Koede/robot-arm/renders_j1r2/mj11_leads/A_assembled_rear.png

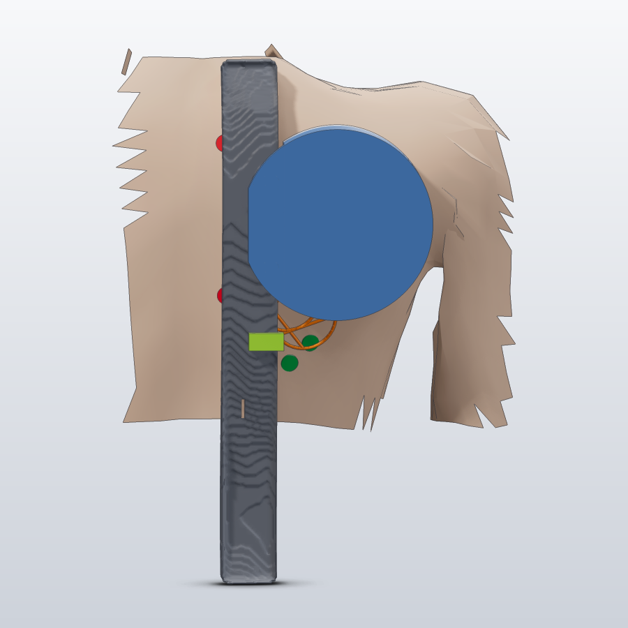
renders_j1r2/mj11_leads/A_assembled_rear.png
