Koede/robot-arm/DESIGN_STATE.md

# Third Shoulder — DESIGN_STATE (reconstructed)

> **Reconstructed 2026-10-25** from the repository: script docstrings in `cad/`, result JSON in `stl/`, logs, `specs/SPEC_collision_method.md` and `docs/DESIGN_STATE_ADDENDUM_2026-10-22.md`. The original DESIGN_STATE.md (about 40 KB, kept in the claude.ai project) was not available. Section numbers follow the references in the addendum (section 2 = joints, section 4 = harness/sensing, section 11 = integration); other numbering is new. Decisions, rationale and history that only lived in the original are missing; anything not traceable to a file here is left out rather than guessed. If the original turns up, it wins: merge this file's section 11 and changelog into it and delete this one.

Wearable supernumerary robot arm ("third shoulder"), one per shoulder, described as CAD-as-code. Right arm is generated; left = mirror in y (`*_L.stl`). Units mm, deg, N, N m, g.

## 1. Architecture

7 DOF + gripper per arm: S1, S2, S3 (concurrent shoulder axes through P), E (elbow), W1 (forearm roll), W2, W3 (2-DOF wrist), G (claw).

| Joint | Actuator | Source |
|---|---|---|
| S1, S2 | CubeMars AK70-10 (dia 89 x 50.25, 621 g, 8.3 N m rated / 24.8 peak, 24/48 V) | `shoulder_stage.py`, vendor-verified |
| S3, E | Dynamixel XM540-W270 (33.5 x 58.5 x 44, 165 g, 10.6 N m stall @ 12 V) | `shoulder_stage.py`, `upper_arm_elbow.py` |
| W1, W2, W3, G | Feetech STS3215 (55 g) | `distal_arm.py`, `claw_hand.py`, `verify_distal.py` |

Standing design language: ball-and-socket styling at every joint, passive hard stops with TPU capsule facings, DOF and actuator count unchanged by restyling.

Load path: stage -> pauldron -> 8 mm 6061-T6 chassis plate -> scapular frame / spine bridge -> hip belt. The faceted clasp locates sEMG pads and does not carry the arm.

## 2. Frames, kinematics, joint limits

Robot frame (right arm): origin P = shoulder centre where S1/S2/S3 meet; +x rearward, +y lateral (wearer's right), +z up. Arm rests pointing up (+z) at q = 0. Positive S2 swings the arm forward (-x). Human elevation = 180 - S2.

Chain (`arm_kin.py`): R1 = Rz(-S1); R2 = R1 Ry(-S2); R3 = R2 Rz(S3); RE = R3 T(0,0,230) Ry(-E) T(0,0,-230); RW1 = RE T(0,D,0) Rz(W1) T(0,-D,0); RW2 = RW1 T(0,D,Zw) Ry(-W2) T(0,-D,-Zw); RW3 = RW2 T(0,D,Zw3) Rx(W3) T(0,-D,-Zw3).

Layout (`stl/distal/distal.json`): elbow axis at z 230; D = 57; Zw = 410; Zw3 = 455; claw tip Z_TIP = 575. Kinematic groups: F (fixed stage + harness), M1, M2, M3, ME, MW1, MW2, MW3 (hand = W3 frame). The product-of-exponentials form in `collision_screw.py` matches `arm_kin.frames` to 1.7e-13.

Joint limits (`rom_limits.py`, single source; hard = soft +- 5, except S1 max):

| Joint | Soft | Hard | Park | Meaning |
|---|---|---|---|---|
| S1 | 10..140 | 5..150 | 45 | arm-plane swing; medial limit from head keep-out |
| S2 | -30..88 | -35..93 | 25 | elevation from up-rest; back lean capped by head keep-out |
| S3 | -70..90 | -75..95 | 0 | humeral rotation |
| E | 0..145 | -5..150 | 45 | elbow flexion |
| W1 | -80..80 | -85..85 | 0 | pronation / supination |
| W2 | -70..80 | -75..85 | 0 | wrist ext / flex |
| W3 | -20..30 | -25..35 | 0 | radial / ulnar |
| G | 0..100 | -5..105 | 50 | gripper % |

Rev 2026-10-12c (I1): S1 soft min -15 -> +10, S2 soft min -55 -> -30 because the straight arm came within -10 mm of the MakeHuman head/neck. Inside the new box the straight-arm capsule (P -> 590 mm, r 32) clears the head by >= 64.9 mm, so the passive stops alone keep a stretched arm out of the 60 mm head keep-out.

Software elbow tiers (`stl/elbow_limits_15mm_restricted.json`, from `sweep_full.py --restricted`): largest E with >= 15 mm to body/harness and >= 60 mm to head, per (S1, S2); -1 = no safe E. Examples: S1 10 / S2 >= 71 -> -1; S1 140 / S2 -30 -> -1; most of S1 62..140 allows 120-145. Not yet regenerated after the cowl / pauldron rebuild (section 11).

## 3. Shoulder stage and housings

- Stage parts (`shoulder_stage.py`, `stl/shoulder/meta.json`): s1_base 204.8 cm3, s1_clamp 33.6, s1s2_yoke 121.5, s2_clamp 36.9, s2_adapter 79.7, s3_bracket 103.4, s3_lid 12.7.
- Shoulder stops (`ball_stops.py`, `stops/stops.json`): S1 lug under the yoke disc striking two posts at r 54.75 (contact 5 / 150); S2 pads at -35 / 92. TPU 95A capsule pads, ~35 % strain at AK70 peak (459 N at r 54). TPU thickness S1 11, S2+ 7.5, S2- 11 mm.
- Socket cowl + humeral-head dome (`shoulder_cowl.py`, rev 2026-10-13, Forest: "make the shoulders not giant spheres"): replaces the 188 mm / 146 g ball (`ball_shell.py`, retired). Cowl 149.7 x 65 x 110 mm, 91.9 cm3, 117 g PETG, wall p5 3.2 mm, slot gap 3.2 mm (< 4 mm, no fingertip entry, ISO 13857), split at x = 0. Dome R 43.8..46.4, 17.4 cm3, 22 g.
- Pauldron (`pauldron.py`, group F, rev 2026-10-13 faceted socket + strut web; rev 2026-10-23 curved deltoid shell): socket housing round S1, 3 struts to the plate rear face (2 x M4 each), wrap-arms to clasp nodes F4 (acromion) and F1 (upper trapezius). The lateral side is a swept arc, crown 12 mm off the deltoid, rim curled inboard, outer edge near y 85 instead of 98. Split for 256 mm build volume: core 99 g, arm_lat 4 g, arm_med 36 g (PA-CF), half-lap splices 2 x M4 x 16.

## 4. Harness and sensing

- Wearer: MakeHuman CC0 base mesh re-posed and placed in the robot frame (`wearer_makehuman.py --back_to_p 108`).
- Clasp (`clasp_shoulder.py` + `organic_connector.py`): faceted, flat pads tangent to the body carrying inward sEMG electrodes; single smooth-blended SDF frame, 144.5 cm3, watertight. Bridge feet F5 mid-trap, F1 upper-trap, F4 acromion, R1 scapula, seated at x -88. Pulled on by a 32 mm webbing strap.
- Chassis plate (`chassis_axilla.py`): 6061-T6, 154 x 114 x 8 mm, x -88..-80, 18 holes, min web 10.7 mm, 338 g. Pocketing study `plate_pocket.py` (-80 g target, Morley/P2 FE, limit loads 24.8 N m about each axis + 75 N).
- Axilla cradle + front strap: cradle at (-183, 7, -262); strap 32 mm, 10 N spec, path 169 mm; edge to axilla apex 27.1, plexus proxy 64.2, AC joint 100.4 mm; max width-averaged line pressure 6.8 kPa at spec tension.
- Scapular frame (`scapular_frame.py`): the wing contacts only the paraspinal strip and bridges over the blade, which slides 5-10 cm under the skin at full elevation. Wing 108.6 cm3 / 125 g CF-PA; spine bridge 24.8 cm3 / 28 g; rail gap 7.5-15.8 mm, bridge gap 14-27 mm.
- sEMG atlas (`muscle_atlas.py`, rev 2026-10-14): bipolar pairs, 12 mm discs, IED 20 mm, sites from tape-measure landmark rules ray-cast to the mesh (`emg_rules.json`, `emg_atlas.json`). Rigid clasp pads on stable zones (delt_ant F2, pec_clav F3, ...); others on a compression base layer. Scapular bone landmarks are estimated and flagged. SENIAM pages were unreachable; rules come from secondary sources (B18, B20, Cram, IZ literature) and four textbook-only rules are flagged.

## 5. Upper arm and elbow

`upper_arm_elbow.py` (rev 2026-10-13b elbow ball): XM540 at the elbow axis (0, 0, 230), shell halves ua_lat 81.8 g / ua_med 84.6 g PETG, fork_drive 29.0, fork_idler 30.9, fork_bridge 18.1 g. Elbow is a ball-styled hinge: sphere R_E 44 (inner 41.6), fixed belt |y| <= 24.7 on the upper arm, moving polar caps on the forks with a 1.0 mm running gap. Hand calcs in `calc_elbow.py`.

## 6. Distal arm and claw

- `distal_arm.py` (I6): forearm root, W1 roll (pinion + internal ring gear, 6808-2RS bearing), distal forearm, W2 yoke. `distal_stops.py`: rigid sector posts with TPU 95A facings placed so first contact is at the hard stop (`stops_distal.json`).
- Claw C3 (`claw_hand.py`, `claw_synth.py`, `claw_asm.py`, session 2026-10-13g): three identical double-jointed curl fingers 120 deg apart, one STS3215 on the hand axis turning a 3-start helical rotor, punch ring on three steel pins drives all fingers. Hand tray 64.4 cm3. Envelope nearly G-independent (z max 562.1 / 563.5 / 562.5 at G 0 / 50 / 100). Pin retention (rev 2026-10-15, Forest-approved): each dowel pressed in one member, running in the other.

## 7. S2 gravity balancer (I1b)

`balancer_calc.py` (single source) / `balancer.py`, rev e 2026-10-15 (parts rev f): zero-length compression spring + Dyneema cord over a swivelling sheave, tau_b = K sin(S2), K = 3.78 N m. A = (0, 50, 22) on M1, B = (0, 50, 47) on M2.
- Spring: music wire d 3.2, OD 36.9, 7.5 active coils, k 3.65 N/mm, free 87.7, solid 30.4.
- Over 53,460 poses: no-balancer max 6.55 N m; minimax residual with balancer 2.89 N m. Peak cancellation 57.6 % at E 0 / 0.5 kg, 40.6 % at E 90, -15.9 % at E 145.
- Free-fall energy to the + stop: 4.69 J loaded (8.1 J without the balancer).
- AK70 S2 bearing: max radial 194.5 N, tilting moment 11.67 N m.
- Parts (PA12-CF unless noted): anchor 100.2 g, tubecap 20.8, piston 9.4, collar 42.0, collar cap 10.5, TPU buffer 7.8, swivel 11.7 (7075), sheave 2.3 (6061).
- Restricted sweep: balancer min clearance 20.0 mm, 0 poses below 3 mm.

## 8. In-arm wiring and electronics

- Method (`arm_wiring_lib.py`, `arm_wire_search.py`, `arm_chain.py`, `arm_wiring_verify.py`, `wire_audit.py`): per-group SDFs (`stl/electronics/_sdf/`), elastic-rod cable loops between printed clamps. Pass: clearance >= 2.0 mm robust, 0.8-2.0 marginal (sleeve), < 0.8 fail; bend radius >= k x OD; stretch < 3 %. Kinematic envelope, not mechanics; bench test T-W1 to confirm.
- Arm hub H1 (`arm_hub.py`): 12 V servo-bus distribution in the upper-arm tube (TVS, 2 x 470 uF, two resettable fuses), no MCU; buses driven by a Teensy in the main box. CAN termination plug at S2.
- Current loop audit (`stl/electronics/wire_audit_v2.json`, 16 combined poses each):

| Joint | L mm | min clr mm | min bend / need mm | fails |
|---|---|---|---|---|
| S1 | 250.6 | 5.06 | 33.2 / 34.7 | 0 |
| S2 | 298.8 | 9.63 | 40.6 / 28.4 | 0 |
| S3 | 176.4 | 0.80 | 21.8 / 28.4 | 2 clr, 7 bend (marginal) |
| E | 191.6 | 10.0 | 28.5 / 23.9 | 0 (new loop, 2026-10-22) |
| W1 | 203.1 | 0.80 | 13.3 / 13.2 | 3 clr |
| W2 | 97.5 | -2.18 | 2.8 / 13.2 | 6 clr, 6 bend (FAIL) |
| W3 | 111.3 | 0.09 | 5.9 / 12.0 | 4 clr, 2 bend (FAIL) |

- In-link runs vs anchor chord: E -> W1 (ME) run 22.3 mm for a 118.9 mm chord (ratio 0.19) and W1 -> W2 0.41 are invalid after the new elbow anchors.
- Through-axis routing is blocked on most axes (`axis_corridor.py`, `axis_offset.py`, `w1_axis.json`), hence external loops + soft boots (`render_boots.py`).
- Segmented fairing study (`fairing.py`, T 9): failed to build (meshes not volumes); no result.

## 9. Placeholders / unverified (do not print or order until replaced)

AK70-10 output-flange bolt pattern; XM540 horn protrusion, horn PCD / screw count, rear idler boss; S3 horn plane height; claw SHAFT_OFF, horn disc, servo ear pattern, rotor-to-horn fixing, TPU pad mu, CLAW_ZERO / CLAW_SIGN; balancer sheave shop part, cord MBL / splice / bend efficiencies, AK70 S2 bearing centre; hub component sizes marked T in `arm_hub.py` / `arm_wire_spec.py`.

## 10. Verification gates

- `gates.py` records every verify/sweep result in `stl/gates.json` (not in the repo yet; `gen_state_table.py` builds a table from it, also not present).
- Gate targets: part-part >= 3 mm, skin >= 2 mm, head >= 60 mm (software), elbow tiers 15 mm, torque SF = rated / required >= 2, stops first-contact at the hard angle.
- Check scripts: `verify_stops.py`, `verify_distal.py`, `verify_balancer.py`, `sweep_shoulder.py`, `sweep_full.py`, `arm_wiring_verify.py`, `wire_audit.py`.

## 11. Cross-subsystem integration (2026-10-22)

From `docs/DESIGN_STATE_ADDENDUM_2026-10-22.md` and `specs/SPEC_collision_method.md`:

- Wearer, atlas, clasp, connector, chassis, scapular frame, cowl and pauldron regenerated, all watertight.
- **Collision method (decision, Forest request 2026-10-22):** report and keep out only the first-contact frontier; deep contact poses are dropped. Default: separable pair tables (`collision_separable.py`, 4.5x fewer queries, exact). Certified Lipschitz refinement (`collision_screw.py`) only for fine or 7-D grids. Reference: `collision_frontier.py`.
  - Arm groups with cowl: 178 contact, 164 frontier, 14 deep.
  - The repo's `stl/electronics/collision_frontier.json` / `collision_separable.json` are the earlier no-cowl run (77 contact, all frontier).
- Arm vs wearer / harness (`collision_body.py`, not in the repo): 10,368 poses, 1099 contact, 802 frontier, 297 deep. By body: head 526, harness 221, skin 55. Nearest at park M1 -> harness 5.4 mm. Worst frontier: S1 10 / S2 30-45 / S3 50 / E 100-120, claw 29-30 mm from the head.
- Restricted full sweep (`stl/sweep_full_restricted.json`, 2592 poses, 1601 s; predates the curved pauldron meshes): min body -13.0, harness -8.4, head -4.3 mm; 181 contact poses, 179 inside the 60 mm head zone. The unrestricted `sweep_full.py` has not completed (`logs/sweep_full.log` empty).

## 13. Interface contracts (cad/interfaces.py, started 2026-11-03)

- **WING rail <-> J1 pad (MJ11), CHANGED:** bridge, tongue, 8 mm chassis plate and the J1 rev 2 riser are retired. Four new M4 heat-set (5.6 OD x 4) bosses on the rail rear face at z -160 / -220, y -113 / -105 (PLACEHOLDER positions); D10 PETG-CF spacers 4.8 mm (z -160) / 8.3 mm (z -220) to the pad plane x -97.5; 4 x M4 x 20 SHCS. Bolt load 231 N park / 312 N reach, insert pull-out 1 kN UNVERIFIED (bench T-W-INS). Open: trap_low electrode is 1.9 mm from the z -220 spacer and three pairs lie under the rail (`specs/SPEC_j1r2_mj11_leads_shear.md` s1).
- **S1' AK70 <-> pad:** flange pattern PLACEHOLDER (6 x M4 on 60 PCD position-only, other candidates listed in `cad/interfaces.py`); never print.
- **Electrode leads <-> jack:** PROPOSED, not built: ASSUMED 16-way keyed header on the rail rear face at (y -108, z -272), lead OD 2.2 mm, R_min 22 mm.
- Left-over: `stl/j1r2/interfaces_j1r2.json` still describes J1 rev 2 (riser) and is superseded for the WING boundary.

## 12a. HAND rev B: the project hand (adopted by Forest 2026-10-30; IN DESIGN, not locked)
See `specs/SPEC_hand.md`. **Forest (2026-10-30): "Merge this as the new project hand".** The hand replaces the C3 claw as the arm's end effector. The claw scripts and STLs stay in the repo as the superseded alternate.
- **Wrist integration open:** branch `claude/hand-coupling-2026-10-30` holds Forest's plane-to-plane wrist (wrist v3: compliant W3, powered R roll, `specs/SPEC_wrist_rotary.md`). It is built on the rev-A hand and not merged. Rev B still mounts on the old W3-ear contract, so porting rev B onto plane B is the next integration step.
- 8 micro servos, organic ball-jointed fingers with hidden four-bars.
- Chuck modes: 4-jaw on Ø13 and 3-jaw on Ø6, bit along the palm normal.
- Poses: open / point / thumbs-up / victory. No real-mesh interference in any pose.
- Hand 223.9 g (+45.0 g). Wrist-to-tip 214 mm.
- Holding torque 0.012-0.024 N.m.
- **Not locked:** the contract change, unrun sweeps and harness confirmation.

## 12-pre. MJ11 subsystem registry (2026-11-03)
| subsystem | status | note |
|---|---|---|
| SHOULDER (J1 = MJ11 pad, fairing, S1'/S2/S3) | IN DESIGN | bracket + fairing re-fit merged; torque gate open (Forest) |
| WING (rail + 4 M4 bosses) | IN DESIGN | bosses PLACEHOLDER; L3 layout proposed |
| CLASP (bracket psi 119, r 66) | IN DESIGN | all gates met; lap fastening PLACEHOLDER |
| SENSING (leads / liner shear) | IN DESIGN | rail-over-electrodes conflict and lead architecture: Forest |
| CONTROL (tier tables, keep-outs) | candidate only | not adopted; headers not drop-in |
See `specs/SPEC_j1r2_mj11_overnight_summary.md`.

## 12. Open items

1. **W2 / W3 loops.** The 30-base re-search (`run_local.sh`) did not finish: W2 stopped at 75/400 candidates with 1 marginal hit (clr 0.80, bend 13.2), W3 at 8/400 with 1 marginal hit (clr 0.80, bend 12.1). The `wire_search_W2_CB.json` / `W3_CB.json` in the repo are from a 12-base run. If it still fails: firmware limit W1 >= -30 deg when E < 60, or a rubbing sleeve. **Forest to decide.**
2. In-link runs, arm_chain DP, hub link, clips and boot sizes for the new elbow anchors.
3. `sweep_full.py` (both modes) on the current cowl / curved pauldron, then the firmware keep-out tables (`gen_tables.py`). **MJ11 update 2026-11-03:** whole-arm sweep done on MJ11 and candidate tier / keep-out tables written (`specs/SPEC_j1r2_mj11_whole_arm.md`); still open: Forest's decision on the keep-outs, hand-envelope refinement, and porting control.h / protocols.h to S1' before any header is adopted.
4. Harness top-pad margin (2.0 %) vs boot mass (~99 g per arm at 0.7x TPU wall): `harness_loads.py` needs `sensor_pods.py` + `electronics_fit.py`.
0. **(2026-11-03) Forest decisions from MJ11 leads study:** (a) rail over trap_mid / rhomboid / trap_low vs flex-lead decision (A windowed rail / B move pairs / C keep stack); (b) lead architecture under the liner (L1 flat trace / L2 aligned channels / L3 coiled); (c) accept lift-off at reach given the 0.11 kPa preload window.
5. Pad stall cap: AK70 S1/S2 cap 8.3 -> 8.0 N m (pad stall limit 16.6 N m: 2.00x at 8.3, 2.075x at 8.0); S2 torque SF with the balancer stays 2.77. **Forest to decide.**
5. MJ11 torque gate / balancer (2026-11-03 options in specs/SPEC_j1r2_mj11_loads_balancer.md) and pad stall cap: AK70 S1/S2 cap 8.3 -> 8.0 N m (pad stall limit 16.6 N m: 2.00x at 8.3, 2.075x at 8.0); S2 torque SF with the balancer stays 2.77. **Forest to decide.**
6. Bench / parts items: S2 free fall T12 (phase-short braking f >= 0.80), relays, 1.10 s off-delay stage, main-box heat, bench test T-W1.
7. Missing from the repo: `collision_body.py`, `gen_tables.py`, `gen_state_table.py`, `harness_loads.py`, `sensor_pods.py`, `electronics_fit.py`, `balancer_freefall.py`, `balancer_struct.py`, `arm_clips.py`, `control_map.py`; specs `SPEC_third_shoulder.md`, `SPEC_balancer.md`, `SPEC_ball_stops.md`; `stl/gates.json`; `stl/electronics/arm_vendor_data.json` and `arm_electrical.json`.

## Changelog (dated entries recoverable from the repo)

- **2026-11-03 (MJ11 leads, shear, interfaces; unattended, branch claude/mj11-leads-interfaces-2026-11-03):** nothing adopted, no geometry changed by default.
  - Leads: only infraspinatus and teres major lie under the liner; trap_mid, rhomboid, trap_low (6 discs) lie under the rail that MJ11 now bolts to (conflicts with the 2026-10-23 flex-lead decision); trap_low is 1.9 mm from a spacer. The 8 mm radial channels cannot carry a lead that rides on the base layer (across-axis follow 22..55 mm vs 2.9 mm allowed); the spec's R18 serpentine violates the 22 mm bend rule; one R22 loop per lead is needed. Options L1/L2/L3 and A/B/C for Forest.
  - Shear: preload window to avoid lift-off and stay under 4.3 kPa is only 1.98..2.09 kPa; skin shear 0.4..1.7 kPa with a working slip face (mu 0.1..0.4 ASSUMED), 2.5..4.2 kPa without; flash heat +0.04..0.16 K/stroke.
  - New cad/interfaces.py, section 13 here, bench list T-W-INS / T-L-SHEAR / T-L-RIDGE. See specs/SPEC_j1r2_mj11_leads_shear.md.
- **2026-11-03 (MJ11 loads + balancer options, analysis):** harness_loads/body_loads not in repo, cases ported to the MJ11 frame (`cad/j1r2/mj11_loads.py`). Bolt worst 228/310 N park/reach (327 scan, 707 stall, x2 SF 1.4-1.6 vs 1 kN UNVERIFIED); 3rd bolt pair z -150/-190/-230 gives 184 / 413 N (SF 2.7 / 2.4). Strap cannot preload rail/liner (needs ~110 N vs ~15 N allowed): unload 0.2-0.3 mm accepted unless donning squeeze. Top pad: 14.4 kPa (2.0 %) unchanged without balancer, balancer (a) fails (-3.4 %, needs +3.8 % area). Gravity torque over the REAL MJ11 workspace: S1' 7.24 (SF 1.15), S2 4.61 (SF 1.80, 3.60 in the passive box). Options (a) refit spring psi 100-130 SF 2.5-3.0 with a lower-back tube home, (b) cap 4.15 keeps 49 % of poses at 0.5 kg, (c) no payload reaches SF 2, (d) ideal cams 2.8 / 2.2. **Forest to decide.** `specs/SPEC_j1r2_mj11_loads_balancer.md`.

- **2026-11-02 (J1 mount alternatives, concept):** Forest: "Explore alternative designs for the shoulder mount" (J1 pancake mount).
  - Seven mounts (REF + MJ1..MJ6), all on one harness frame model and checked against the J1 stage, your range of motion and the skin rules.
  - REF findings:
    - 18 mm hand-tip sag at reach;
    - neck extension contact at 27.5 deg;
    - clasp feet orphaned;
    - the verified wing tongue clashes with the riser;
    - the balancer still has no home.
  - Recommended: MJ4 carbon K-truss with MJ1's in-tube balancer.
  - See specs/SPEC_j1r2_mount_alternatives.md and specs/DESIGN_STATE_ADDENDUM_2026-11-02.md.

- **2026-10-30c (decision):** Forest adopted HAND rev B as the project hand ("Merge this as the new project hand"). Squash-merged `claude/hand-chuck-2026-10-30` into `main`. The C3 claw is now the superseded alternate. The wrist-v3 branch (`claude/hand-coupling-2026-10-30`, rev-A based) still has to be re-integrated with rev B. The open gates from SPEC_hand section 6 carry over.

- **2026-10-30b (HAND rev B):** rev A rejected by Forest ("this looks terrible"). Rebuilt with the human layout first: human knuckle arch, palm centred on the wrist, SDF organic phalanges with ball knuckles (restoring the standing ball-joint rule), hidden four-bars, TPU caps, sculpted palm. Chuck re-solved as a bunched-fingertip pinch: 4-jaw Ø13 (94/83/93/90 deg) and 3-jaw Ø6. New three.js renderer `cad/render_three.py`. Mass 328 -> 224 g; harness estimate now passes (0.6 % margin). Removed rev-A study scripts and outputs.

- **2026-10-30 (WRIST + GRIPPER, HAND):** new human-layout 5-digit micro-servo hand with a drill-chuck mode and 👉 👍 ✌️ poses. Added `cad/hand_kin.py`, `hand.py`, `hand_pose.py`, `verify_hand.py`, `thumb_solve.py`, `render_hand.py` (+ scan studies), `specs/SPEC_hand.md`, `stl/hand/` (34 parts, 5 posed STLs), renders `hand_*.png`. Findings: yaw hinge tilted 45 deg serves both chuck and V-sign; stair-stepped knuckle row (index 498 / ring 535 / middle 558) and a deeper middle finger plane were required for a chuck pose without finger interpenetration; thumb needs 2 CMC axes + built-in 190 deg roll; thumb force (3.4 N) limits chuck grip to 0.018 N.m. Open: harness top-pad FAIL est. 14.87 kPa, wrist-to-tip contract 165 -> 219 mm, pinky crank, full sweeps/keep-out tables not re-run, vendor servo geometry PLACEHOLDER. Decisions needed from Forest: SPEC_hand section 5.

- 2026-10-12c (I1): head keep-out limits (S1 soft min +10, S2 soft min -30); TPU capsule stop pads; ball slot follows S2 hard range.
- 2026-10-13: shoulder cowl + dome replace the 190 mm ball; faceted clasp and pauldron (Forest: "facet it to my shoulder"); ball shell split in halves.
- 2026-10-13b: ball-styled elbow.
- 2026-10-13d/f/g: parallel gripper replaced by the claw; C3 punch-ring claw; sweeps unified on the claw at G 0.
- 2026-10-14: sEMG muscle atlas rev; distal masses from meshes (verify_distal 14h).
- 2026-10-15: S2 balancer rev e (zero-length spring); claw pin retention and servo ear pattern.
- 2026-10-17: wire / connector vendor data retrieved (`arm_vendor_data.json`).
- 2026-10-22: harness rebuild, collision method, collision_body, new elbow loop (see section 11).
- 2026-10-23: pauldron lateral shelf replaced by the curved deltoid shell; meshes regenerated.
- 2026-10-25: this file reconstructed from the repo.
- 2026-11-02b: J1 mount round 2 (spine-led, no balancer): MJ7/MJ8/MJ10 evaluated, see specs/SPEC_j1r2_spine_mounts.md and specs/DESIGN_STATE_ADDENDUM_2026-11-02b.md. Open: mount choice and the no-balancer torque-gate decision (Forest).
- 2026-11-02c: MJ11 blade-seated pancake (Forest: pancake holder flat against the shoulder blade; chose "rides on the blade" = override of the no-rigid-on-moving-skin rule for this concept only). Pad moved to (y -60, z -190, standoff 12): flat pad on a conformal PA-CF dish + 8 mm foam/slip liner, 4 x M4 straight into the rail; 187 g, tip sag 0.85 / 1.81 mm, no ROM contact. Cost: passive-box coverage 0.776 -> 0.466, reach-free 0.898 -> 0.786. Merged to main by Forest's request; J1 rev 2 (pad +10, -30) remains the default in code (J1_PAD env selects the pad). See specs/SPEC_j1r2_blade_seat.md. Open: no-balancer torque gate (SF 1.14), clasp bracket vs arm 2.0 mm, skin shear + lead routing, fairing re-fit, WING contract (rail bosses), pad position choice.
- 2026-11-02d: **DECISION (Forest): MJ11 blade-seated pancake adopted as the new J1 shoulder joint** ("I like this as the new shoulder joint"). Pad (y -60, z -190, standoff 12) is now the default in cad/j1r2/mj_frame.py (J1_PAD env still selects J1 rev 2 = 10,-30,22). SHOULDER + WING status: IN DESIGN (was concept). Standing-rule exceptions he accepted: (a) the dish liner rides on skin over the moving blade (slip-faced 8 mm foam; rigid parts keep >= 5 mm); (b) the pad overlaps the paraspinal rail (WING contract: new M4 bosses on the rail rear face, bridge + tongue + chassis plate retired). Accepted cost: passive-box coverage 0.466, S2 limited to park (17.4). Superseded for J1: riser/standoffs/fairing_lap, MJ1..MJ10 mounts. Downstream re-runs still TO DO: fairing re-fit to the new pad; clasp bracket (2.0 mm to arm sweep); full-arm sweep + tier tables + firmware keep-out tables; harness_loads / body_loads; balancer decision (no balancer: S1'/S2 SF 1.14 / 1.26, gate fails: Forest's call); cable run; lead routing + skin shear check of the liner; rail boss + AK70 flange details (PLACEHOLDER).
- 2026-11-03: MJ11 clasp bracket re-fit (SHOULDER/CLASP, branch claude/mj11-clasp-bracket-2026-11-03): anchor psi 120 -> 119, anchor radius 58 -> 66 (pad rim), bar 24 x 6 unchanged. Bracket vs S1' group 2.03 -> 4.82 mm inside the passive box +-5 deg (arm 17.0, hand 18.8), rail 5.1 mm, spine bridge 20.1, skin blade 5.4 / rail 21.8 (all gates met). Passive box unchanged (S1' -95..5, S2 -15..17.4, cov 0.466). Finding: M1 | bracket was masked as designed contact; S1' now reaches the 3 mm gate at +13.4 deg (reach-free 0.706 vs 0.786), so the firmware S1' keep-out follows +13 deg. Bar-to-pad lap fastening PLACEHOLDER. See specs/SPEC_j1r2_blade_seat.md.
- 2026-11-03: MJ11 fixed fairing re-fit (SHOULDER). New part `fairing` in cad/j1r2/mj_concepts3.py: 1.8 mm PA-CF C-shell on the pad rear face over the S1' AK70, outline = pad R66 trimmed y -121 (flush with pad and dish edge), swept slot for the S1' bar / S2 clamp as in j1r2_geom (gap 3.2), liner lead channels psi 225/270/315 open, gland bore psi 190, 3 tabs M3 x 5 into short inserts in the pad (pad got 3 holes, PLACEHOLDER). 42.7 g (mount 229 g). Clearance over the hard ranges: moving stage >= 3.2 mm (S2 clamp 3.2, collar 4.2), skin 24.4, rail 9.7, spine bridge 5.8, clasp bracket 3.0. Sweep: passive box unchanged (S1' -95..5, S2 -15..17.4, cov 0.466); free reach beyond stops 0.786 -> 0.706. Prints end plate down, 81 x 94 x 112 mm, no split. New check script mj11_fairing_check.py (called from mj_eval). Old J1 rev 2 fairing_fixed stays excluded. Open item 3 of the MJ11 to-do (fairing re-fit) closed; gland position and cable run remain. See specs/SPEC_j1r2_blade_seat.md.
- 2026-11-03: MJ11 loads + torque gate options (`specs/SPEC_j1r2_mj11_loads_balancer.md`). Port of harness/body loads onto MJ11 frame; bolt tension (V0 620 N x2) governs, V4 3-pair layout recommended (SF 3.3); strap cannot supply lift-off preload (56-112 N/side). S1' fails SF gate (7.24 N.m, SF 1.15; empty 1.91), S2 passes in the MJ11 box (SF 2.30). Options a-d tabulated; balancer packaging scan incomplete (cord vs M1 0.3 mm). No geometry/firmware change; decisions pending Forest.
- 2026-11-03: MJ11 whole-arm first-contact sweep (S1' x S2 10 deg, S3 {-70,0,90}, E 20, W1/W2/W3 3 values, 170,100 poses, 534 s): 32.5 % reach-free, 20.6 % frontier, 46.8 % deep dropped; passive box S1' -95..5 / S2 -15..17.4 (cov 0.466) unchanged. Shoulder keep-outs (M1-M3 S2 -21.9; M3 vs clasp bracket S2 28..40 at S1' 5..-7; M3 vs head 60 mm S1' 9.5..35; M3 vs skin S2 33..44) and candidate FULL / RESTRICT / NEUTRAL elbow tables + keep-out map in `stl/j1r2_sweep/` (park cell FULL 0 / RESTRICT 120 / NEUTRAL 0). Firmware headers NOT adopted: gen_tables.py inputs are legacy-geometry, balancer / grav tables not regenerable without a balancer, control.h axes still legacy S1. See `specs/SPEC_j1r2_mj11_whole_arm.md`. Branch claude/mj11-whole-arm-sweep-2026-11-03 (Forest to review).
- 2026-11-03 (integration): merged clasp, fairing, leads/interfaces, loads/balancer and whole-arm branches into main (variant branches not merged); re-ran mj_eval MJ11, mj11_sweep and the whole-arm chain on the merged parts: passive box unchanged (S1' -95..5, S2 -15..17.4, cov 0.466), reach-free 0.706, whole-arm reach-free 30.1 %, new keep-outs M1|fairing +11.9 / M1|bracket +13.5 deg (beyond the hard stop). Torque gate (S1' SF 1.15) still fails without a balancer: Forest's decision. See `specs/SPEC_j1r2_mj11_overnight_summary.md`.
