Koede/robot-arm/specs/SPEC_j1r2_balancer.md

# SPEC: J1 rev 2 gravity balancer, stops and free fall (S1' + S2), 2026-11-01. Script cad/j1r2_balancer.py, data stl/j1r2_bal/j1r2_balancer.json. CONCEPT (not locked).
Frame/axes: j1r2_params.py (S1' about +x through (y1,z1) = (-70,-35); S2 axis s = (0, cos th1, sin th1); arm dir d = a cos phi - xhat sin phi). Mass model: arm beyond S2 1489 g (CG ~250 mm), payload 0/0.5 kg at the 575 mm tip, forearm offset 57, AK70 0.621 kg + yoke 0.15 kg on S1', balancer arm side 52 g.
## 1. Result
Unbalanced worst case (12960 poses, th1 -95..35, phi -30..88, E 0/45/90/145, S3 -70/0/90, payload 0/0.5): **S1' 7.31 N.m (SF 1.14), S2 6.59 N.m (SF 1.26)**. 
**One** world-anchored spring balances **both**: residual **S1' 2.95 / S2 2.94 N.m -> SF 2.81 / 2.82 vs 8.3 rated** (cap 8.3; S3 cap 4.8 unchanged). k +-5 %: SF >= 2.68; cord length +-2 mm: SF >= 2.73; with 5 % friction hysteresis SF 2.64. Empty arm residual S1' -1.47..2.40, S2 -1.60..2.22; loaded S1' -2.95..2.88, S2 -2.94..2.46.
## 2. Mechanism and why S2 must NOT be yoke-anchored
Zero-length-type spring (F = k (|AB| - L0), cord over a swivel sheave, 2:1 tackle, compression spring in a guide tube) between **A fixed on the pad** and **B on the upper arm**. Moment on the arm = (B - P1) x F, F = k (A - B). With A above P1 this equals the gravity moment of the arm about the S1' axis (y-lever) AND about the S2 axis (proportional to sin phi cos th1), so the cos th1 coupling is automatic. A baseline-style yoke-anchored S2 spring gives only K sin phi, independent of th1: with a separate phase-shifted S1' spring (K 3.9 N.m, phase -55 deg) the best decoupled pair leaves **S1' 4.34 N.m (SF 1.91, FAILS 2.0)**, S2 3.55 (SF 2.34). The real mechanism for the yoke case would be a gimbal that counter-rotates the anchor by -th1 (extra parts); the pad anchor avoids it.
Parameters: A = P1 + (-10.0, -19.7, +73.4) mm (world (-55.0, -89.7, +38.4); r 76 mm from the S1' axis, 105 deg in the yz plane, beside the S1' motor R44.5 so the cap (R28) clears it by 3.5+ mm); B = arm local (-15.6, -42.3, 118.4) (lug 13 mm off the R32 tube); k_cord 0.752 N/mm; L0 54.6 mm; cord length 60..200 mm; **F_cord max 109 N (SF 10.6 vs 1156 N usable Dyneema 1.5 mm), spring force max 218 N at 2:1**. Search: DE over A, B, k, L0 on the full grid with penalties (anchor on the pad rim 70..110 mm, cord <= 200 mm, force <= 260 N, anchor sector 105..230 deg so it is outside the S2 motor's swept sector); the unconstrained optimum (A 112 mm above, 2.59 N.m) was rejected: it needs a 112 mm pylon.
## 3. Packaging (UNRESOLVED, flagged)
Spring (A228, wire 3.5, D 36, 10.7 active coils, k 3.01 N/mm, stroke 2.9..72.6 mm, tau 528 MPa = 0.29 Sut, mass 108 g) needs a **230 mm tube at 2:1** (175 mm at 3:1, 328 N; 151 mm at 4:1, 437 N: `spring_options_by_tackle`). Tube directions tried (`balancer_parts(D, th1, phi, tube_dir)`): lateral (collides with the arm and S2 motor: FAIL), medial (1.3 mm to the yoke group, crosses the spine), **radial (away from the axis): soft box census (378 poses, 3 mm gate): tube vs yoke group 0 hits (min 6.7 mm), vs arm 0 hits (58.7 mm); but the tube end rises to z +184..+260 beside the neck/head (head keep-out 60 mm: NOT MET)**. Cord vs yoke/S2 motor hits at th1 -95..-70 (20 / 378 poses); collar vs tube at th1 +35 (4 / 378). Fixes to try in the sweep/optimise pass: 4:1 tackle + folded tube, move A (cost: residual), reroute cord on a second sheave at the yoke, shave th1 soft range, or a different spring form (cam + torsion spring).
Masses (g): tube 96, cap 31, post 34, spring 108, piston 28, sheaves 9 (+ movable pulley), cord 1, bearings 24, hardware 23 -> fixed side ~355; arm side (collar 40 + pin 12) 52. **Total 406 g for both axes vs 658 g for two baseline-style balancers (-252 g)**; vs the single baseline S2 balancer (329 g) +77 g.
## 4. Stops and free fall (energy only; pad pressure NOT re-run: body_loads needs the project solver/mesh)
Released from rest at the worst start (other axes frozen), unbraked, energies into the HARD stops (S1' -100/+40, S2 -35/+91): **S1' +4.51 J, -5.61 J; S2 +1.92 J, -4.34 J** (balanced). Unbalanced values in the json. Baseline S2 was 4.69 J loaded (+) / 0.51 J (-), so the single spring shifts S2's worst case to the NEGATIVE stop (4.34 J), and S1' is a new 4.5-5.6 J case.
Bumpers: S2 unchanged (+22.1 N.m 1.00 J, -16.8 N.m 0.98 J). S1' (posts r 54, TPU 95A, 3 blades x 14 mm): plateau 20 N.m = 370 N, blade t 1.29 mm, 4 mm usable crush -> **1.33 J** each side (t ~ F^(1/3) scaling of the baseline blade; coupons needed).
Braking needed to meet the baseline pass boundary (residual energy Er = W(1-f) - E_b <= 0.07 J): **S1' + f 0.69, S1' - f 0.75, S2 + f 0.44, S2 - f 0.76**; i.e. the T12 target f >= 0.80 still covers every case, but **T12 must now measure S1' too**. Without braking every stop fails. Plan unchanged: NC phase-short relay on BOTH AK70s (hardware, MCU independent).
## 5. Spring failure
A snapped spring drops up to **5.1 N.m on S1' and 4.4 N.m on S2** simultaneously (< 8.3 caps; the arm sags under gravity, both axes see the step). spring_check (band + 0.6 N.m + 10 %): detection coverage **93.6 % with the learned payload, 33.8 % with the full 0..0.5 kg band** (lower than the baseline's 82.7 %/95.3 % full/learned because the payload band is wider relative to the spring term in the new geometry; needs the payload_learn grasp). Firmware: grav_model.h gets s1p_grav_eval and the pad-spring term (cord length |AB|(th1, phi), F = 0.752 (|AB| - 54.6)); the S2 model changes from K sin S2 to the th1-coupled r x F; spring_check runs on both axes; constants A, B, k, L0 in protocols.h; keep-out tables regenerate.
## 6. Loads / BOM / placeholders
The cord pulls the arm toward A with up to 109 N (spring side 218 N): radial load on the AK70 S2 output bearing ~110 N at the cord, tilting moment about the bearing centre ~ 9 N.m (lever ~ 85 mm): **CubeMars bearing rating not retrieved: PLACEHOLDER**. Vendor PLACEHOLDERS: spring, Dyneema MBL/creep, sheave DU bush, 6800ZZ, AK70 bearing. T20 acceptance test applies to the new spring. Re-run: sweep (cord/tube), harness_loads (+77 g fixed side vs one baseline balancer, -252 g vs two), body_loads for the S1' stop and S2 stop moment arms, verify_assembly.
