Koede/robot-arm/specs/SPEC_j1r2_integration.md

# SPEC: J1 rev 2 integration + full collision sweep (SHOULDER / WING / CONTROL), 2026-11-01
Forest: "Pancake side hung maybe" -> "Assure the connections happen properly and integrate this into our full design" -> "Then do a full collision sweep to optimize local geometry". Overrides the standing ball-styled / concurrent-at-P shoulder decision (Forest's request); DOF, AK70-10 x2 + XM540 S3, passive stops, 5 deg rule, no backplate / hip belt kept. STATUS: IN DESIGN, not locked; the adopted baseline (rev b ball + plate) stays until Forest accepts the workspace result below.
Frame: S1' AK70 flat on a back-plane pad, axis +x through (y1, z1) = (+10, -30); S2 axis s(th1) = (0, cos th1, sin th1) in the back plane; d = a cos(phi) - xhat sin(phi); S3 XM540 on the arm axis (arm base 105.75 mm off the S1' axis); E, W1-W3 as baseline. Park = baseline S1 45 / S2 25 = th1 -18.2 / phi 17.4. Code: cad/j1r2_params.py, j1r2_geom.py, j1r2_kin.py, j1r2_balancer.py, j1r2_sweep.py, j1r2_integrate.py, j1r2_opt.py.
## 1. What changed in the connections
- **Mount: rail top end, not the wing tongue.** The swinging S2 motor sweeps over the lower back, so the tongue either collides or breaks the 20 mm blade rule. The pad's medial extension bolts through 4 standoffs (D10, 9-21 mm) to 4 new M4-insert bosses on the paraspinal rail. The 6061 chassis plate and tongue seat are retired. ALL arm loads now enter the rail top end: harness_loads, body_loads and verify_harness MUST be re-run (not done; top-pad margin was 2 %).
- Fixed fairing: one PA-CF shell (1.8 mm) around pad + S1' motor + riser; moving S2 sleeve. Crown / keel / spaulder shelf retired. Fairing does not yet wrap the rail lap.
- All 8 fastener shanks pass a clean-hole check; 0 mm3 interference between 24 checked pairs at park. Interface table: stl/j1r2/interfaces_j1r2.json; assembly: stl/j1r2/ASSEMBLY_j1r2.md.
- S1' stop posts are 4.3 mm tall (below the S2 motor swing), lug on a thin collar over the S1 motor; TPU bumpers at the HARD limits (5 deg beyond soft).
## 2. Balancer (cad/j1r2_balancer.py, SPEC_j1r2_balancer.md)
One world-anchored zero-length-type spring (pad point 76 mm off the S1' axis at 105 deg to a lug on the upper arm, 2:1 tackle, k 0.752 N/mm) balances BOTH axes: residual S1' 2.95 / S2 2.94 N.m, SF 2.81 / 2.82 (unbalanced 7.31 / 6.59, SF 1.14 / 1.26). 406 g vs 658 g for two baseline-style balancers. Free-fall energy S1' 4.51 / 5.61 J, S2 1.92 / 4.34 J: T12 must now measure S1' too (f >= 0.80 still covers every case). **UNRESOLVED: packaging.** The spring needs a 230 mm tube at 2:1 (151 mm at 4:1); a lateral tube hits the arm; a radial tube rises beside the neck and head (z +184..+260); the cord hits the yoke group in 20 of 378 poses. The obsolete yoke 'column anchor' was dropped from the sweep (it blocked 15 points of workspace coverage).
## 3. Kinematics / control (SPEC_j1r2_kinematics.md)
FK matches the nested chain to 1.7e-13. Tilting the S1' axis was rejected (3.5 pt coverage, +7.7 mm depth). Pole (arm along +-x) is 10.2 deg outside the baseline direction set: singularity guard + S2 soft max 75 recommended. Speed caps S1' 44.3, S2 45.7, S3 71.2, E 72.7 deg/s. Firmware tables NOT regenerated (control.h, protocols.h, gen_tables inputs, elbow/keep-out tables, balancer_keepout.h, grav_model.h all change: S1' now carries gravity).
## 4. Local-geometry optimisation (pad y1, z1, anchor)
Score = share of the baseline arm-direction set that is (a) reachable contact-free from park (software keep-out allowed) and (b) inside the largest passive-stop box whose +-5 deg hard-stop expansion is free. Scan 24 pad positions + anchor angle:
| pad (y1, z1) | reach-free | passive box |
|---|---|---|
| (-70, -35) baseline J1 | 0.00 (park inside the 60 mm head/neck gate, 52 mm) | - |
| (-10, -30) | 0.891 | 0.724 |
| **(+10, -30) chosen** | **0.898** | **0.776** (S1' -75..25, S2 -15..50) |
| (+30, -30) | 0.904 | 0.831 (riser 20 mm longer, skin 15 mm) |
Removing the column anchor lifted reach-free coverage from 0.74 to 0.90 at the chosen pad. Depth behind the back 112.4 mm (baseline 181), printed fixed mass about 149 g.
## 5. Full sweep (cad/j1r2_sweep.py; 170,100 poses: S1' x S2 10 deg, S3 {-70,0,90}, E 20 deg, W1 {-80,0,80}, W2 {-70,0,80}, W3 {-20,0,30}; soft range; 530 s)
42.6 % of poses touch something, 57.4 % are reachable contact-free from park, 25.5 % of the grid lies beyond the frontier and is dropped per the first-contact method. Frontier cells by moving group: M1 605 (hand-vs-yoke 442), M2 20, M3 21, ME 124, MW1 2010, MW2 11232, MW3 43071; the hand/wrist groups dominate because the hand envelope is a conservative +-60 mm box. Shoulder-level first contacts to keep out (limits / tables, not geometry):
- upper arm (M3) vs head 47.1 mm (< 60 gate) at S1' 35 / S2 40 / S3 90 -> S1' soft max 30 or keep-out;
- M2 / M3 vs wearer skin at S1' -95 / S2 50 -> S1' soft min -90 or S2 cap 45 for S1' <= -85;
- M1 vs M3 (yoke group vs upper arm) at S2 -30 / S3 -70 -> S2 soft min -25 at S3 -70;
- hand and wrist groups vs fairing, riser, head, skin: need elbow/wrist tier tables (FULL / RESTRICT / NEUTRAL) regenerated from the tables in stl/j1r2_sweep/tables_j1r2_full_final.npz (not generated).
## 6. Open items
1. Harness / body loads re-run (loads enter the rail top end). 2. Balancer packaging. 3. Cable run: min bend 9.1 mm < 12.6 mm ribbon rule; tube proxies penetrate rail 2.3 mm and S2 motor 2.1 mm; the 8.2 mm bundle cannot turn 90 deg into the gland in the 16 mm gap (ribbon or a 45 deg gland). 4. Riser skin gap 17 mm over the blade (< 20 mm rule): shave or raise. 5. Tier tables + firmware regeneration, homology map port. 6. AK70 / XM540 flange patterns, S2 clamp ears: PLACEHOLDER. 7. Wing and F1/F4 seat positions are proxies; hand envelope conservative. 8. Pad y +30 gives 0.83 passive coverage for 20 mm more riser: Forest's call. 9. GitHub push not done (repo access denied). 10. The balancer fit (A anchor, k, L0, residuals) and the kinematics head/neck study were computed at the old pad (y1 -70, z1 -35): re-run both at (+10, -30). The kinematics study's passive-box coverage at y1 +10 (0.940) counts only a straight arm against the head; the sweep's 0.776 includes skin, fairing and riser contacts, and is the number to use.
