Koede/robot-arm/hand_chuck3_d6_sheet.png

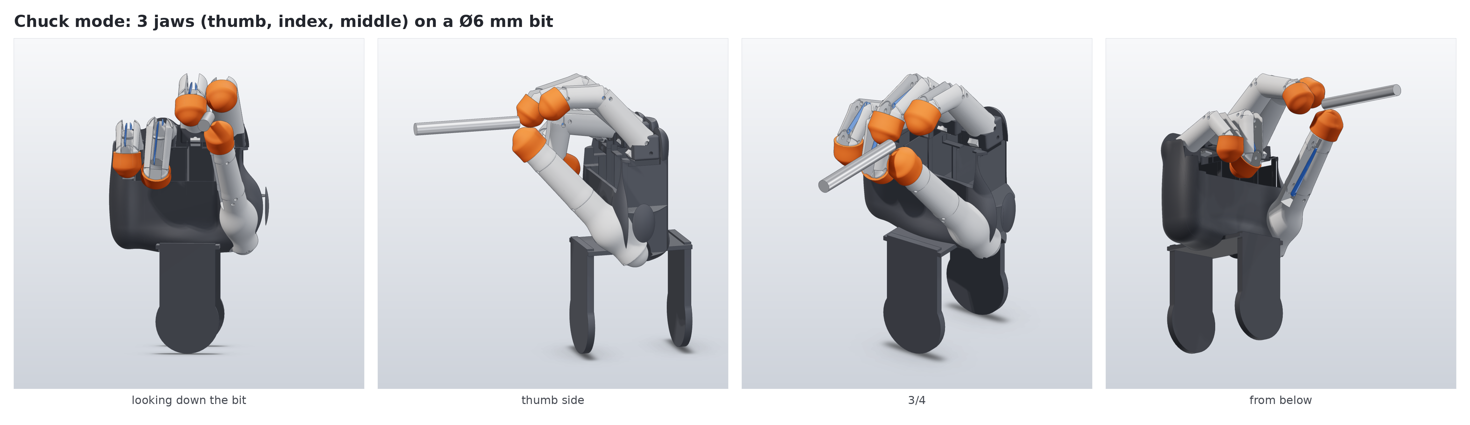
hand_chuck3_d6_sheet.png
