Koede/robot-arm/hand_open_sheet.png

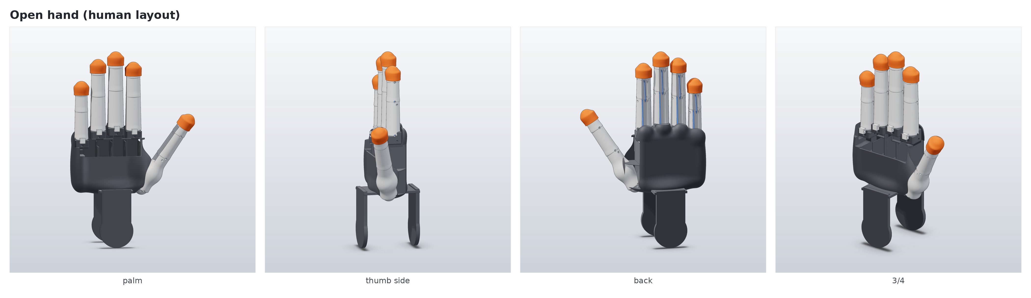
hand_open_sheet.png
