Koede/robot-arm/hand_point_sheet.png

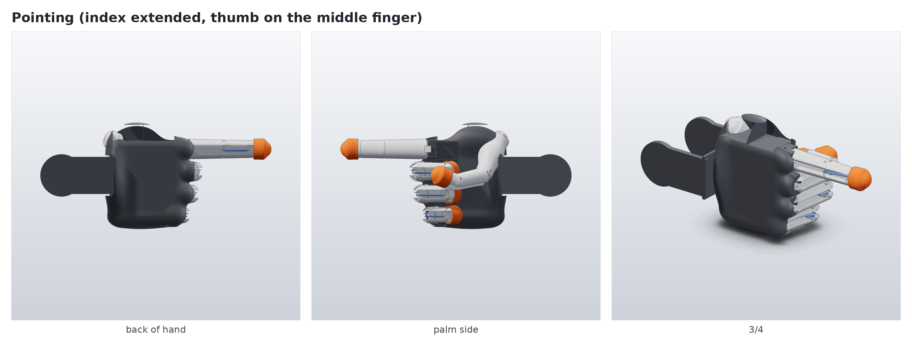
hand_point_sheet.png
