Koede/robot-arm/hand_thumbsup_sheet.png

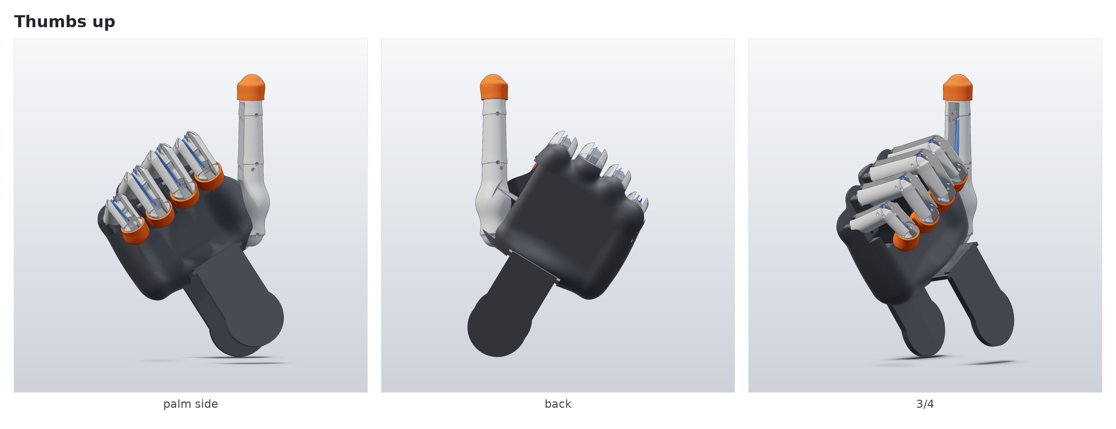
hand_thumbsup_sheet.png
