Koede/robot-arm/hand_victory_sheet.png

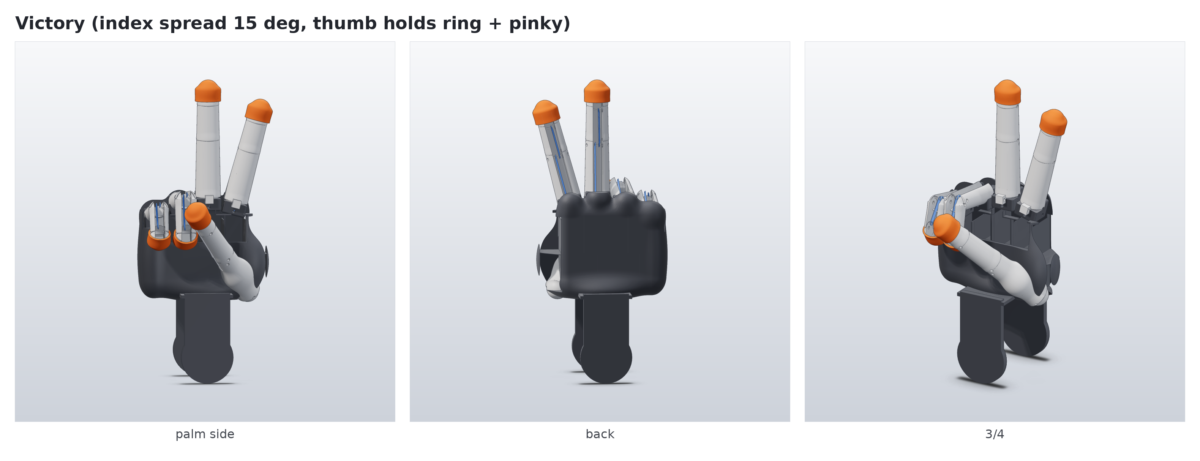
hand_victory_sheet.png
