Koede/robot-arm/renders_j1r2/j1r2_sweep_map.png

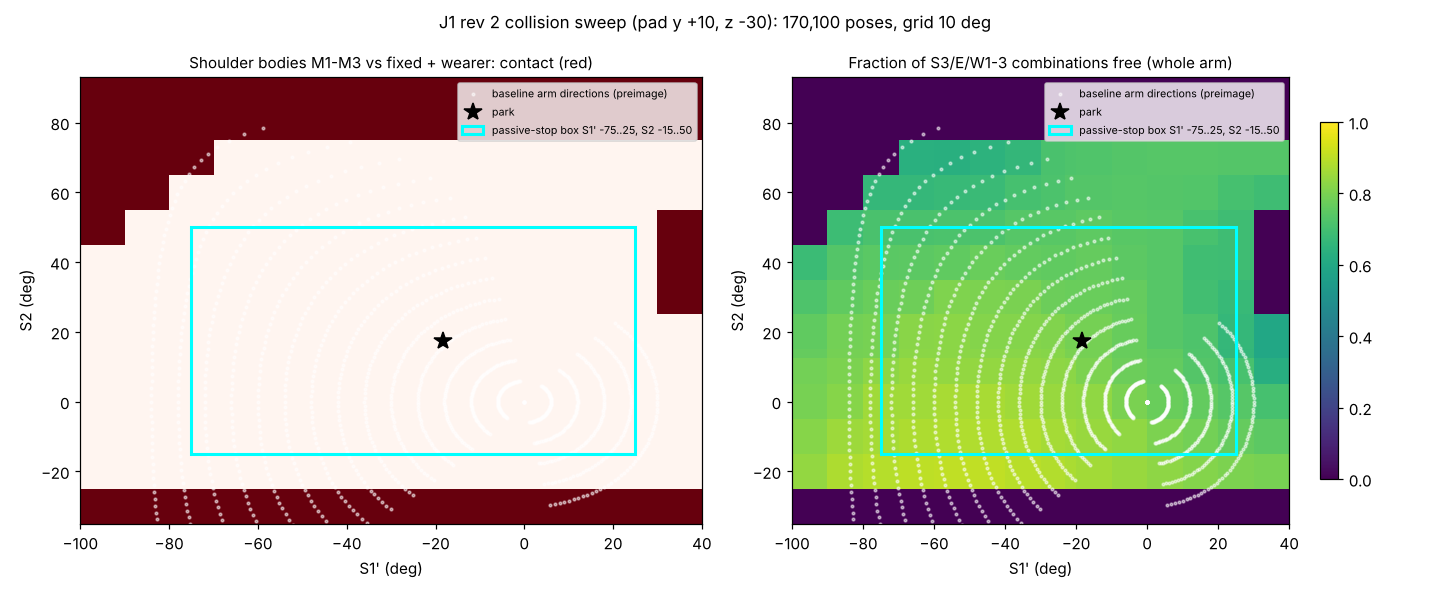
renders_j1r2/j1r2_sweep_map.png
