Koede/robot-arm/renders_j1r2/mj11_balancer_a_rear34.png

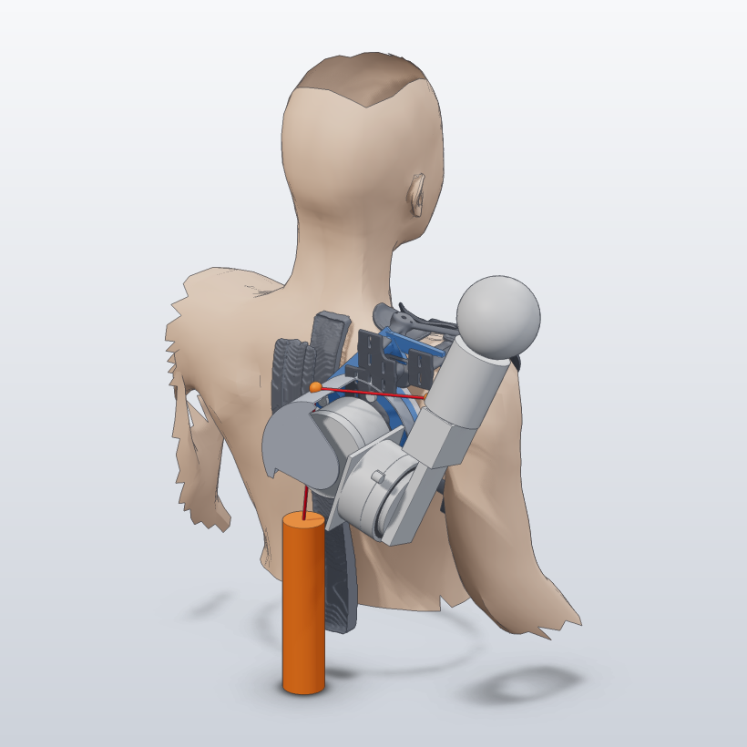
renders_j1r2/mj11_balancer_a_rear34.png
