Koede/robot-arm/renders_j1r2/mj11_balancer_a_rear.png

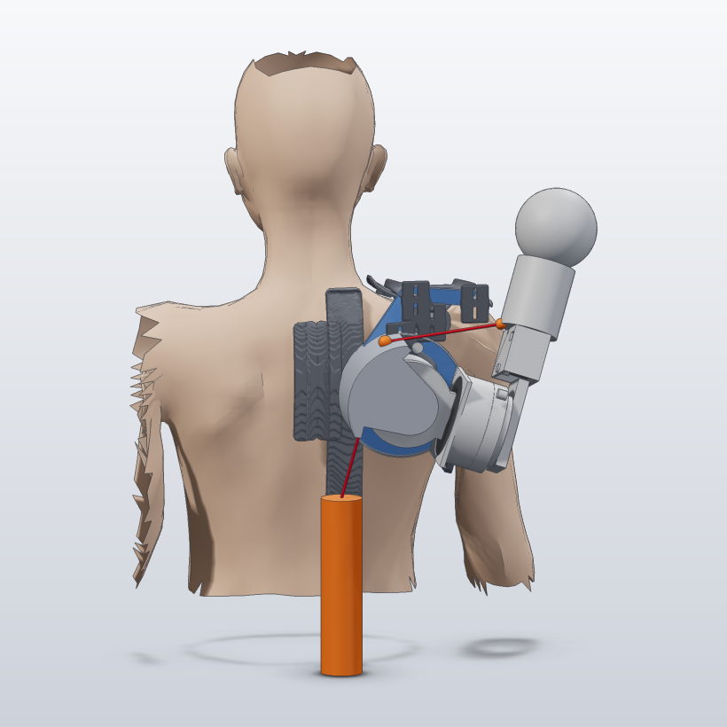
renders_j1r2/mj11_balancer_a_rear.png
