Koede/robot-arm/renders_j1r2/mj11_balancer_a_sheet.png

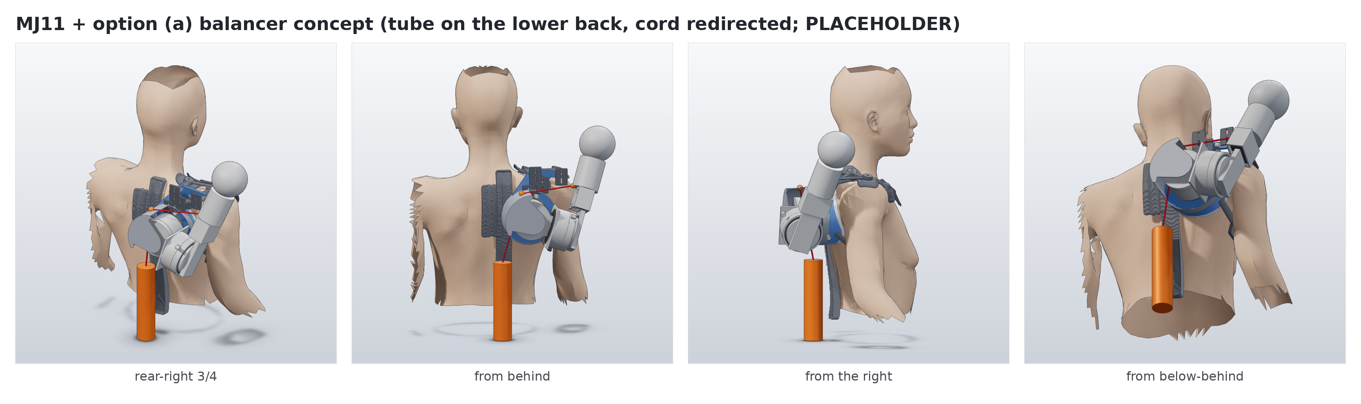
renders_j1r2/mj11_balancer_a_sheet.png
