Koede/robot-arm/renders_j1r2/mj11_leads/B_open_rear34.png

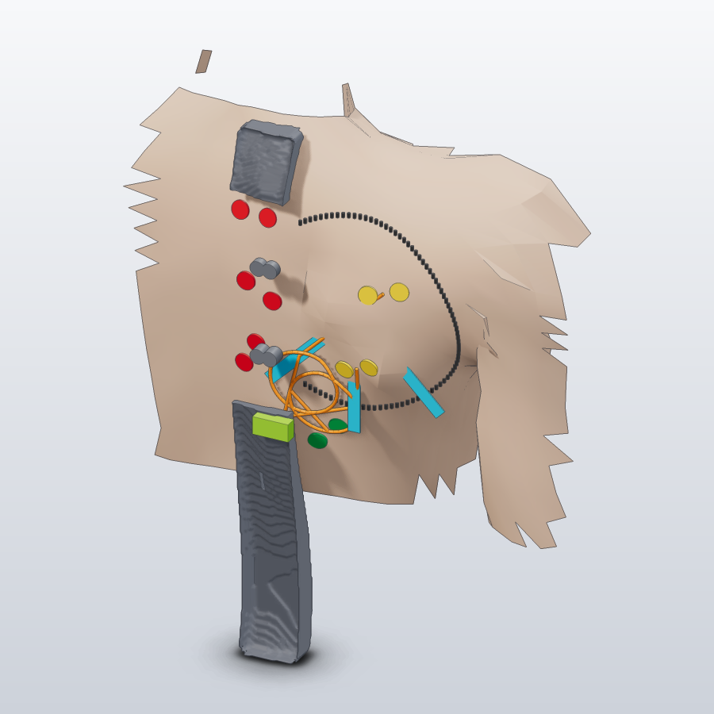
renders_j1r2/mj11_leads/B_open_rear34.png
