Koede/robot-arm/renders_j1r2/mj11_loads_balancer.png

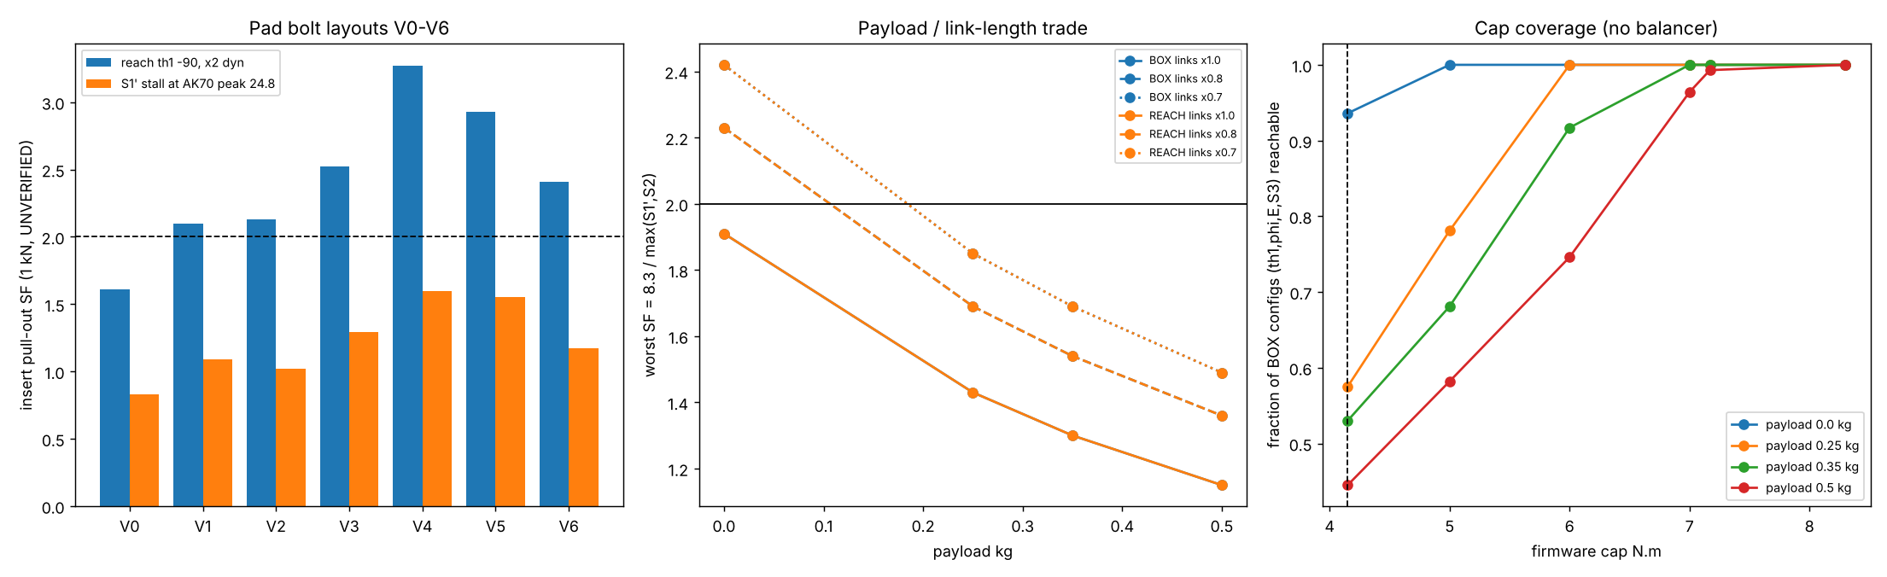
renders_j1r2/mj11_loads_balancer.png
