Koede/robot-arm/renders_j1r2/mounts/MJ1_rear34.png

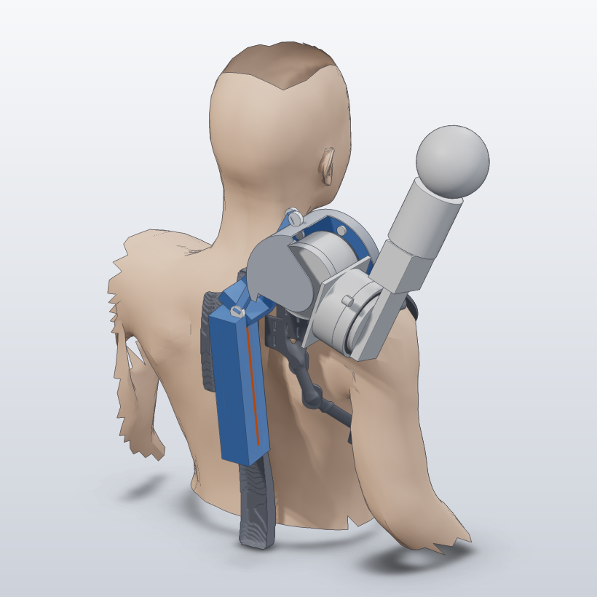
renders_j1r2/mounts/MJ1_rear34.png
