Koede/robot-arm/renders_j1r2/mounts/MJ1_side.png

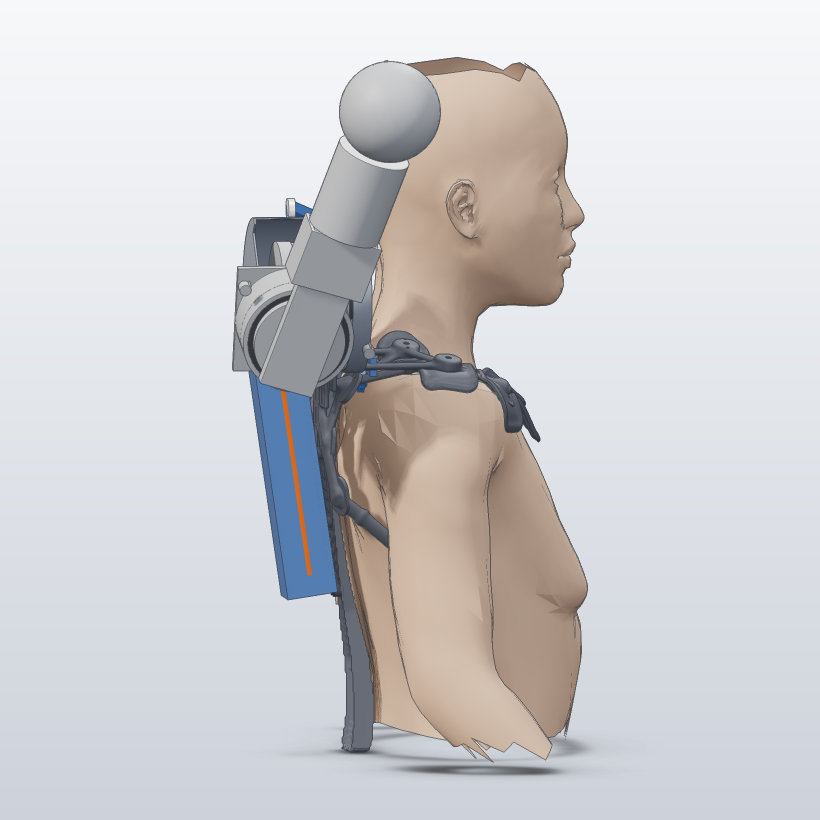
renders_j1r2/mounts/MJ1_side.png
