Koede/robot-arm/renders_j1r2/mounts/MJ1_top.png

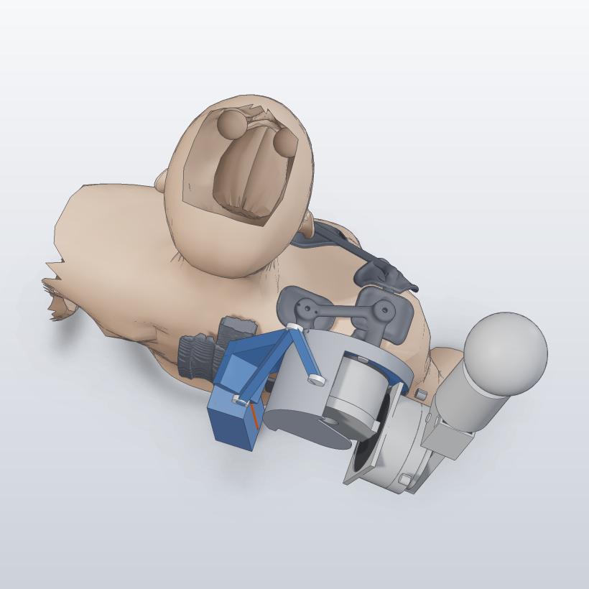
renders_j1r2/mounts/MJ1_top.png
