Koede/robot-arm/renders_j1r2/mounts/MJ2_rear.png

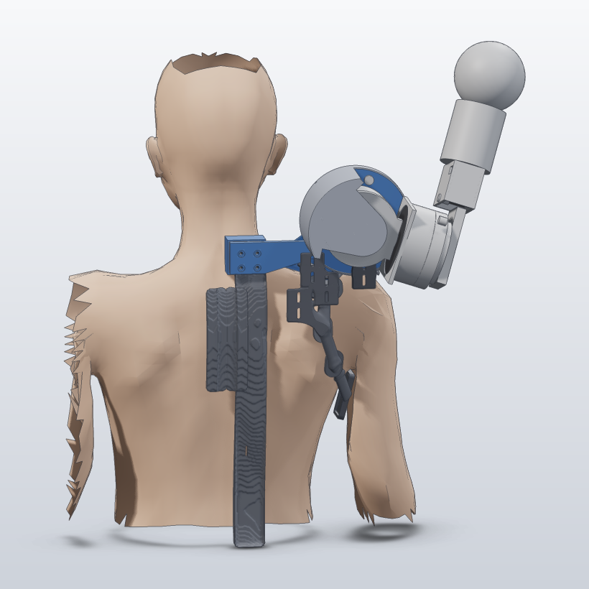
renders_j1r2/mounts/MJ2_rear.png
