Koede/robot-arm/renders_j1r2/mounts/MJ2_sheet.png

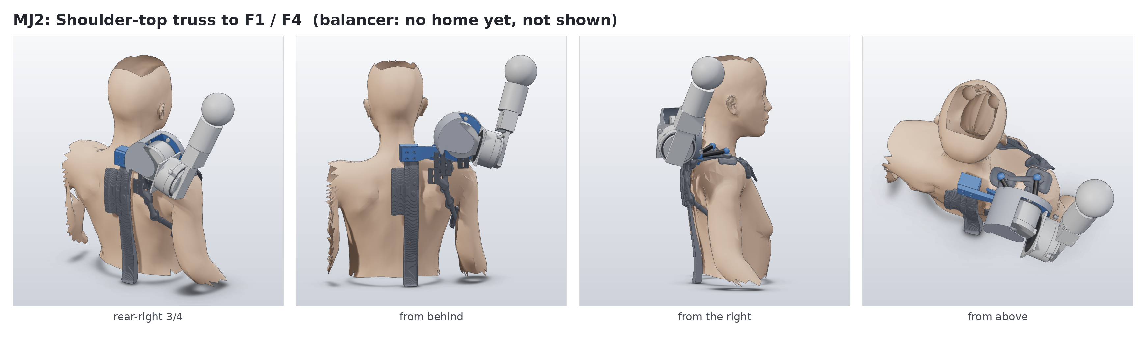
renders_j1r2/mounts/MJ2_sheet.png
