Koede/robot-arm/renders_j1r2/mounts/MJ6_side.png

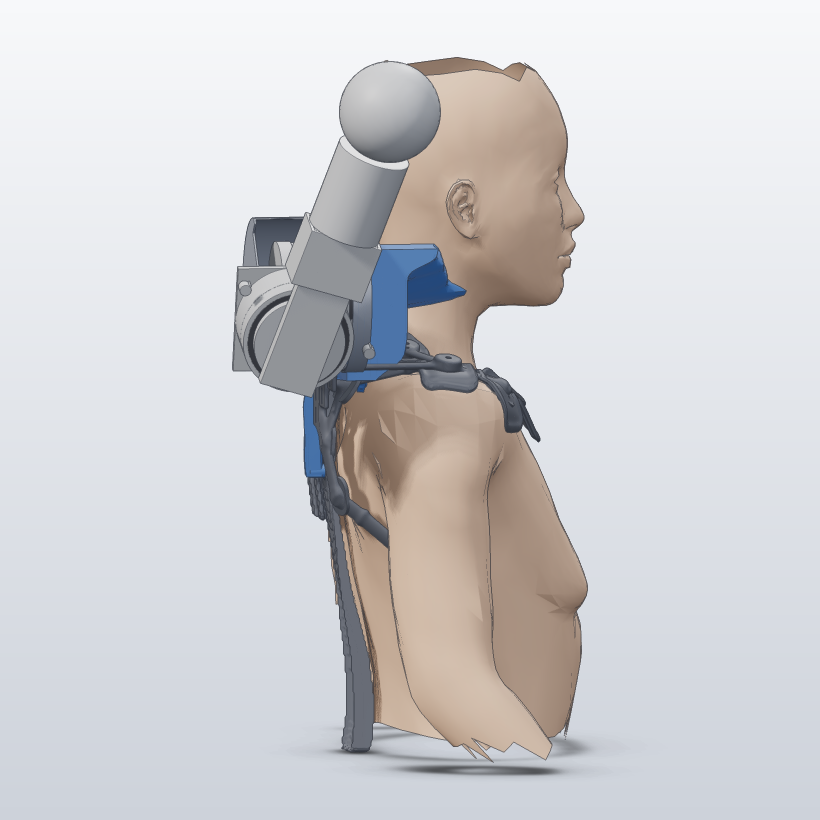
renders_j1r2/mounts/MJ6_side.png
