Koede/robot-arm/renders_j1r2/mounts/MJ11_rear.png

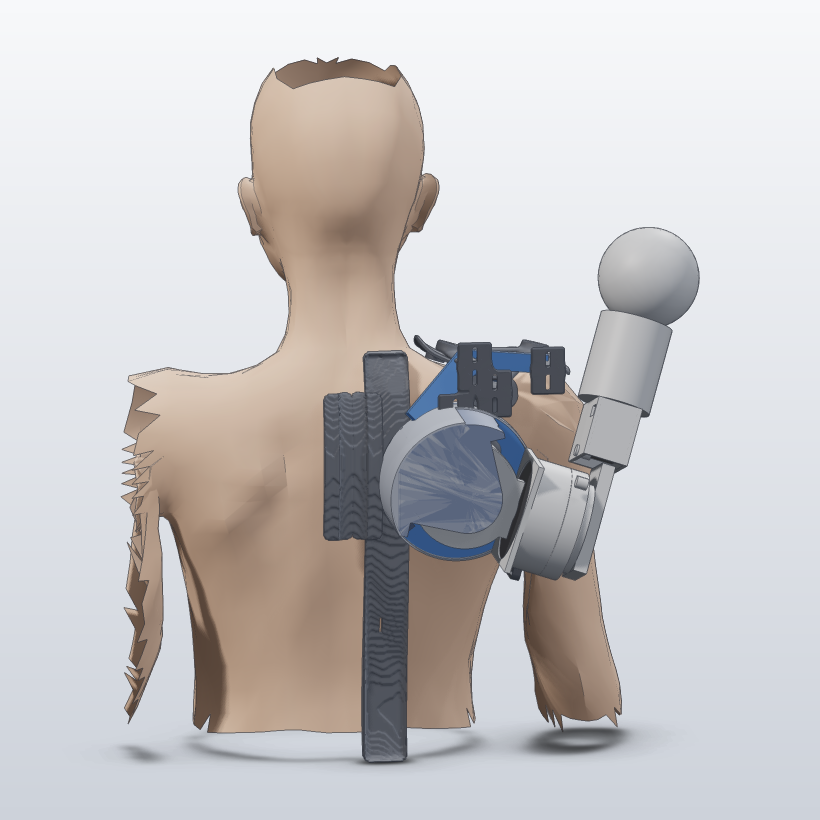
renders_j1r2/mounts/MJ11_rear.png
