Koede/robot-arm/renders_j1r2/mounts/MJ11_top.png

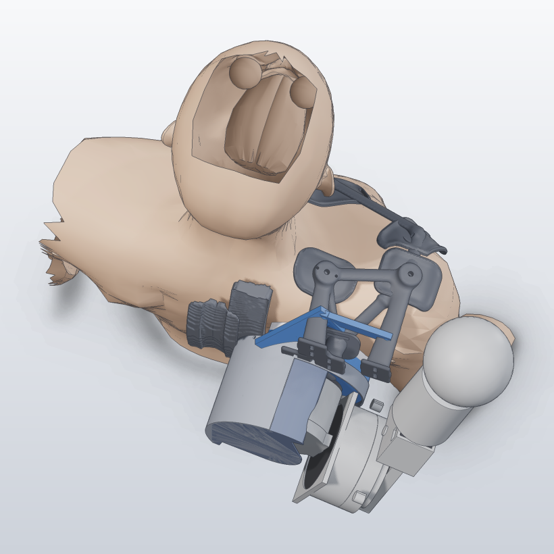
renders_j1r2/mounts/MJ11_top.png
