Koede/robot-arm/renders_j1r2/mounts/overview_mounts.png

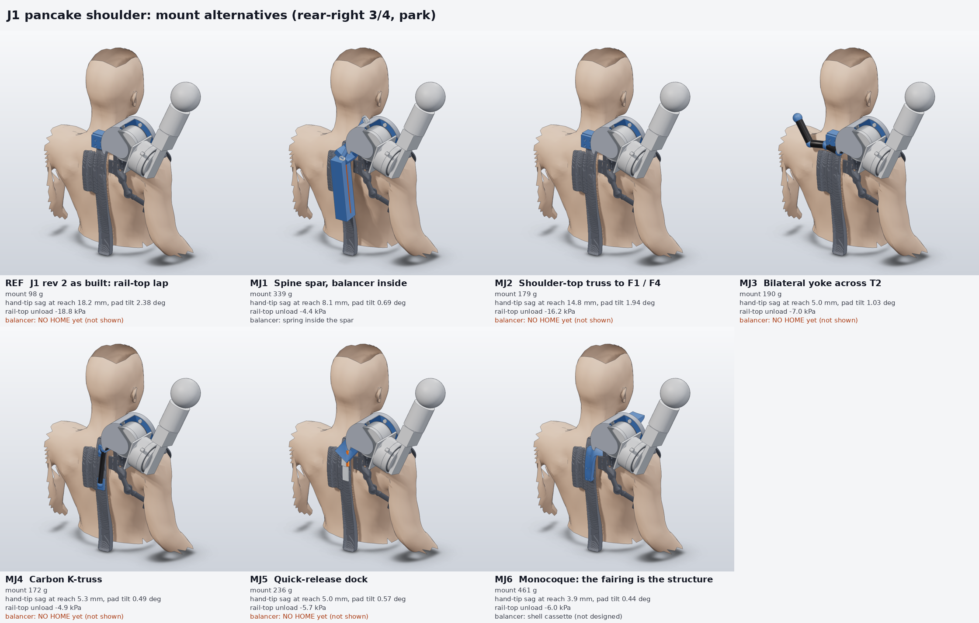
renders_j1r2/mounts/overview_mounts.png
