Koede/robot-arm/renders_j1r2/mounts/overview_spine_mounts.png

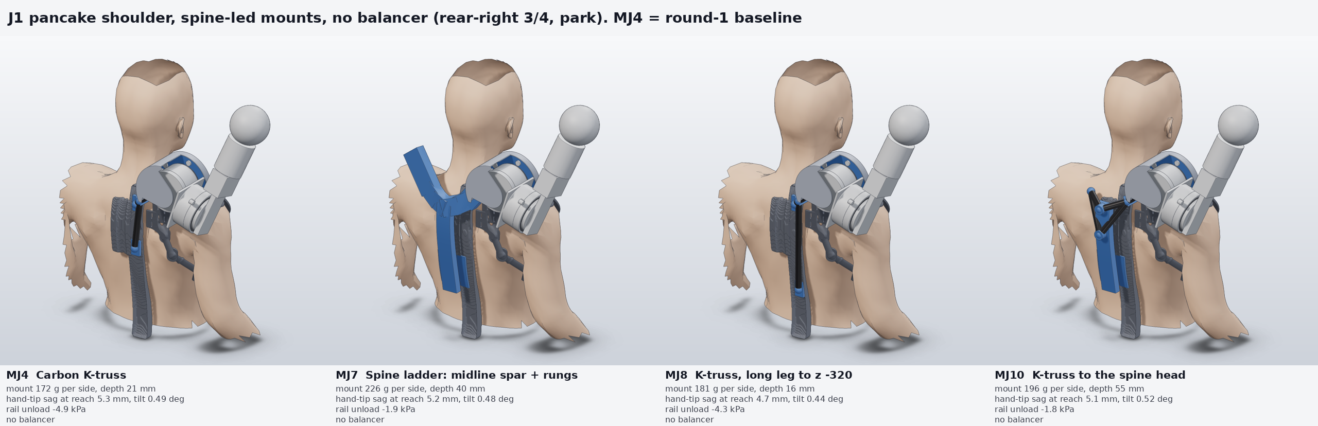
renders_j1r2/mounts/overview_spine_mounts.png
