Koede/robot-arm/renders_j1r2/overview_joints.png

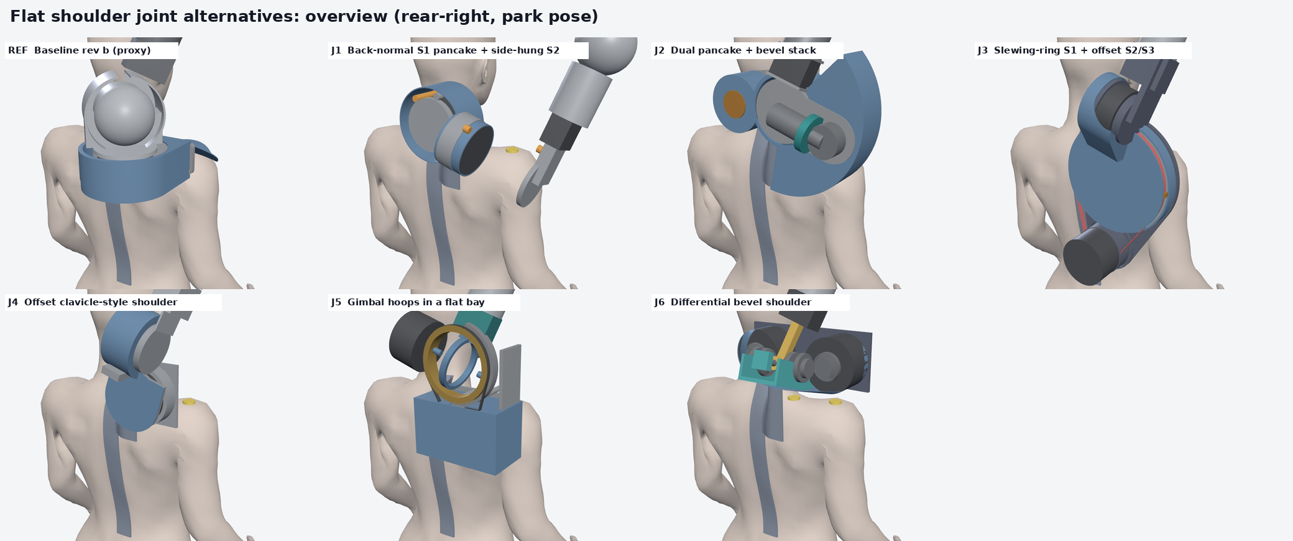
renders_j1r2/overview_joints.png
