Koede/robot-arm/renders_j1r2/overview_mount_study.png

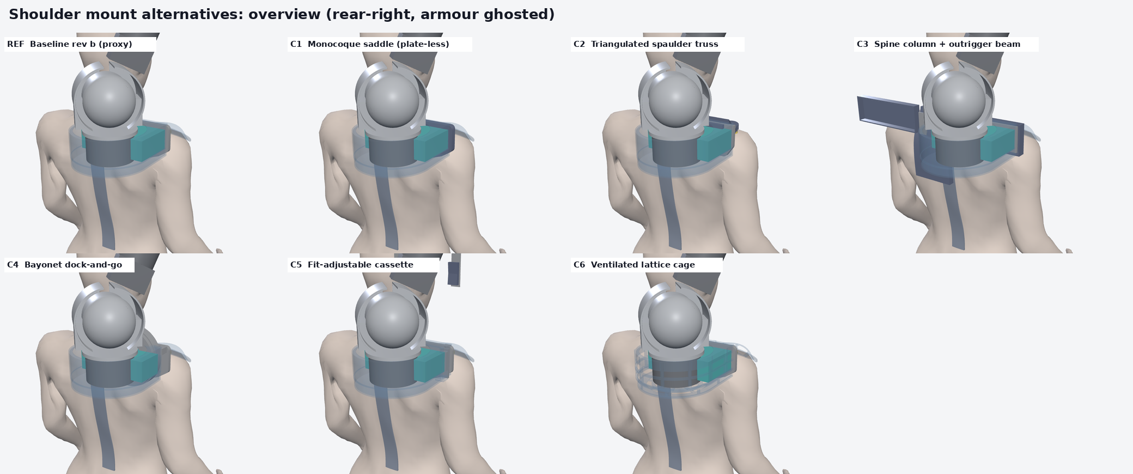
renders_j1r2/overview_mount_study.png
