Koede/robot-arm/renders_j1r2/sheet_C2.png

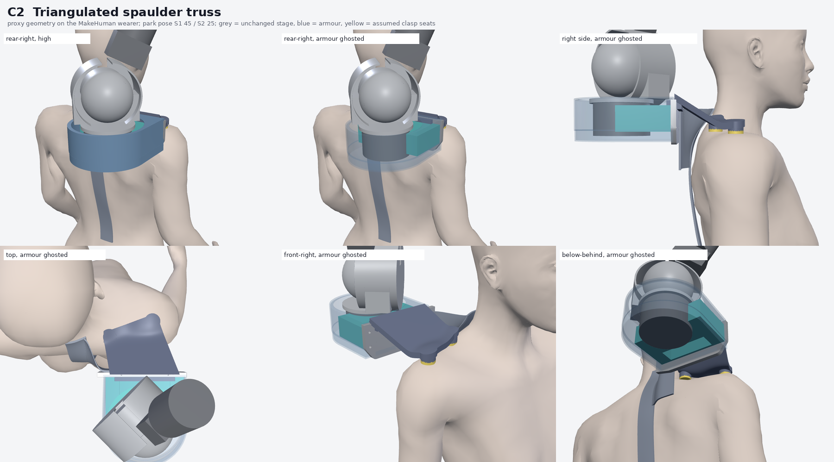
renders_j1r2/sheet_C2.png
