Koede/robot-arm/renders_j1r2/sheet_J1R2.png

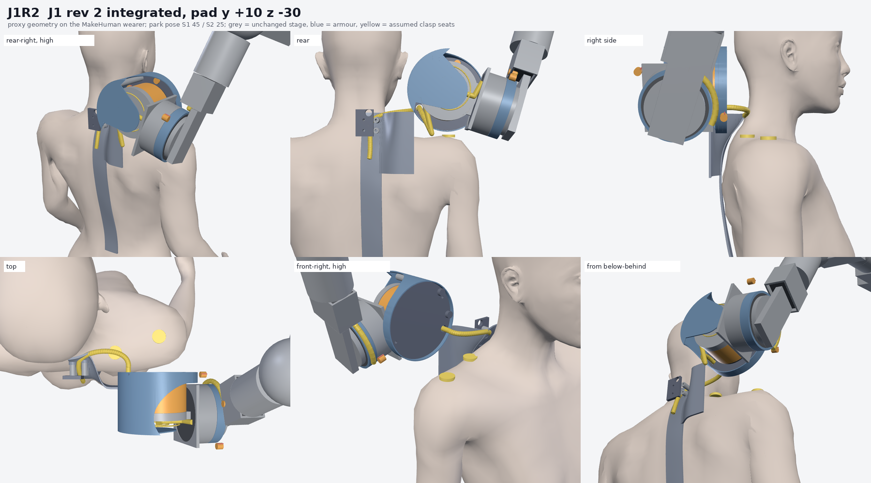
renders_j1r2/sheet_J1R2.png
