Koede/robot-arm/renders_j1r2/sheet_J4.png

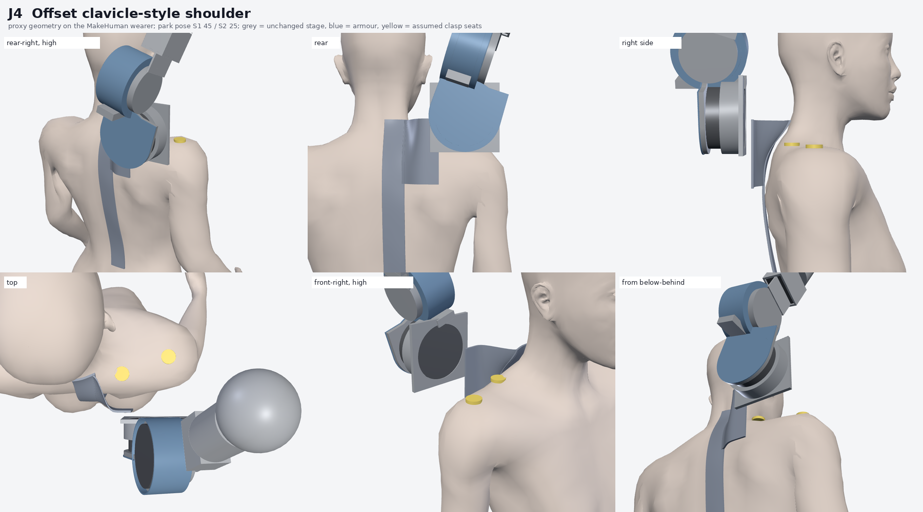
renders_j1r2/sheet_J4.png
