Koede/robot-arm/renders_j1r2/sheet_J5.png

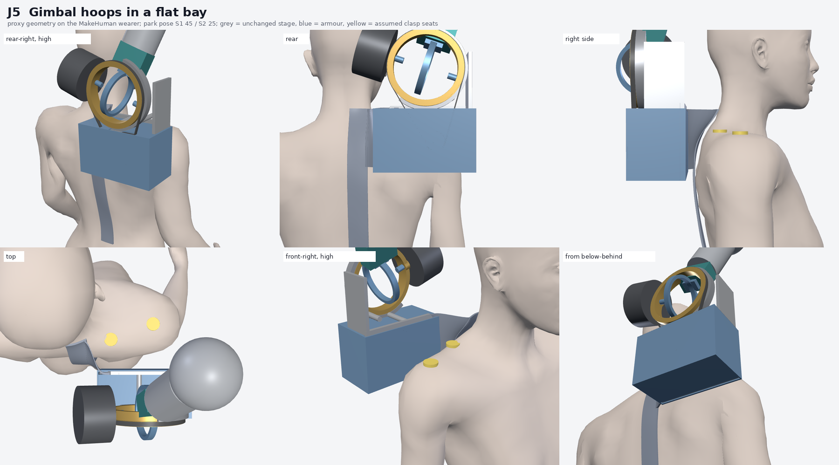
renders_j1r2/sheet_J5.png
