Koede/robot-arm/stl/j1r2_sweep/mj11_tiers.png

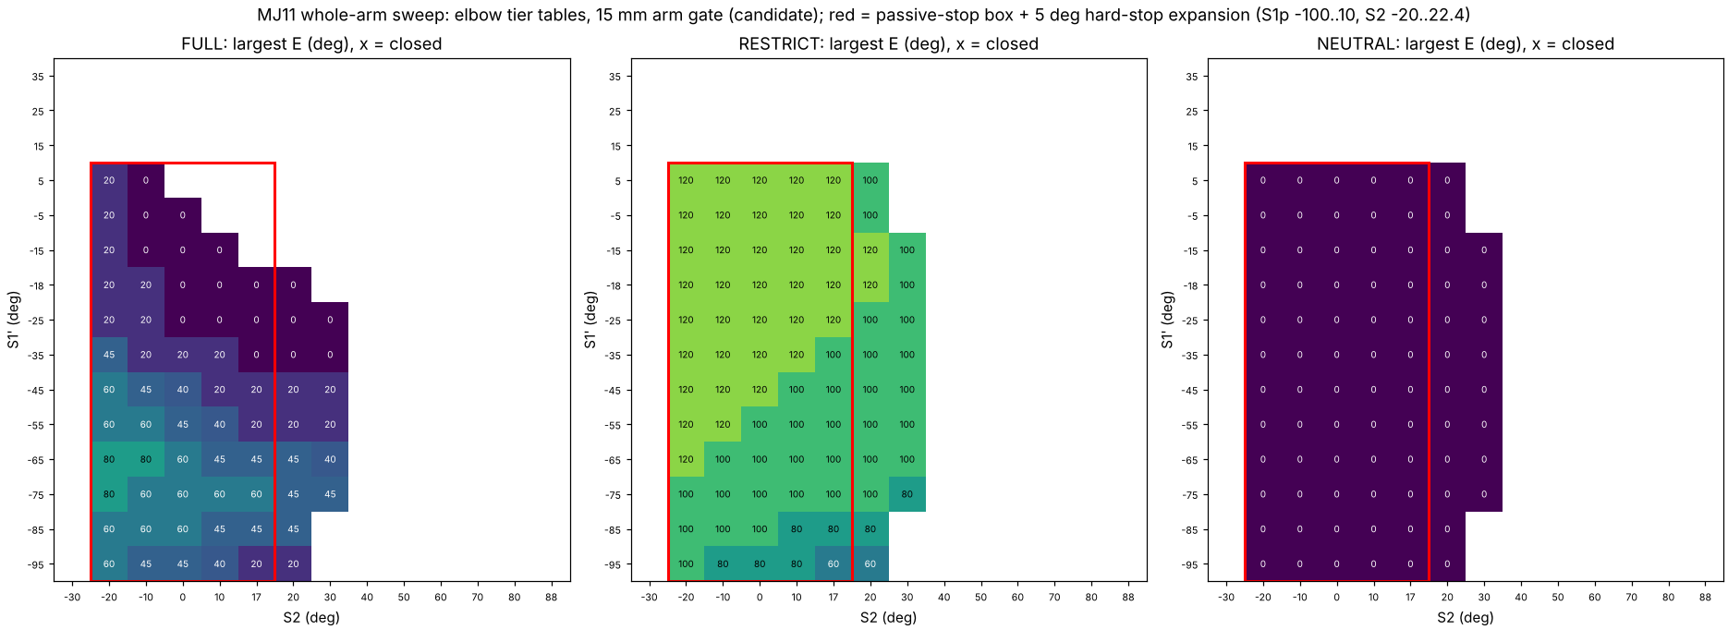
stl/j1r2_sweep/mj11_tiers.png
