Koede/robot-arm/stl/balancer/bal_tubecap_R.stl

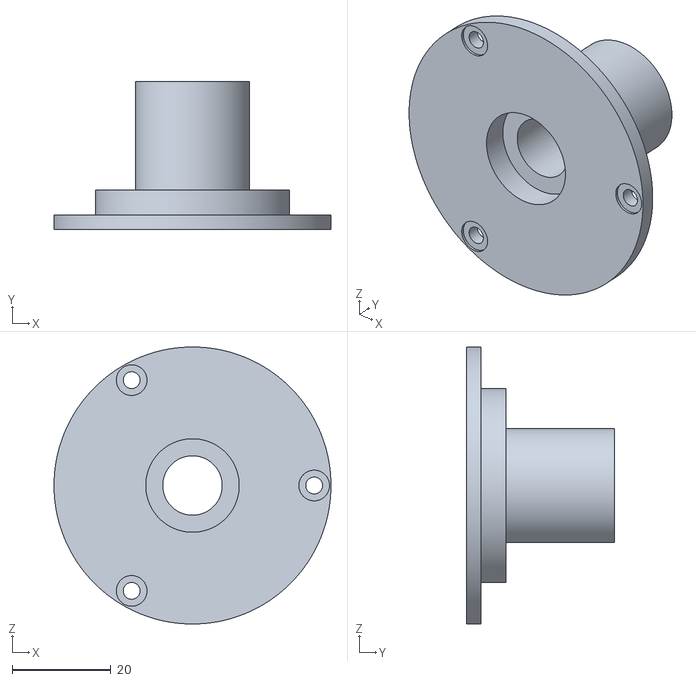
[picture p44: CAD file, 2026-10-23]
stl/balancer/bal_tubecap_R.stl
56.0 x 30.0 x 56.0
