Koede/robot-arm/stl/concepts_study/C1/C1_saddle_PACF_R.stl

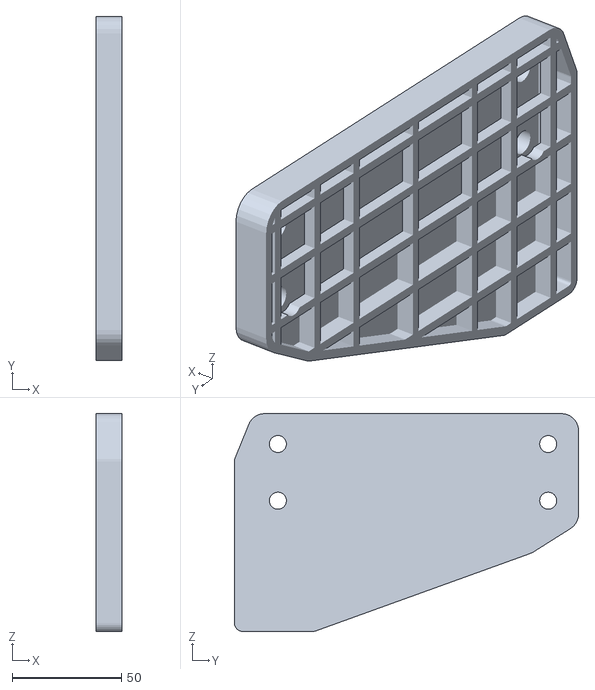
[picture p45: CAD file, 2026-11-02]
stl/concepts_study/C1/C1_saddle_PACF_R.stl
12.0 x 158.0 x 100.0
