Koede/robot-arm/stl/concepts_study/C2/C2_hoop_truss_R.stl

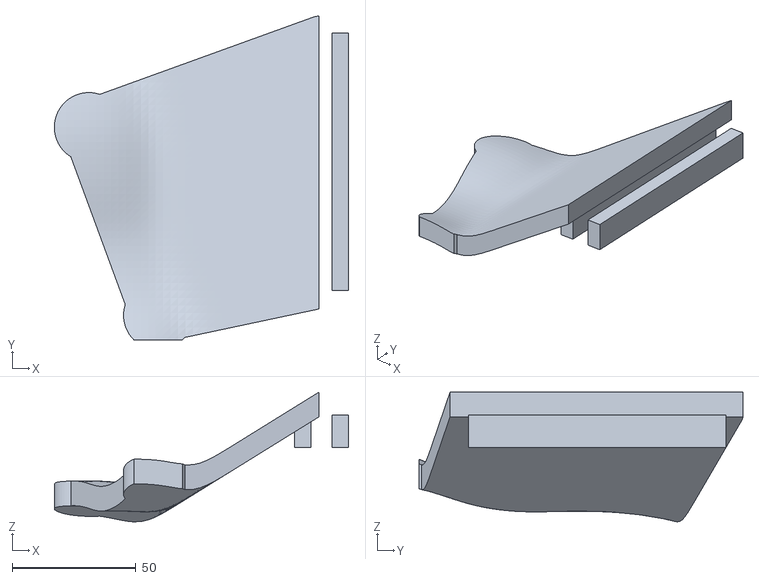
[picture p46: CAD file, 2026-11-02]
stl/concepts_study/C2/C2_hoop_truss_R.stl
119.0 x 131.0 x 52.5
