Koede/robot-arm/stl/concepts_study/C3/C3_ghost_left_beam_R.stl

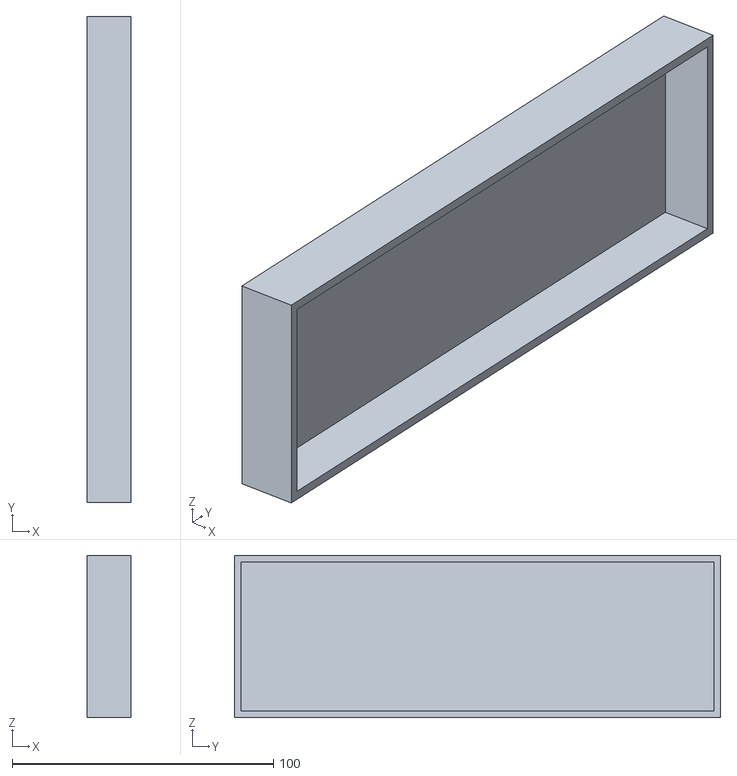
[picture p47: CAD file, 2026-11-02]
stl/concepts_study/C3/C3_ghost_left_beam_R.stl
17.0 x 186.0 x 62.0
