Koede/robot-arm/stl/concepts_study/C4/C4_armour_crown_module_R.stl

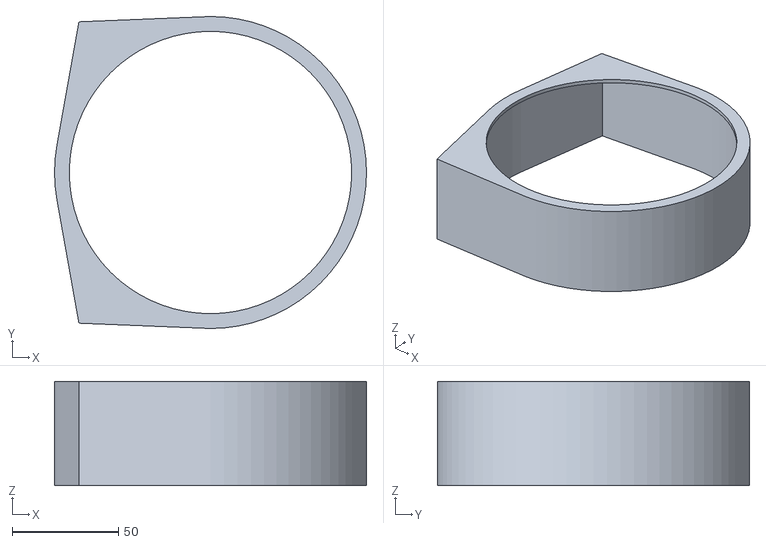
[picture p48: CAD file, 2026-11-02]
stl/concepts_study/C4/C4_armour_crown_module_R.stl
147.0 x 147.0 x 49.0
