Koede/robot-arm/stl/concepts_study/C5/C5_backing_bars_x2_R.stl

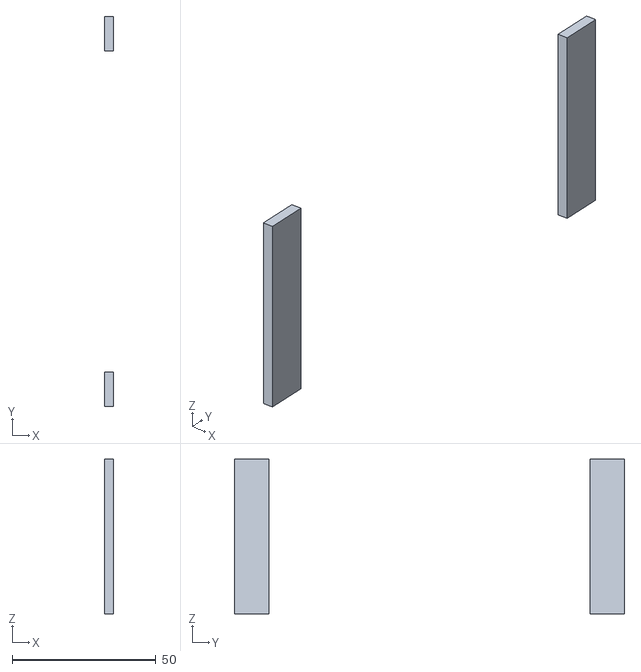
[picture p49: CAD file, 2026-11-02]
stl/concepts_study/C5/C5_backing_bars_x2_R.stl
3.00 x 136.0 x 54.0
