Koede/robot-arm/stl/concepts_study/C6/C6_cage_spaulder_R.stl

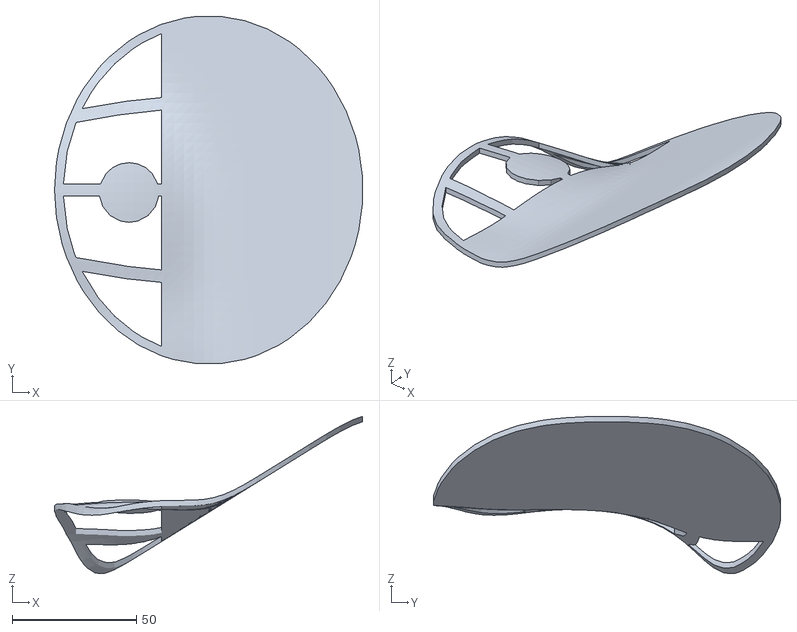
[picture p50: CAD file, 2026-11-02]
stl/concepts_study/C6/C6_cage_spaulder_R.stl
123.8 x 139.6 x 63.3
