Koede/robot-arm/stl/concepts_study/J1/J1_S3_bracket_R.stl

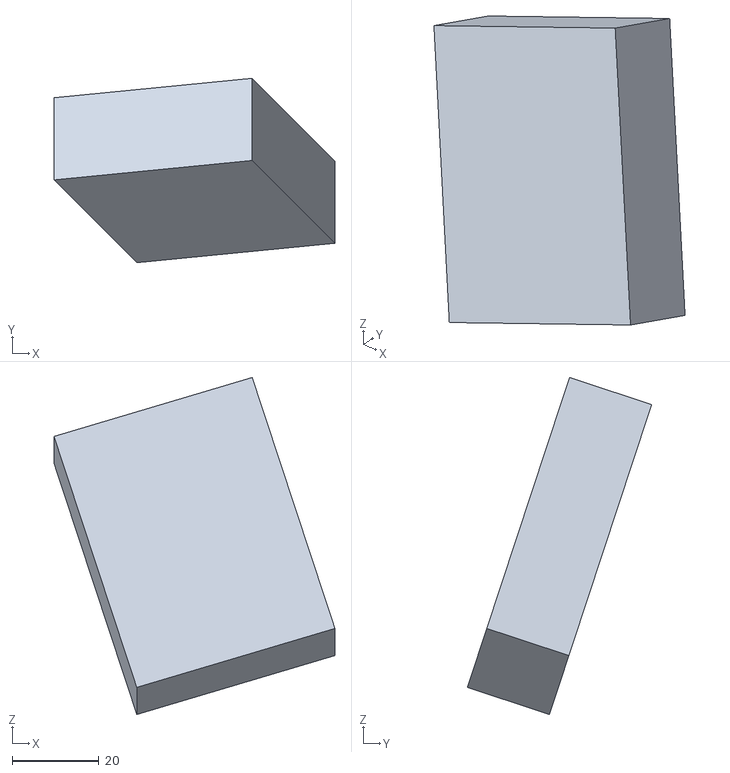
[picture p51: CAD file, 2026-11-02]
stl/concepts_study/J1/J1_S3_bracket_R.stl
64.9 x 42.6 x 77.9
