Koede/robot-arm/stl/concepts_study/J1R2/J1R2_dist_wrist_ball_R.stl

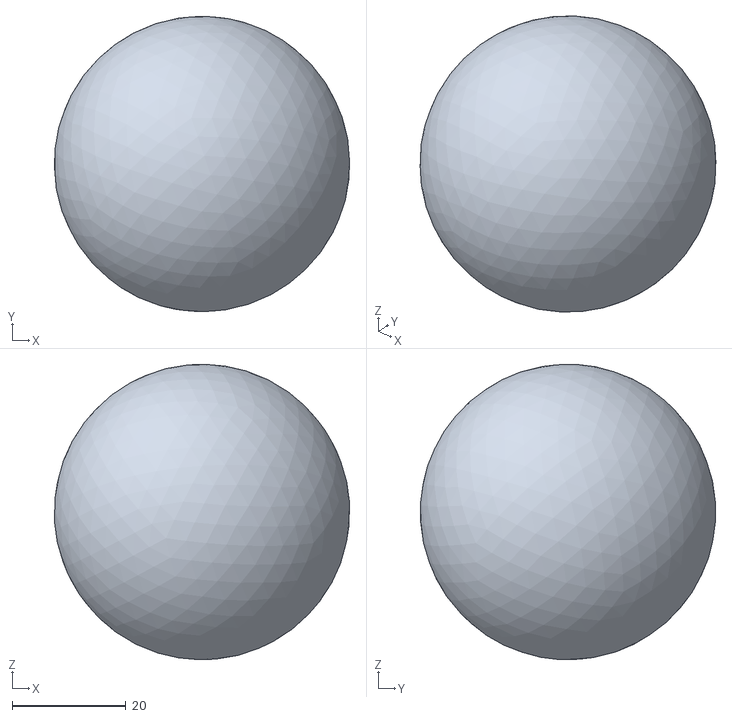
[picture p52: CAD file, 2026-11-02]
stl/concepts_study/J1R2/J1R2_dist_wrist_ball_R.stl
51.9 x 51.9 x 51.9
