Koede/robot-arm/stl/concepts_study/J2/J2_hub_fixed_R.stl

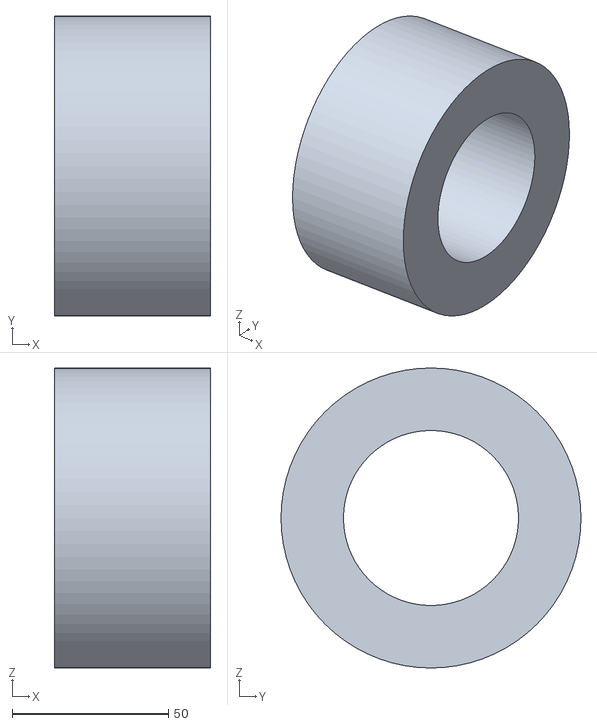
[picture p53: CAD file, 2026-11-02]
stl/concepts_study/J2/J2_hub_fixed_R.stl
50.0 x 96.0 x 96.0
