Koede/robot-arm/stl/concepts_study/J3/J3_xm540_S3_R.stl

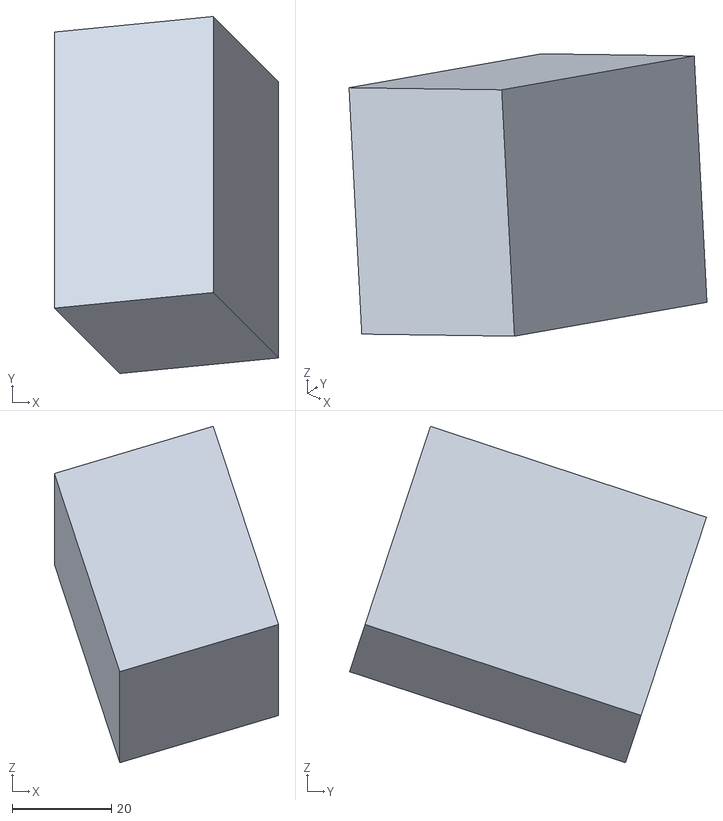
[picture p54: CAD file, 2026-11-02]
stl/concepts_study/J3/J3_xm540_S3_R.stl
45.1 x 71.8 x 67.7
