Koede/robot-arm/stl/concepts_study/J4/J4_s3_bracket_R.stl

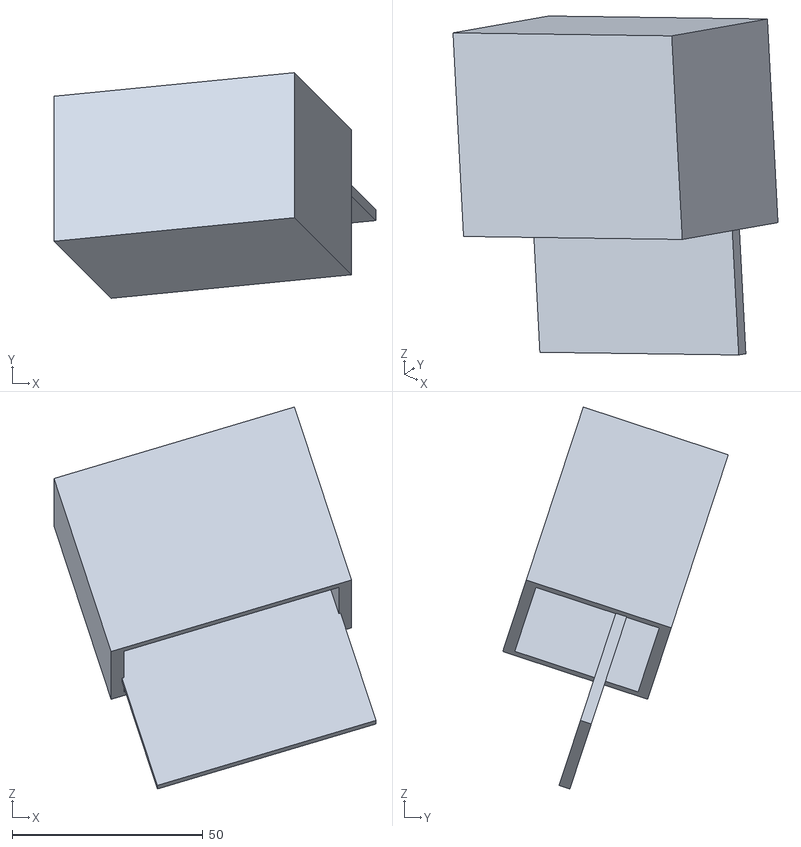
[picture p55: CAD file, 2026-11-02]
stl/concepts_study/J4/J4_s3_bracket_R.stl
84.3 x 59.1 x 100.1
