Koede/robot-arm/stl/concepts_study/J5/J5_standoff0_R.stl

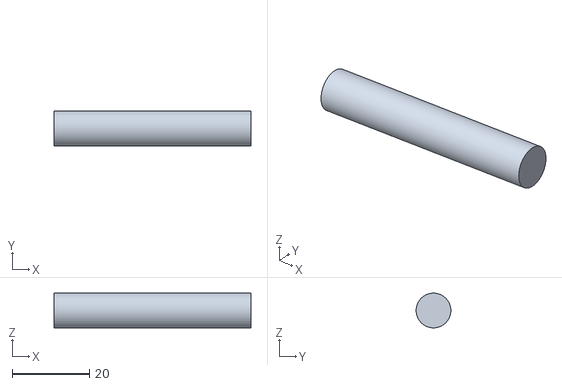
[picture p56: CAD file, 2026-11-02]
stl/concepts_study/J5/J5_standoff0_R.stl
51.0 x 9.00 x 9.00
