Koede/robot-arm/stl/concepts_study/J6/J6_cross_shaft_pinions_R.stl

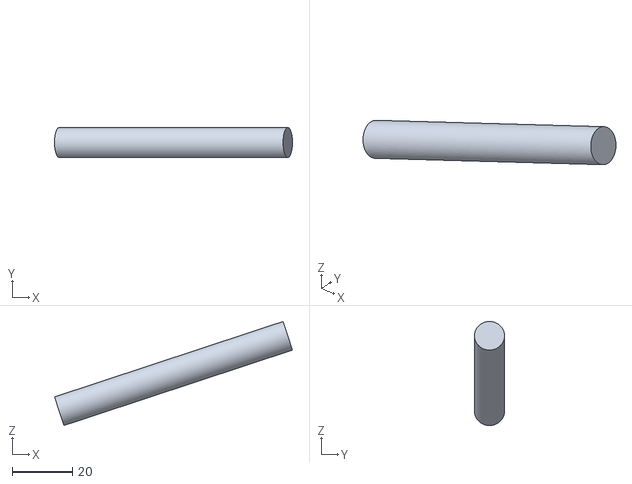
[picture p57: CAD file, 2026-11-02]
stl/concepts_study/J6/J6_cross_shaft_pinions_R.stl
79.1 x 10.0 x 34.6
