Koede/robot-arm/stl/concepts_study/REF/REF_armour_keel_R.stl

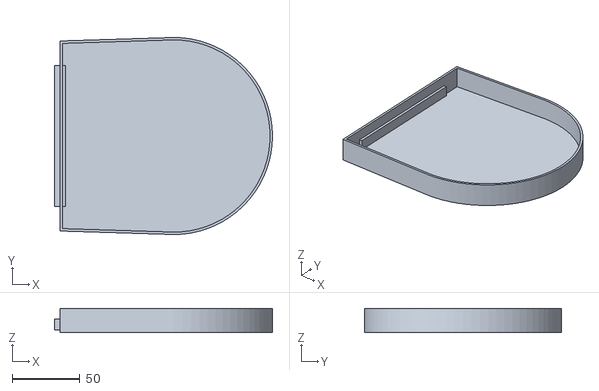
[picture p58: CAD file, 2026-11-02]
stl/concepts_study/REF/REF_armour_keel_R.stl
160.6 x 145.2 x 18.0
