Koede/robot-arm/stl/distal/claw/prox_F.stl

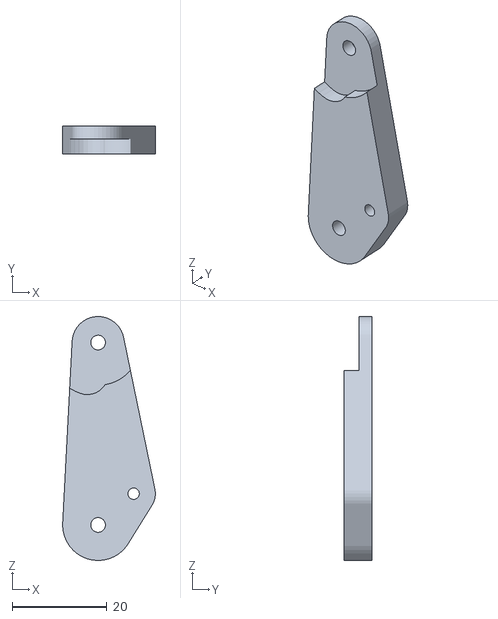
[picture p59: CAD file, 2026-10-23]
stl/distal/claw/prox_F.stl
19.6 x 6.00 x 51.5
