Koede/robot-arm/stl/distal/claw/proxies/pin_ring1.stl

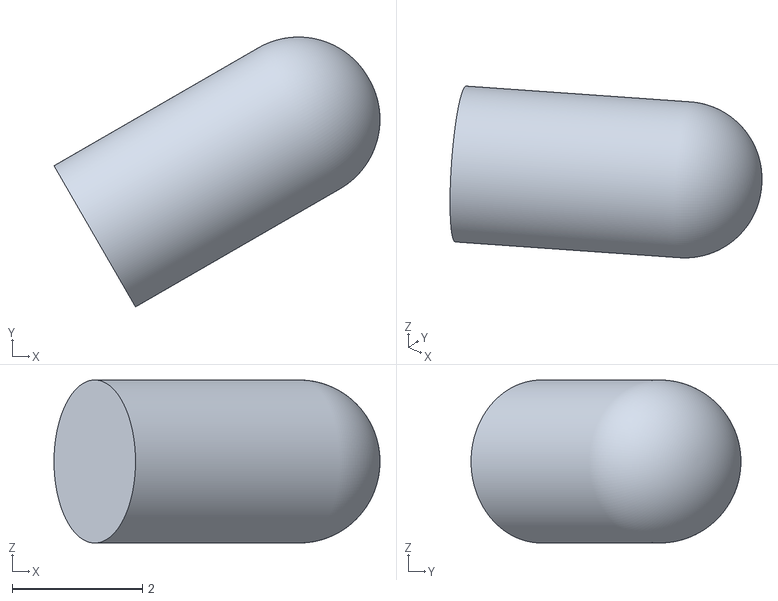
[picture p60: CAD file, 2026-10-23]
stl/distal/claw/proxies/pin_ring1.stl
5.00 x 4.14 x 2.50
