Koede/robot-arm/stl/distal/forearm_root_a_R.stl

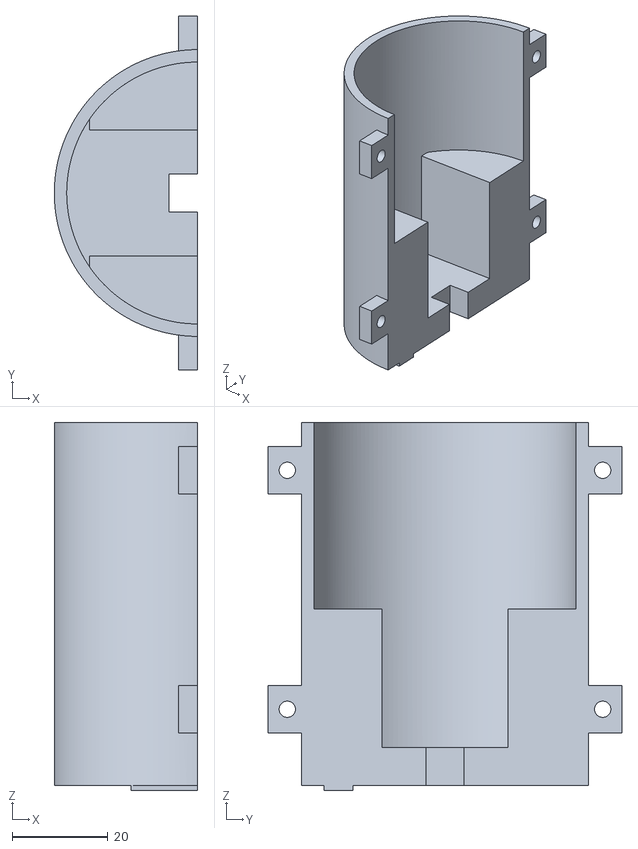
[picture p61: CAD file, 2026-10-23]
stl/distal/forearm_root_a_R.stl
30.0 x 74.0 x 77.0
