Koede/robot-arm/stl/distal/proxies/sts_w1_R.stl

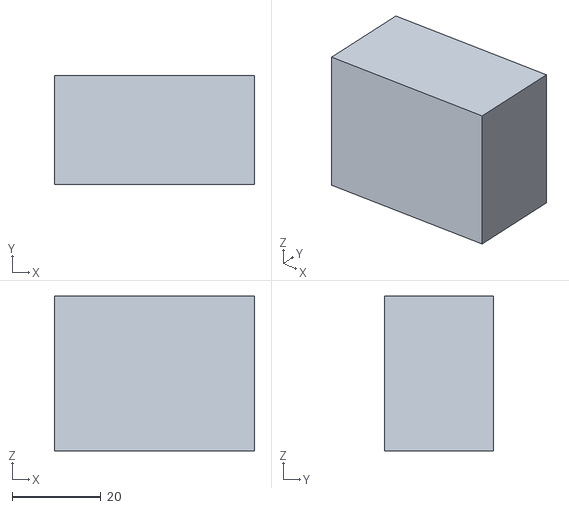
[picture p62: CAD file, 2026-10-23]
stl/distal/proxies/sts_w1_R.stl
45.2 x 24.7 x 35.0
