Koede/robot-arm/stl/distal/stops_M2/s3_post_pos.stl

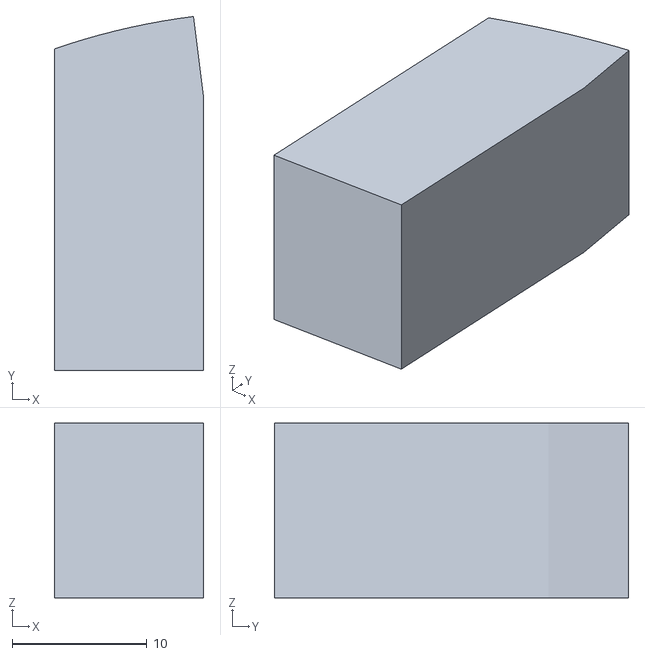
[picture p63: CAD file, 2026-10-23]
stl/distal/stops_M2/s3_post_pos.stl
11.1 x 26.3 x 13.0
