Koede/robot-arm/stl/distal/stops_M3/s3_lug.stl

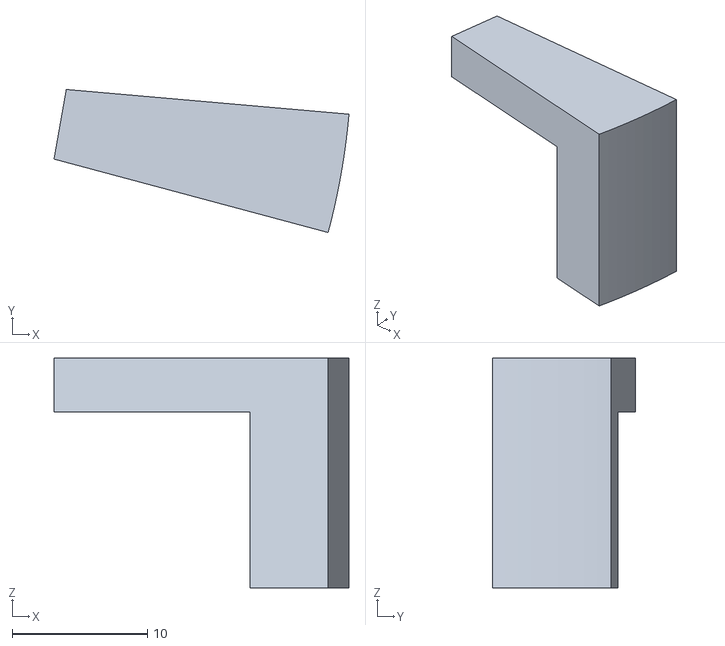
[picture p64: CAD file, 2026-10-23]
stl/distal/stops_M3/s3_lug.stl
21.8 x 10.6 x 17.0
