Koede/robot-arm/stl/distal/stops_ME/w1_post_neg.stl

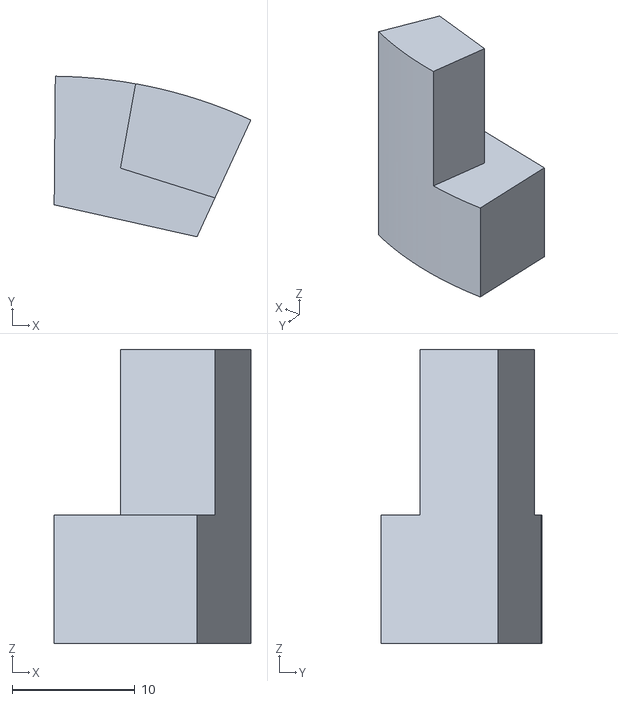
[picture p65: CAD file, 2026-10-23]
stl/distal/stops_ME/w1_post_neg.stl
16.1 x 13.1 x 24.0
