Koede/robot-arm/stl/distal/stops_MW1/tpu_w2_pos.stl

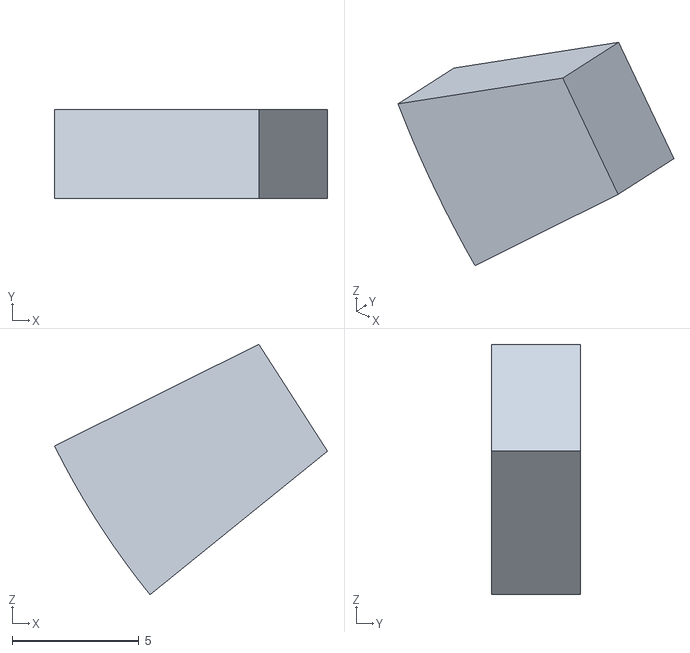
[picture p66: CAD file, 2026-10-23]
stl/distal/stops_MW1/tpu_w2_pos.stl
10.8 x 3.50 x 9.87
