Koede/robot-arm/stl/distal/stops_MW2/w3_post_pos.stl

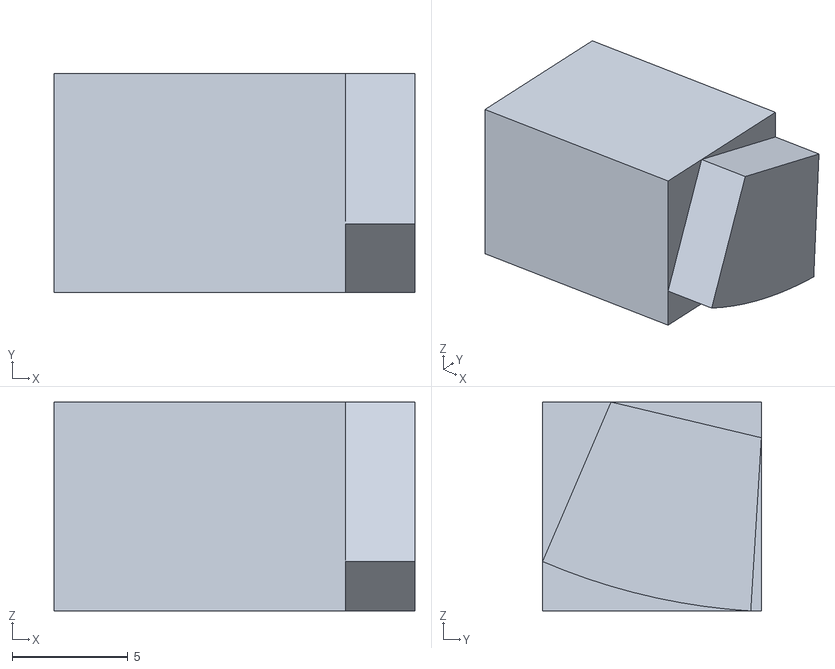
[picture p67: CAD file, 2026-10-23]
stl/distal/stops_MW2/w3_post_pos.stl
15.6 x 9.45 x 9.03
