Koede/robot-arm/stl/distal/stops_MW3/w3_lug_a.stl

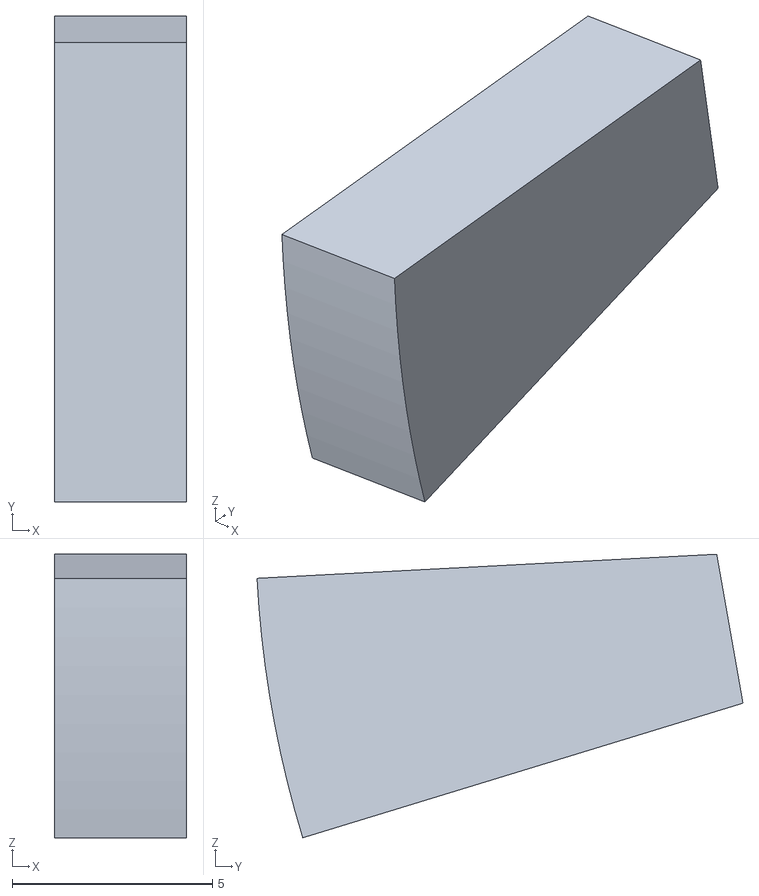
[picture p68: CAD file, 2026-10-23]
stl/distal/stops_MW3/w3_lug_a.stl
3.30 x 12.1 x 7.08
