Koede/robot-arm/stl/hand/index_dist.stl

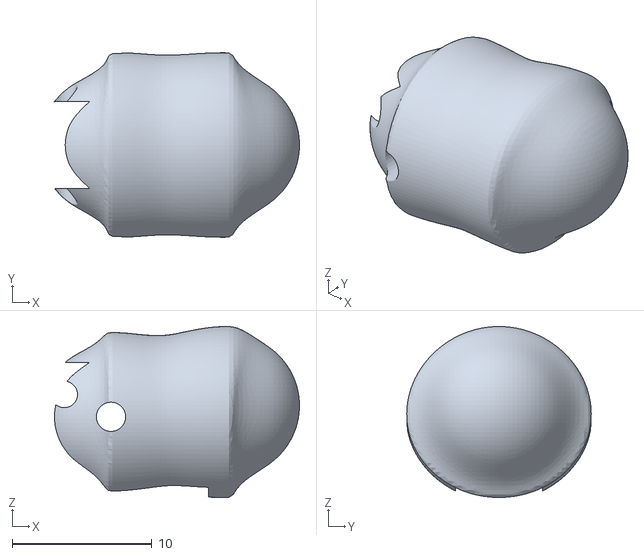
[picture p69: CAD file, 2026-10-31]
stl/hand/index_dist.stl
17.5 x 13.2 x 12.2
