Koede/robot-arm/stl/hand/poses/hand_chuck3_d6_posed.stl

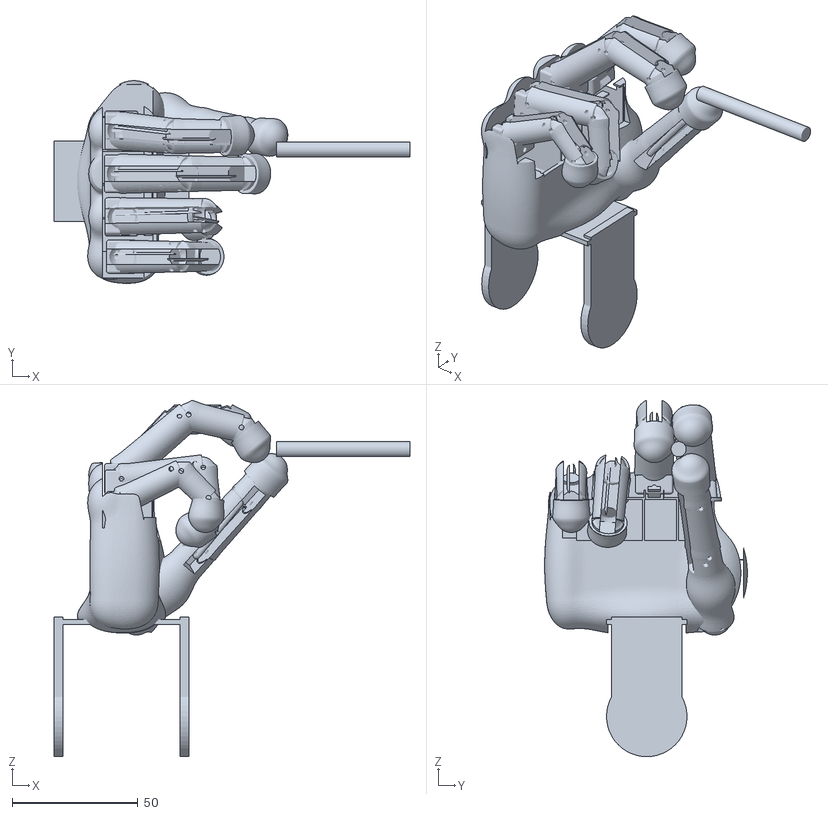
[picture p70: CAD file, 2026-10-31]
stl/hand/poses/hand_chuck3_d6_posed.stl
141.5 x 80.6 x 141.6
