Koede/robot-arm/stl/hand/proxies/servo_middle.stl

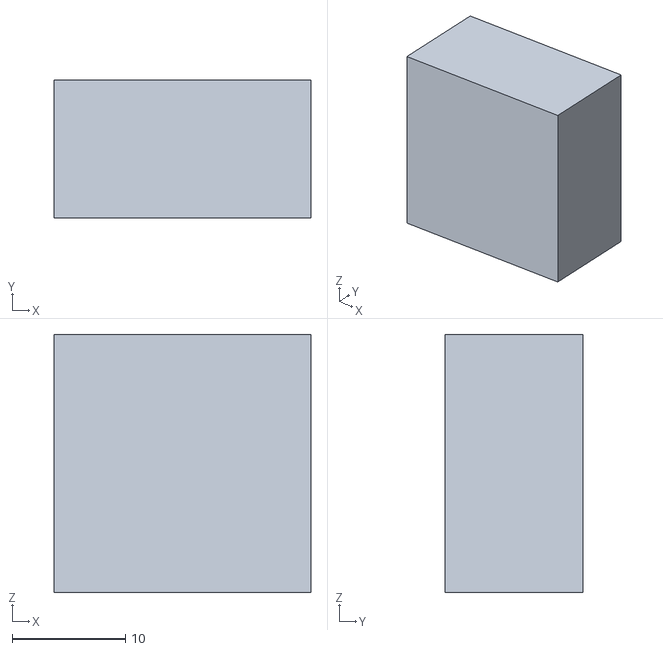
[picture p71: CAD file, 2026-10-31]
stl/hand/proxies/servo_middle.stl
22.7 x 12.2 x 22.8
