Koede/robot-arm/stl/j1r2/S2_clamp_L.stl

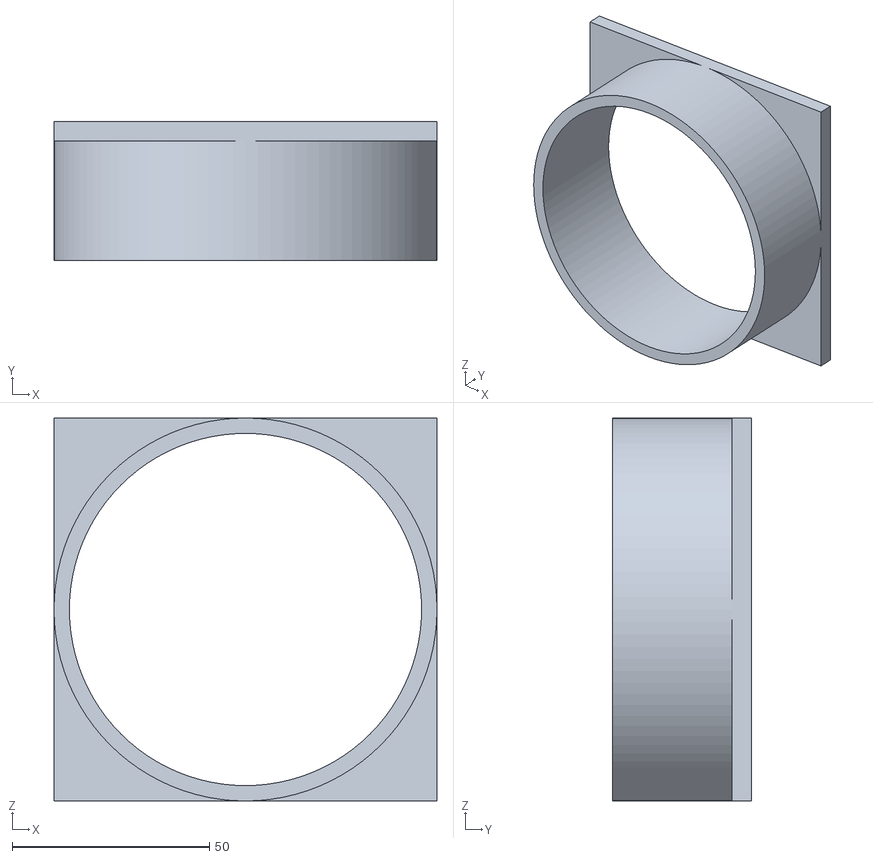
[picture p72: CAD file, 2026-11-02]
stl/j1r2/S2_clamp_L.stl
97.0 x 35.3 x 97.0
