Koede/robot-arm/stl/j1r2_bal/bal_post_R.stl

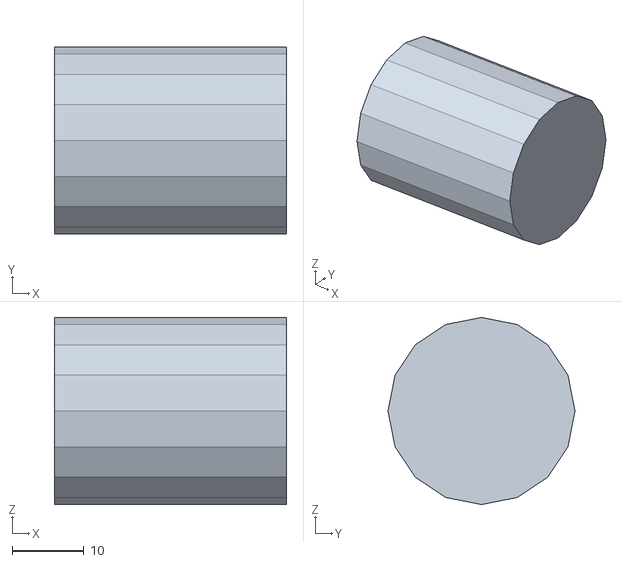
[picture p73: CAD file, 2026-11-02]
stl/j1r2_bal/bal_post_R.stl
32.2 x 26.0 x 26.0
