Koede/robot-arm/stl/j1r2_kin/proxies/M3_upper_arm.stl

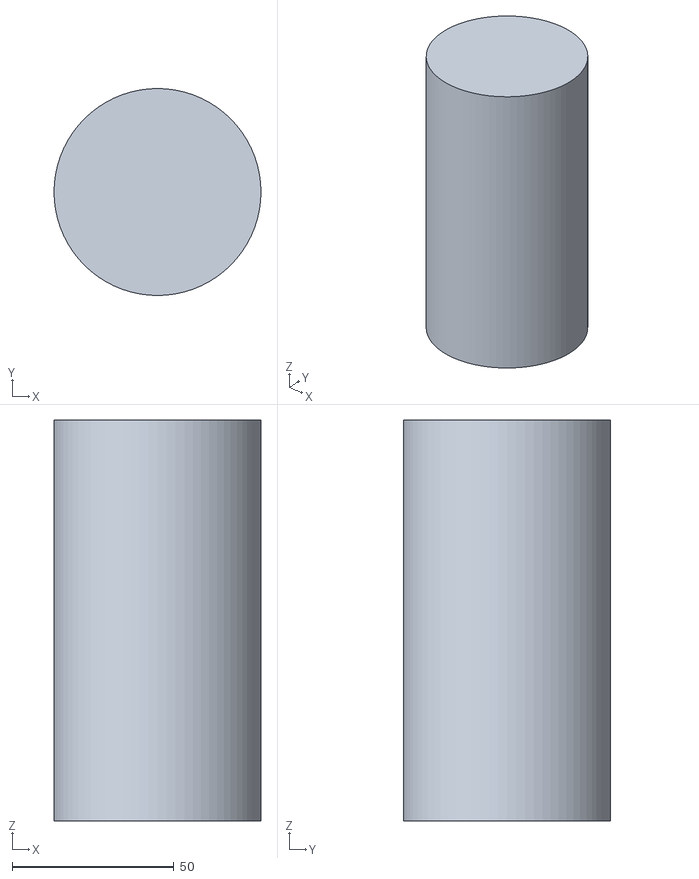
[picture p74: CAD file, 2026-11-02]
stl/j1r2_kin/proxies/M3_upper_arm.stl
64.0 x 64.0 x 124.0
