Koede/robot-arm/stl/j1r2_mounts/MJ1/MJ1_clasp_bracket_R.stl

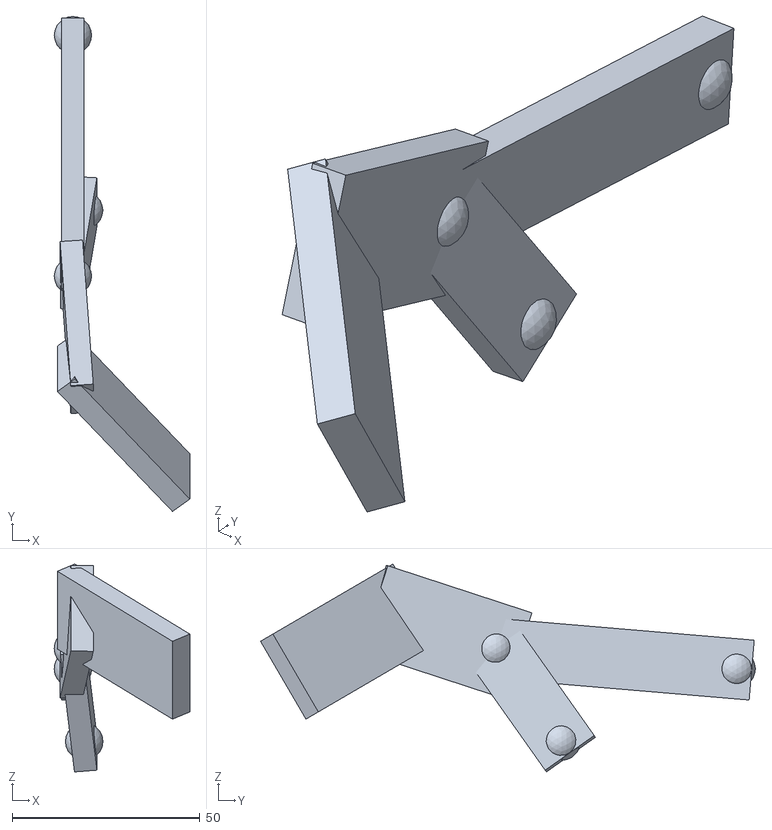
[picture p75: CAD file, 2026-11-02]
stl/j1r2_mounts/MJ1/MJ1_clasp_bracket_R.stl
36.1 x 131.9 x 55.4
