Koede/robot-arm/stl/j1r2_mounts/MJ10/MJ10_rungs_R.stl

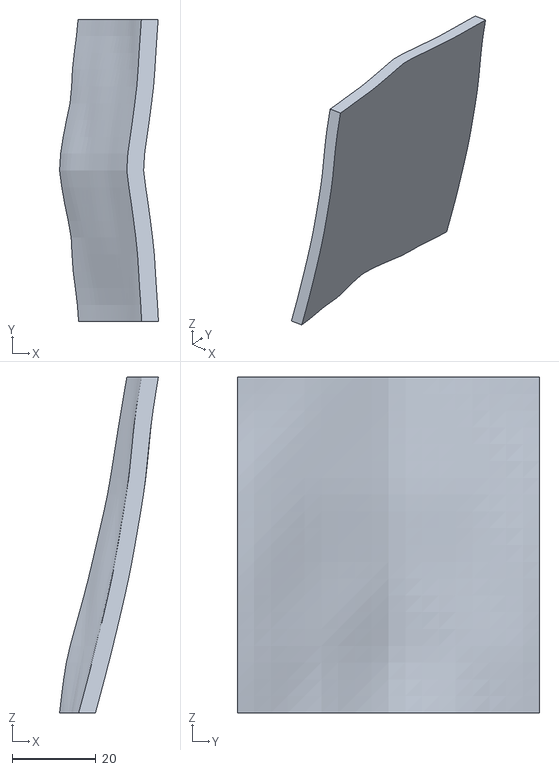
[picture p76: CAD file, 2026-11-02]
stl/j1r2_mounts/MJ10/MJ10_rungs_R.stl
23.5 x 72.0 x 80.0
