Koede/robot-arm/stl/j1r2_mounts/MJ11/MJ11_fairing_L.stl

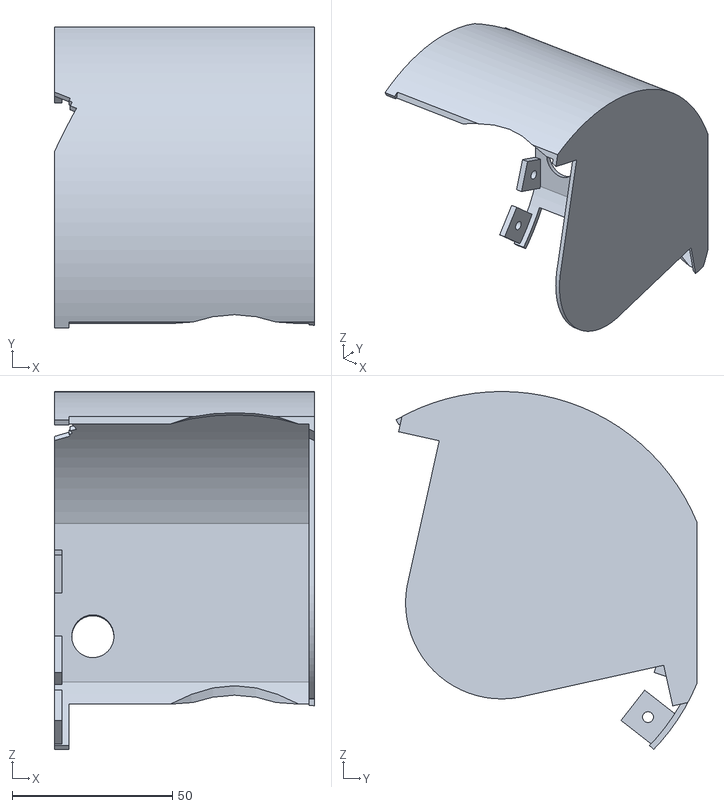
[picture p77: CAD file, 2026-11-03]
stl/j1r2_mounts/MJ11/MJ11_fairing_L.stl
81.2 x 94.0 x 111.8
