Koede/robot-arm/stl/j1r2_mounts/MJ2/MJ2_bal_tube_radial_R.stl

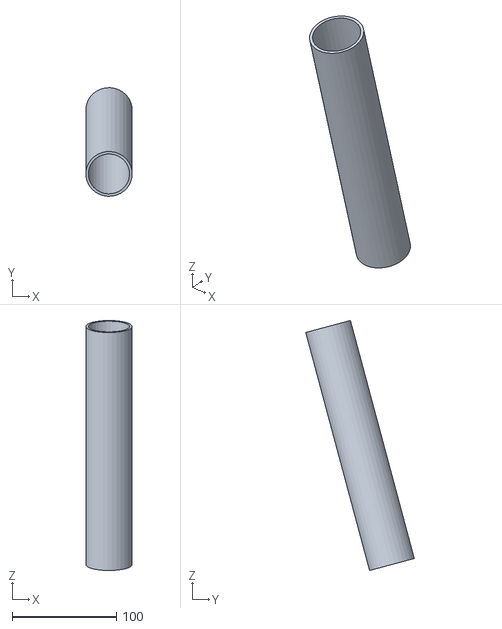
[picture p78: CAD file, 2026-11-02]
stl/j1r2_mounts/MJ2/MJ2_bal_tube_radial_R.stl
44.4 x 104.1 x 239.4
