Koede/robot-arm/stl/j1r2_mounts/MJ3/MJ3_yoke_clamps_L.stl

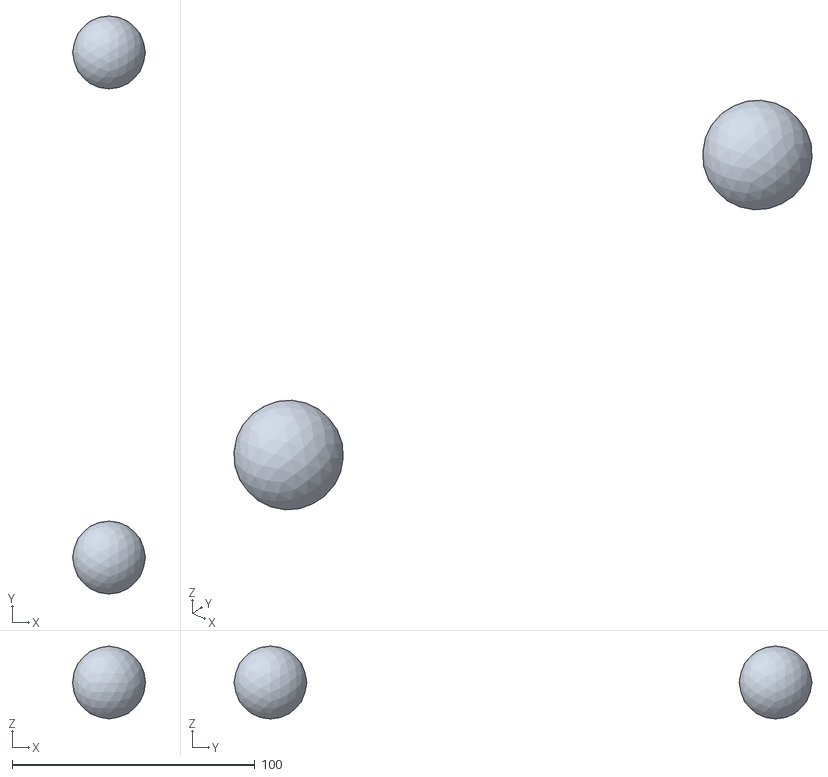
[picture p79: CAD file, 2026-11-02]
stl/j1r2_mounts/MJ3/MJ3_yoke_clamps_L.stl
30.0 x 238.0 x 30.0
