Koede/robot-arm/stl/j1r2_mounts/MJ5/MJ5_cam_lever_R.stl

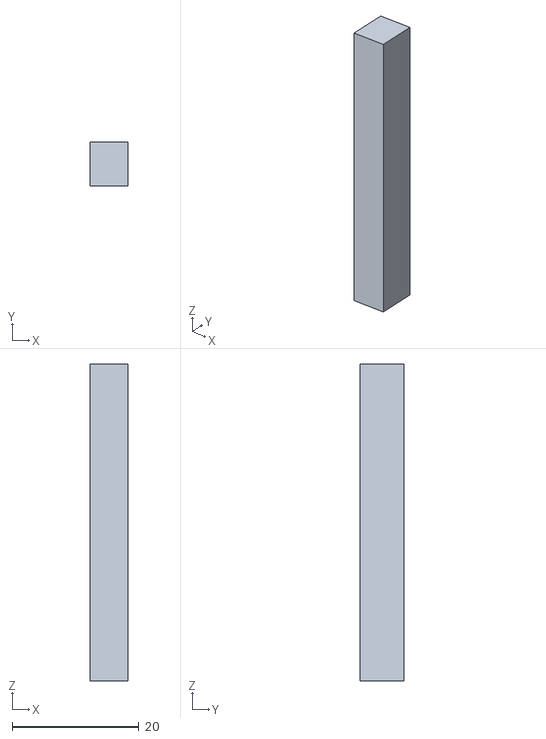
[picture p80: CAD file, 2026-11-02]
stl/j1r2_mounts/MJ5/MJ5_cam_lever_R.stl
6.00 x 7.00 x 50.0
