Koede/robot-arm/stl/j1r2_mounts/MJ6/MJ6_monocoque_R.stl

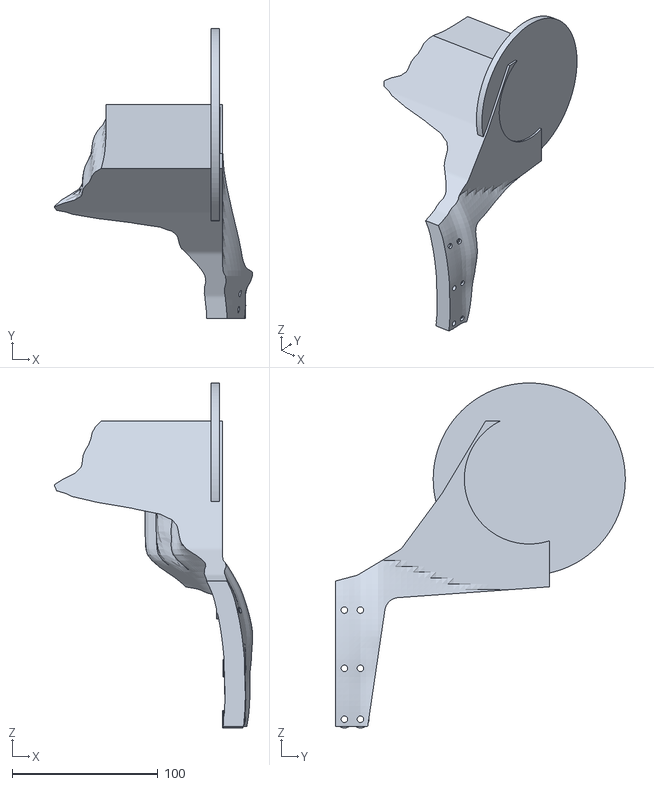
[picture p81: CAD file, 2026-11-02]
stl/j1r2_mounts/MJ6/MJ6_monocoque_R.stl
136.3 x 199.0 x 237.0
