Koede/robot-arm/stl/j1r2_mounts/MJ7/MJ7_spar_L.stl

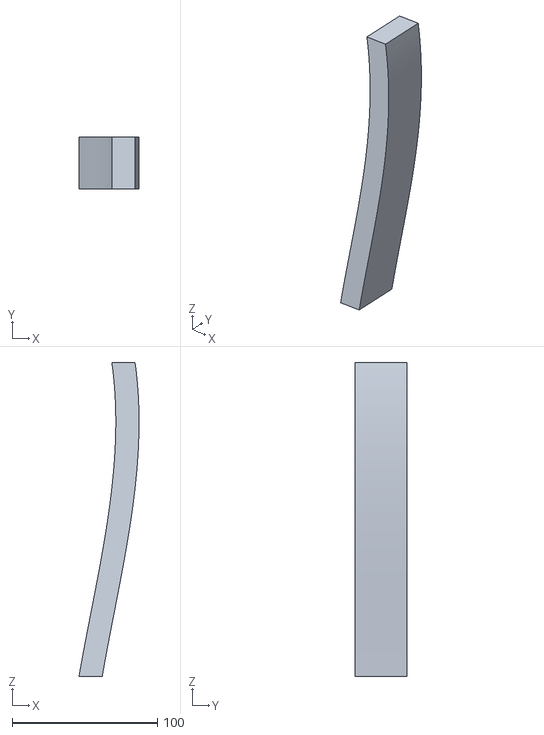
[picture p82: CAD file, 2026-11-02]
stl/j1r2_mounts/MJ7/MJ7_spar_L.stl
41.3 x 36.0 x 216.0
