Koede/robot-arm/stl/j1r2_mounts/MJ8/MJ8_tubes_L.stl

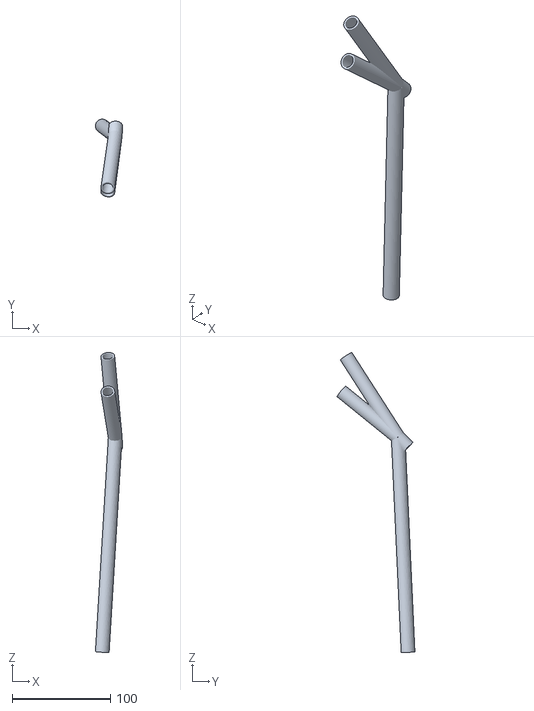
[picture p83: CAD file, 2026-11-02]
stl/j1r2_mounts/MJ8/MJ8_tubes_L.stl
27.6 x 79.0 x 304.7
