Koede/robot-arm/stl/shoulder/clasp_frame_L.stl

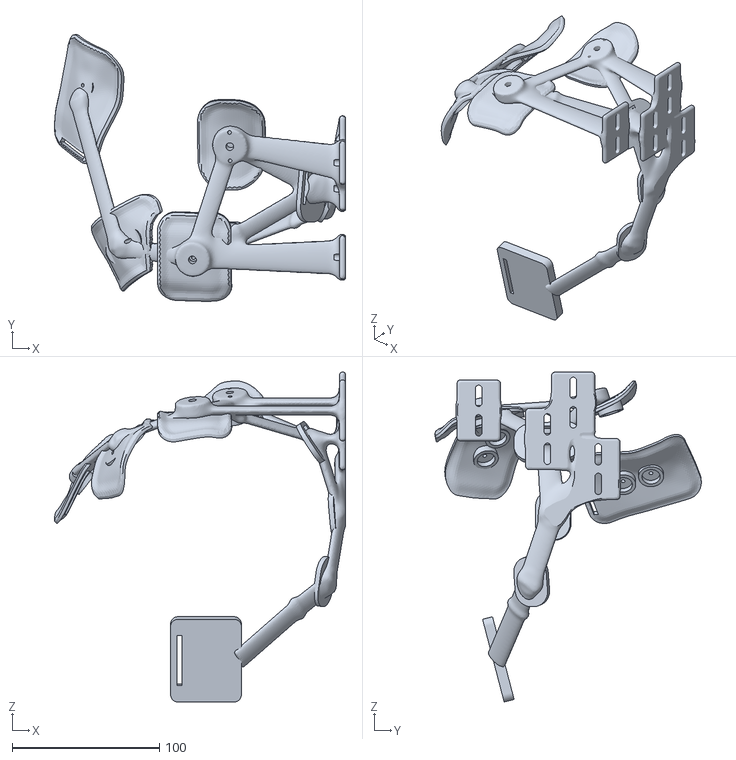
[picture p84: CAD file, 2026-10-23]
stl/shoulder/clasp_frame_L.stl
197.7 x 181.0 x 223.9
