Koede/robot-arm/stl/shoulder/cowl/cowl_R_b_negX.stl

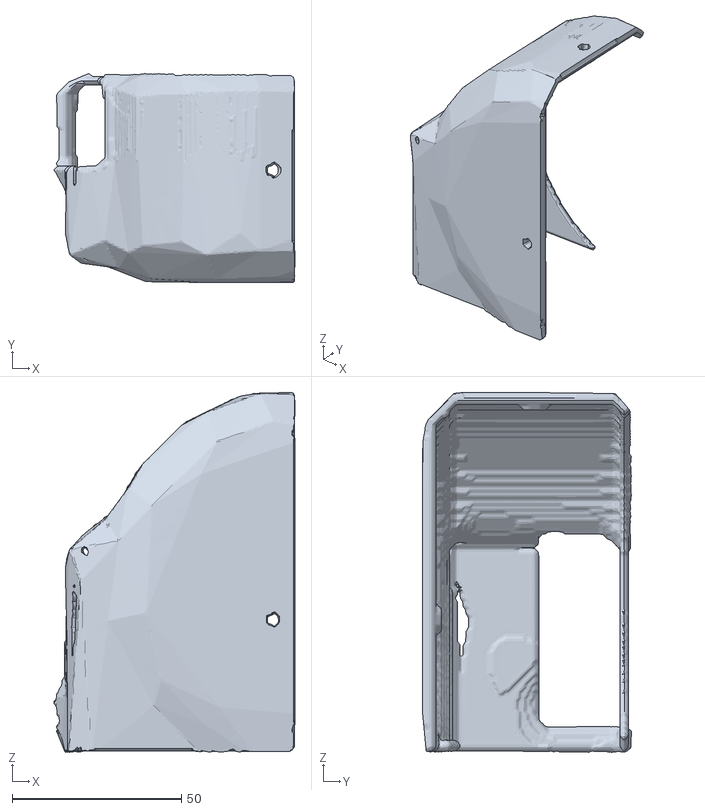
[picture p85: CAD file, 2026-10-23]
stl/shoulder/cowl/cowl_R_b_negX.stl
71.1 x 61.7 x 106.4
