Koede/robot-arm/stl/shoulder/pauldron/pauldron_arm_lat_R.stl

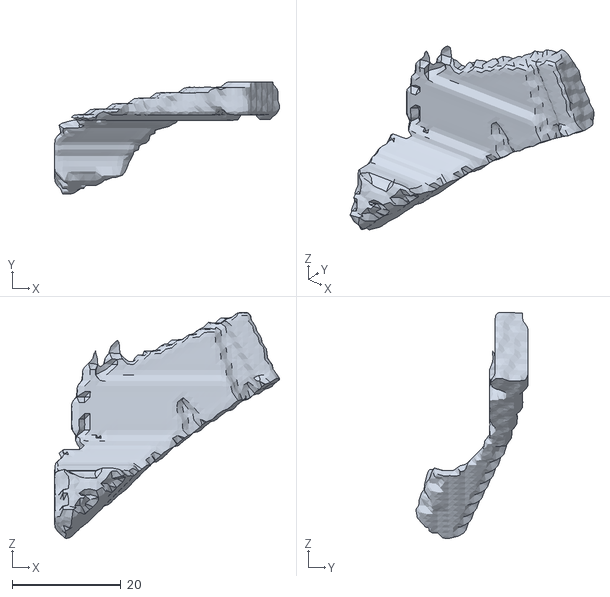
[picture p86: CAD file, 2026-10-23]
stl/shoulder/pauldron/pauldron_arm_lat_R.stl
41.3 x 20.7 x 41.6
