Koede/robot-arm/stl/shoulder/proxies/xm_s3_body.stl

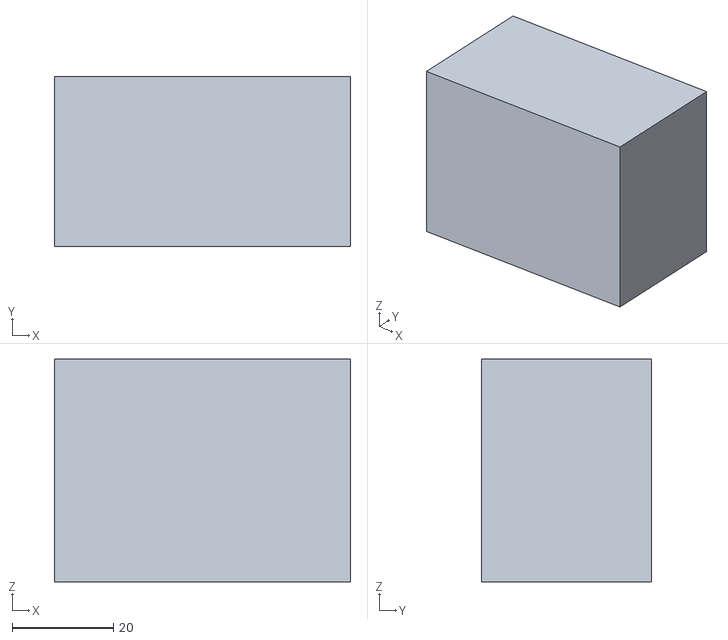
[picture p87: CAD file, 2026-10-23]
stl/shoulder/proxies/xm_s3_body.stl
58.5 x 33.5 x 44.0
