Koede/robot-arm/stl/shoulder/scapular/spine_bridge.stl

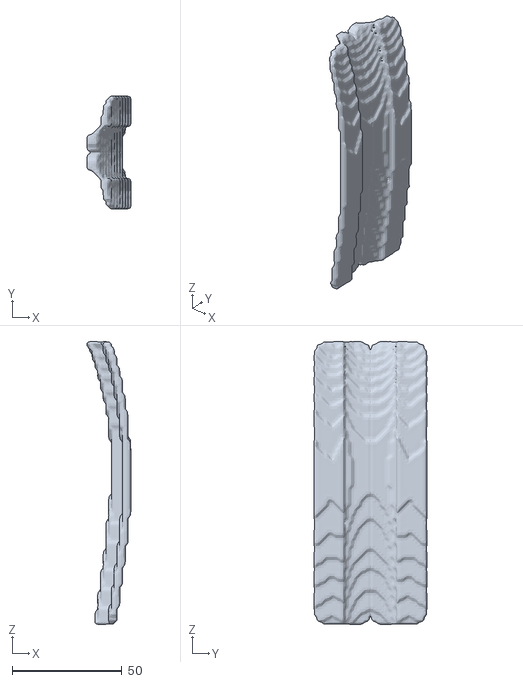
[picture p88: CAD file, 2026-10-23]
stl/shoulder/scapular/spine_bridge.stl
20.0 x 51.5 x 129.0
