Koede/robot-arm/stl/shoulder/skirts/tpu_skirt_F3_R.stl

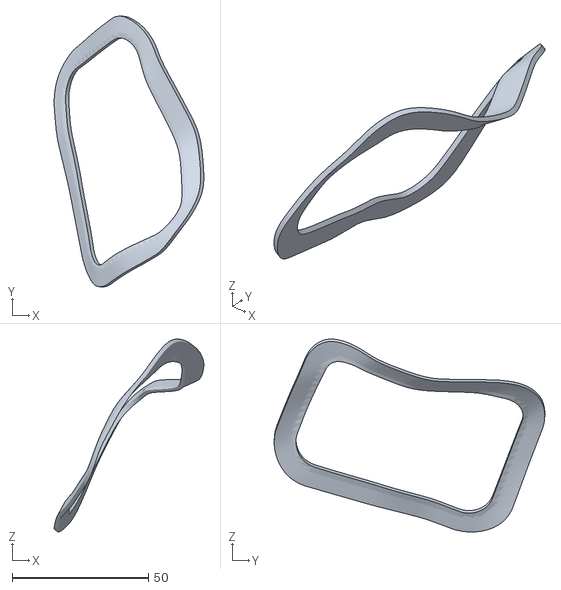
[picture p89: CAD file, 2026-10-23]
stl/shoulder/skirts/tpu_skirt_F3_R.stl
55.0 x 99.4 x 70.9
