Koede/robot-arm/stl/shoulder/stops/s1_post_b_R.stl

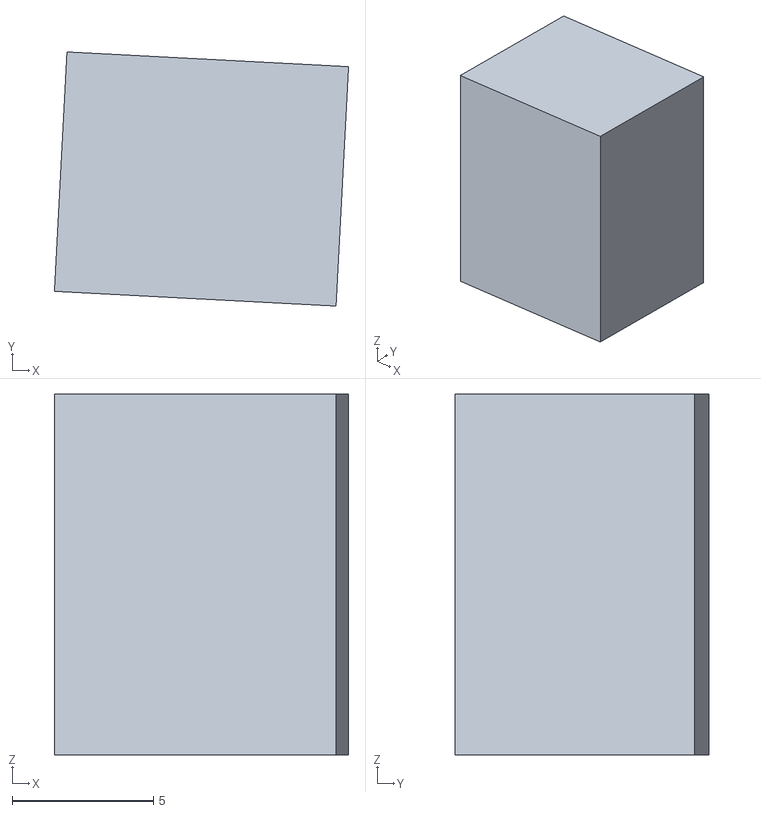
[picture p90: CAD file, 2026-10-23]
stl/shoulder/stops/s1_post_b_R.stl
10.4 x 9.01 x 12.8
