Koede/robot-arm/stl/upperarm/fork_idler_R.stl

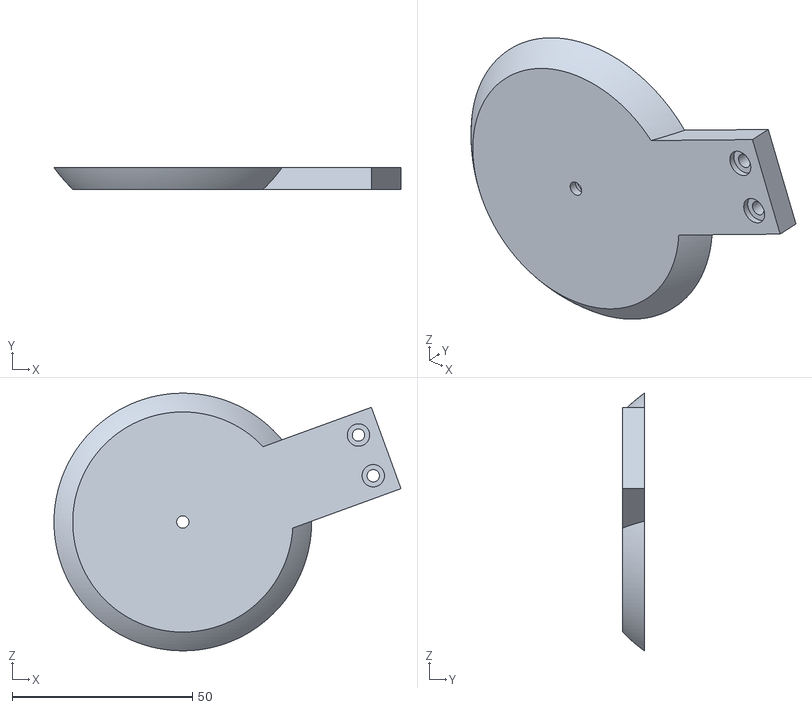
[picture p91: CAD file, 2026-10-23]
stl/upperarm/fork_idler_R.stl
96.2 x 6.00 x 71.4
