Koede/robot-arm/stl/balancer/tpu_s2_neg_bump_R.stl

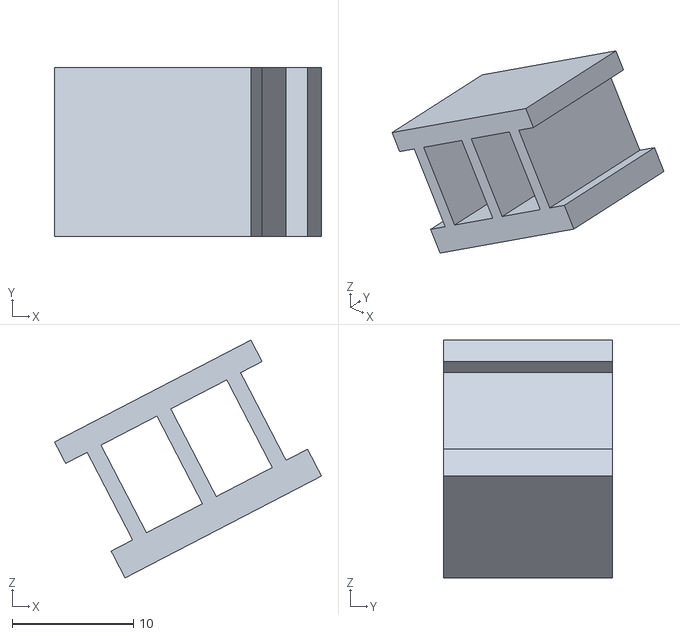
[picture p92: CAD file, 2026-10-23]
stl/balancer/tpu_s2_neg_bump_R.stl
22.1 x 14.0 x 19.7
