Koede/robot-arm/stl/concepts_study/C1/C1_s1_base_block_R.stl

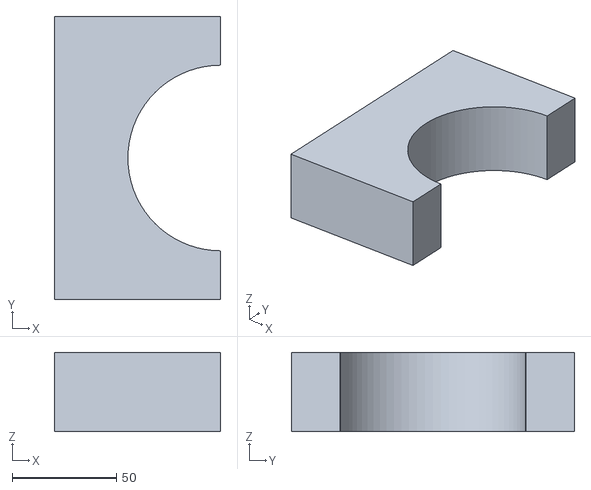
[picture p93: CAD file, 2026-11-02]
stl/concepts_study/C1/C1_s1_base_block_R.stl
80.0 x 136.0 x 38.0
