Koede/robot-arm/stl/concepts_study/C2/C2_plate_doubler_6061_R.stl

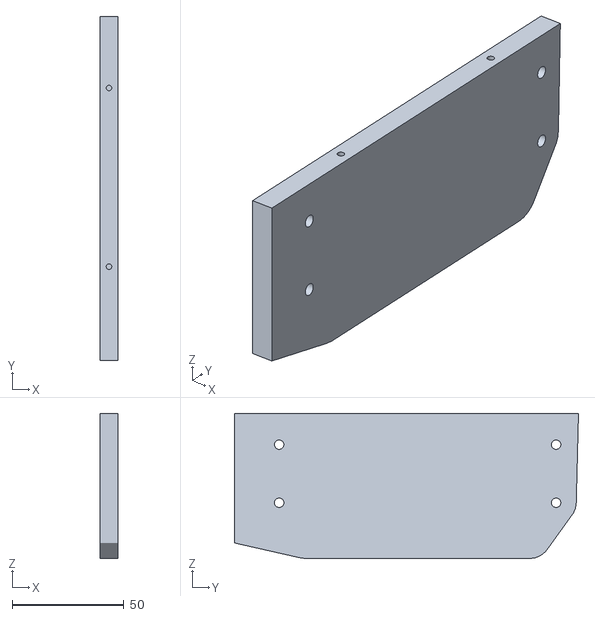
[picture p94: CAD file, 2026-11-02]
stl/concepts_study/C2/C2_plate_doubler_6061_R.stl
8.00 x 154.0 x 65.0
