Koede/robot-arm/stl/concepts_study/C4/C4_armour_spaulder_R.stl

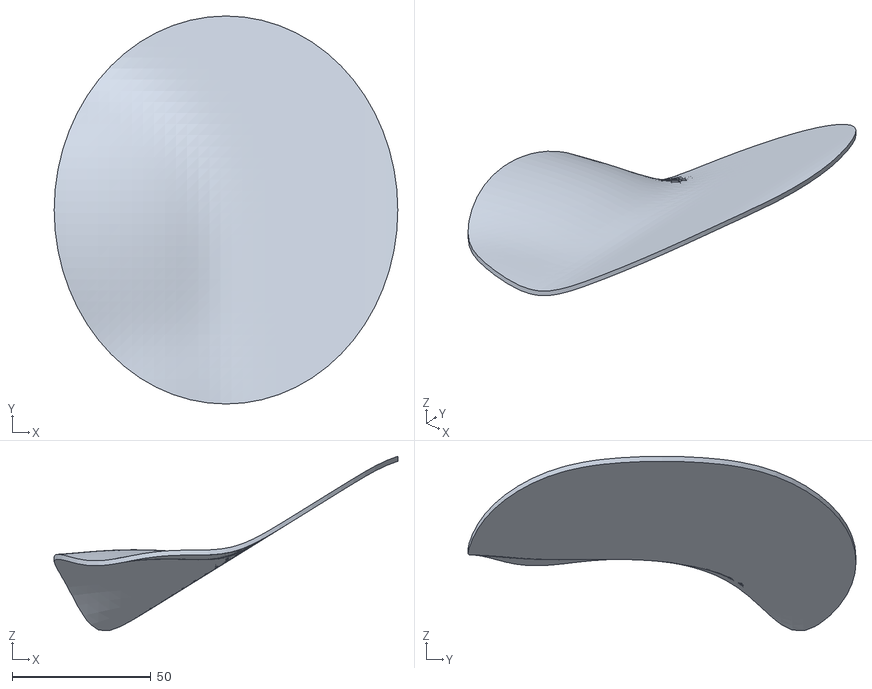
[picture p95: CAD file, 2026-11-02]
stl/concepts_study/C4/C4_armour_spaulder_R.stl
124.0 x 140.0 x 62.9
