Koede/robot-arm/stl/concepts_study/C5/C5_plate_6061_slotted_R.stl

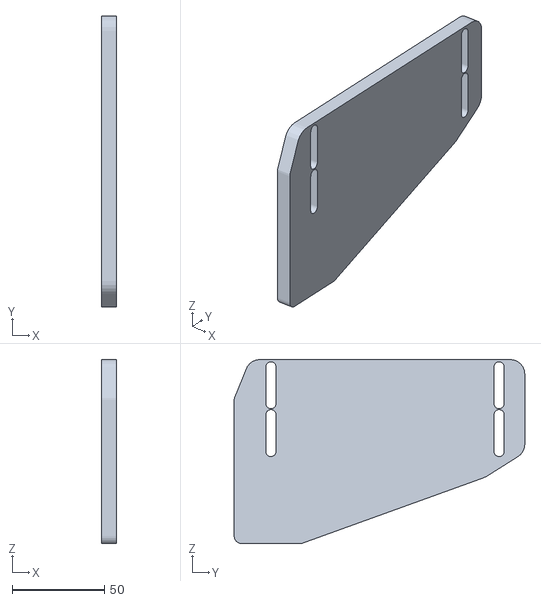
[picture p96: CAD file, 2026-11-02]
stl/concepts_study/C5/C5_plate_6061_slotted_R.stl
8.00 x 158.0 x 100.0
