Koede/robot-arm/stl/concepts_study/C6/C6_cage_crown_R.stl

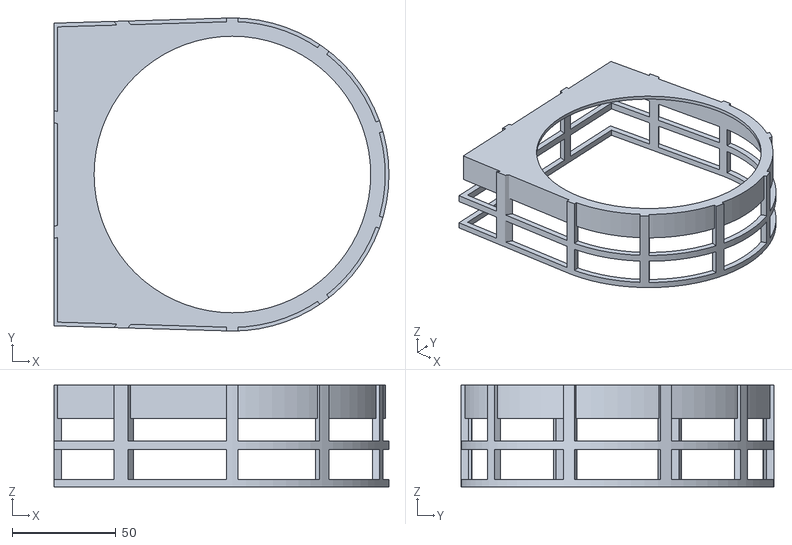
[picture p97: CAD file, 2026-11-02]
stl/concepts_study/C6/C6_cage_crown_R.stl
161.1 x 150.6 x 49.0
