Koede/robot-arm/stl/concepts_study/J1/J1_S2_AK70_R.stl

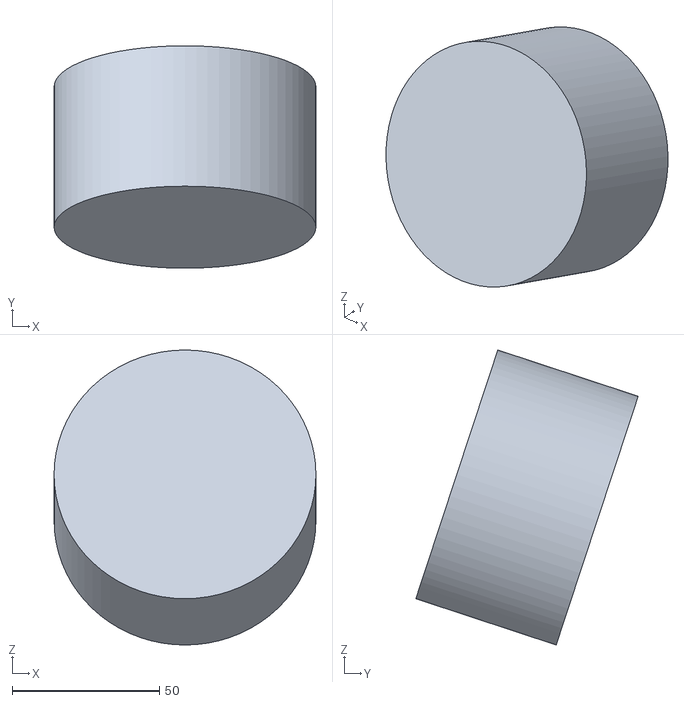
[picture p98: CAD file, 2026-11-02]
stl/concepts_study/J1/J1_S2_AK70_R.stl
89.0 x 75.6 x 100.3
