Koede/robot-arm/stl/concepts_study/J1R2/J1R2_cable_M1_R.stl

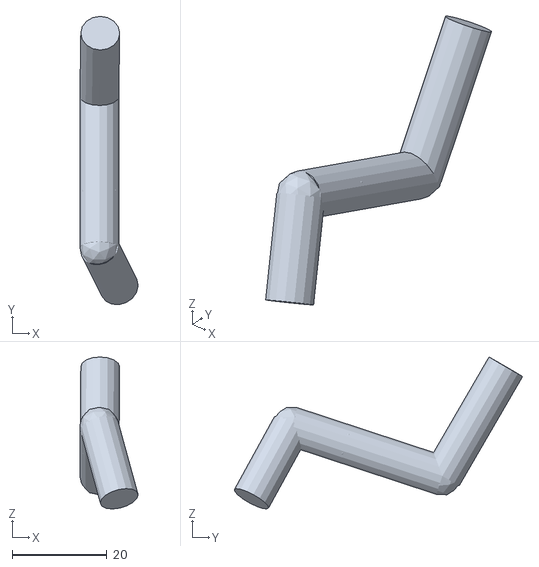
[picture p99: CAD file, 2026-11-02]
stl/concepts_study/J1R2/J1R2_cable_M1_R.stl
12.3 x 60.7 x 32.0
