Koede/robot-arm/stl/concepts_study/J3/J3_upper_arm_tube_R.stl

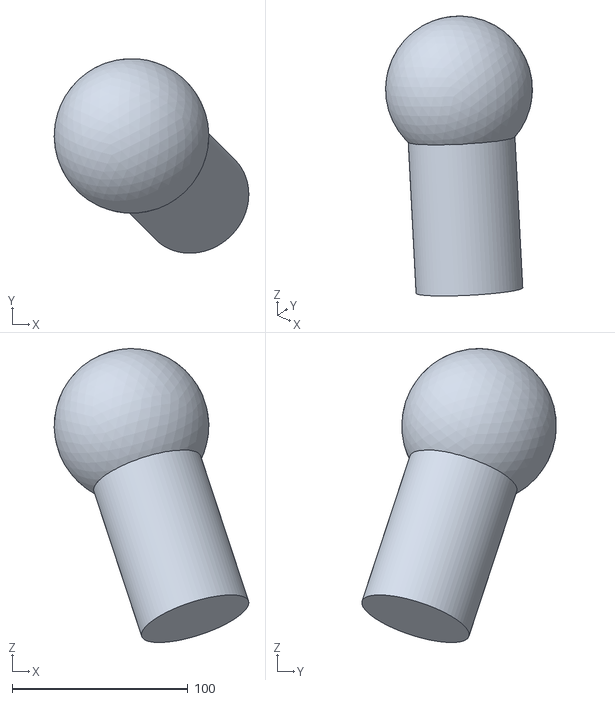
[picture p100: CAD file, 2026-11-02]
stl/concepts_study/J3/J3_upper_arm_tube_R.stl
110.7 x 110.6 x 167.2
