Koede/robot-arm/stl/concepts_study/J4/J4_xm540_S3_R.stl

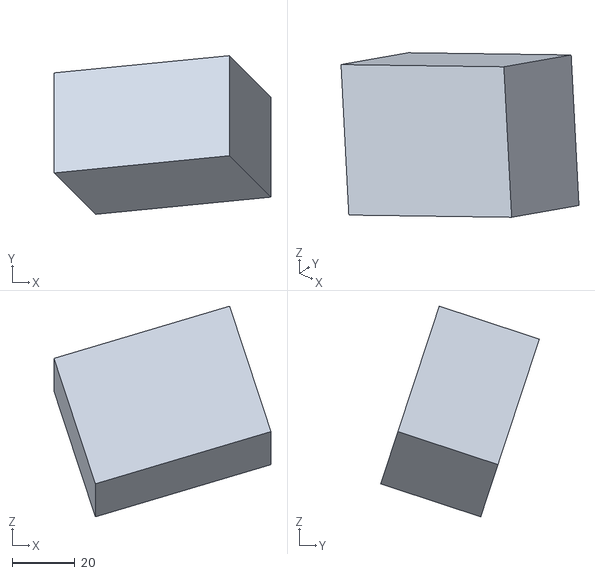
[picture p101: CAD file, 2026-11-02]
stl/concepts_study/J4/J4_xm540_S3_R.stl
69.0 x 50.4 x 67.0
