Koede/robot-arm/stl/concepts_study/J5/J5_ak70_S2_R.stl

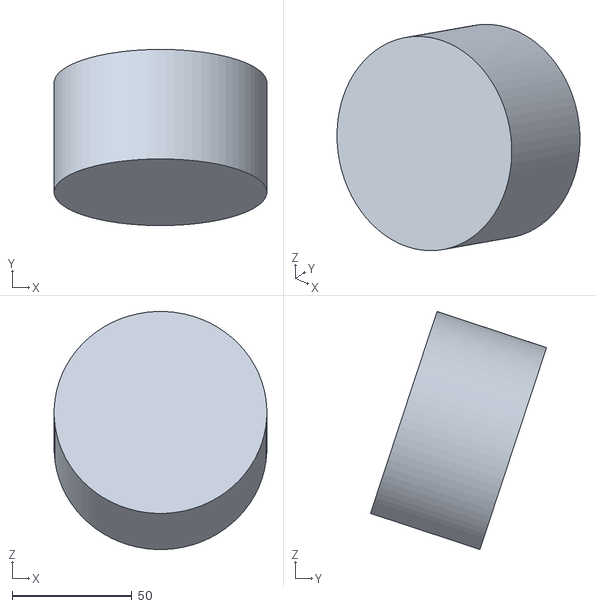
[picture p102: CAD file, 2026-11-02]
stl/concepts_study/J5/J5_ak70_S2_R.stl
88.9 x 73.7 x 99.6
