Koede/robot-arm/stl/concepts_study/J6/J6_side_shaft_A_R.stl

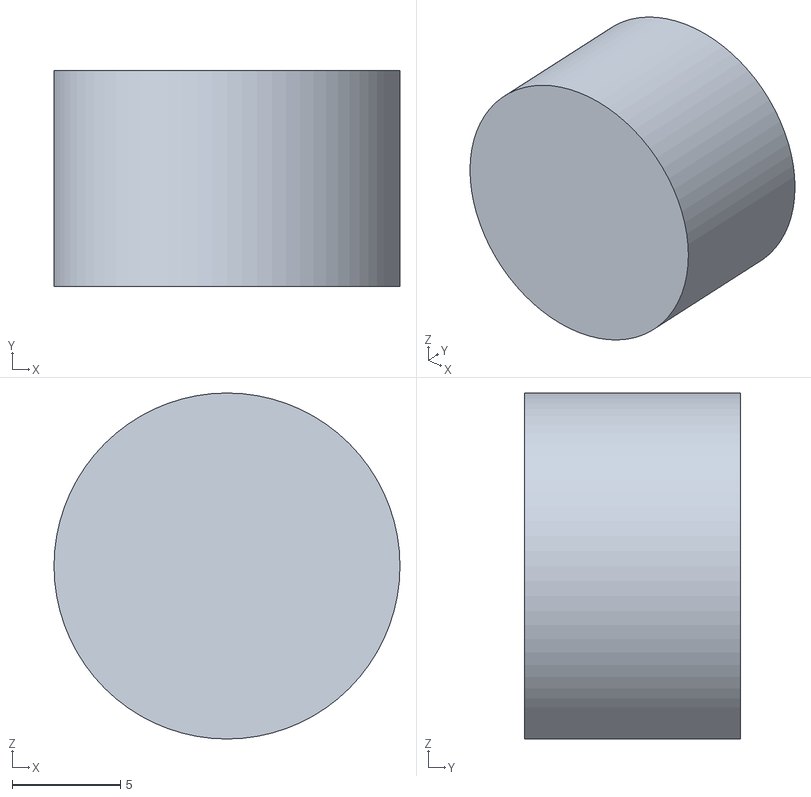
[picture p103: CAD file, 2026-11-02]
stl/concepts_study/J6/J6_side_shaft_A_R.stl
16.0 x 10.0 x 16.0
