Koede/robot-arm/stl/distal/claw/dist_F.stl

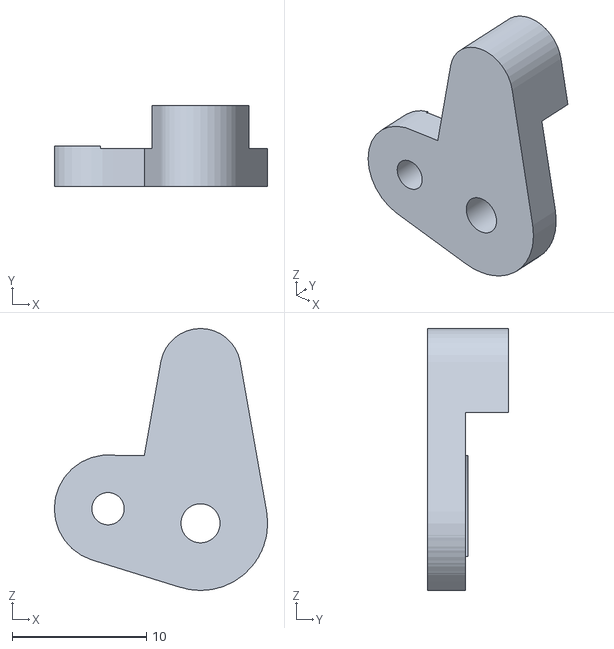
[picture p104: CAD file, 2026-10-23]
stl/distal/claw/dist_F.stl
15.9 x 6.00 x 19.5
