Koede/robot-arm/stl/distal/claw/proxies/pin_R_F.stl

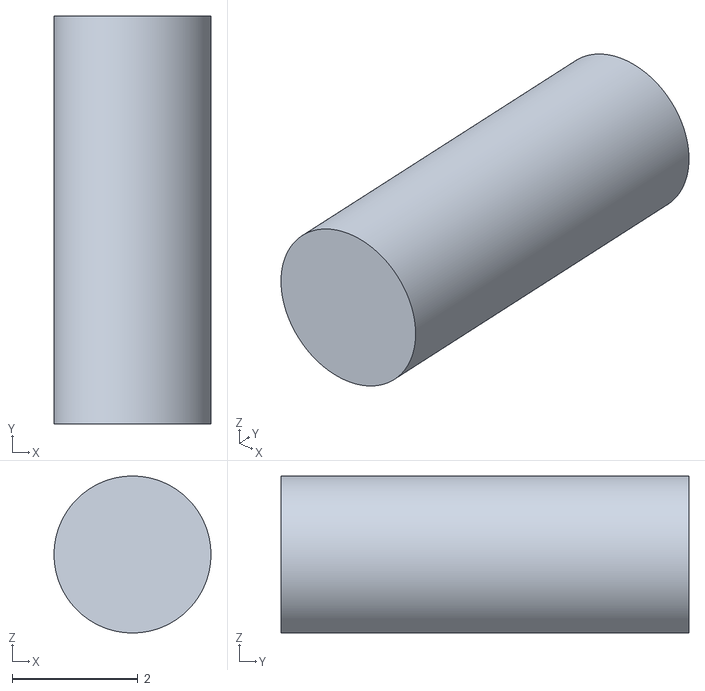
[picture p105: CAD file, 2026-10-23]
stl/distal/claw/proxies/pin_R_F.stl
2.50 x 6.50 x 2.50
