Koede/robot-arm/stl/distal/proxies/bearing_6808_R.stl

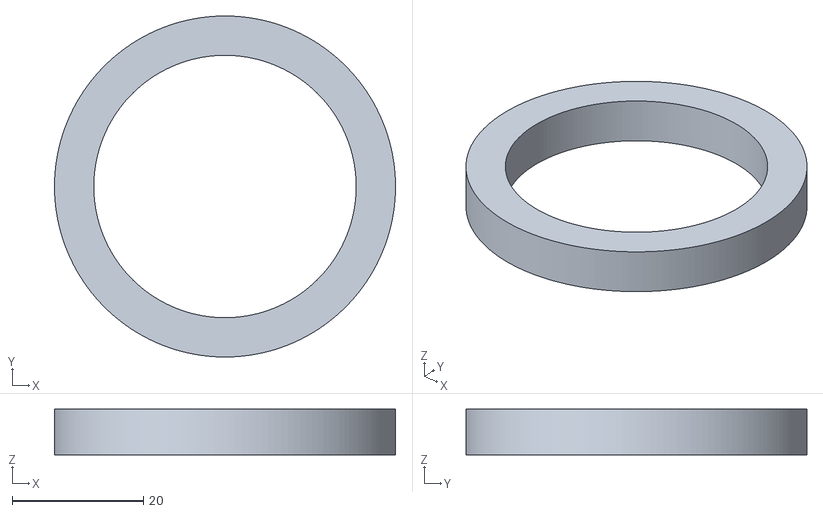
[picture p106: CAD file, 2026-10-23]
stl/distal/proxies/bearing_6808_R.stl
52.0 x 52.0 x 7.00
