Koede/robot-arm/stl/distal/stops_M2/tpu_s3_neg.stl

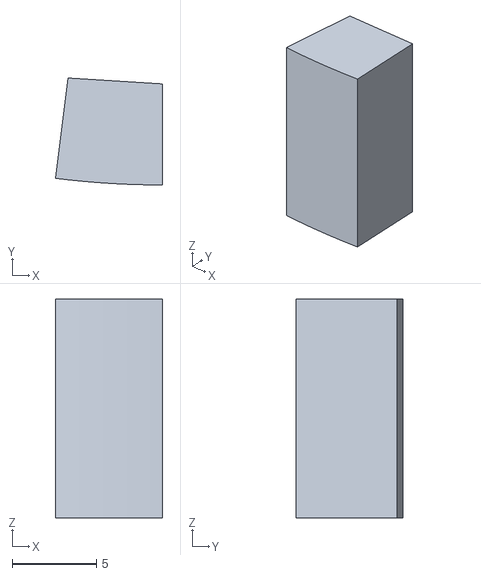
[picture p107: CAD file, 2026-10-23]
stl/distal/stops_M2/tpu_s3_neg.stl
6.36 x 6.35 x 13.0
