Koede/robot-arm/stl/distal/stops_M3/e_post_neg.stl

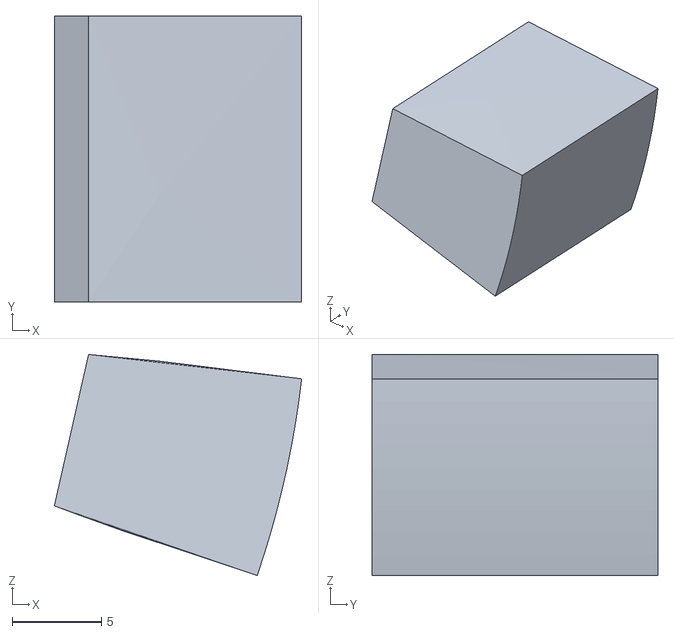
[picture p108: CAD file, 2026-10-23]
stl/distal/stops_M3/e_post_neg.stl
13.8 x 16.0 x 12.4
