Koede/robot-arm/stl/distal/stops_ME/tpu_w1_pos.stl

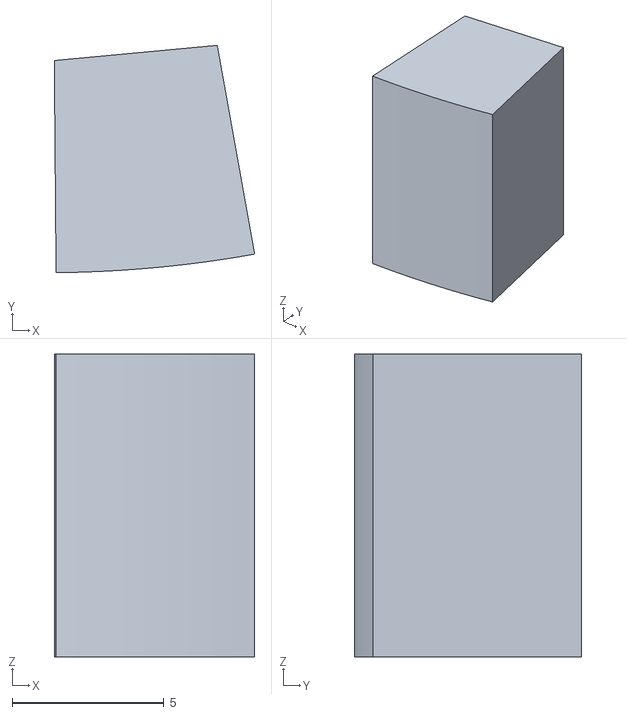
[picture p109: CAD file, 2026-10-23]
stl/distal/stops_ME/tpu_w1_pos.stl
6.61 x 7.50 x 10.0
