Koede/robot-arm/stl/distal/stops_MW1/w2_post_pos.stl

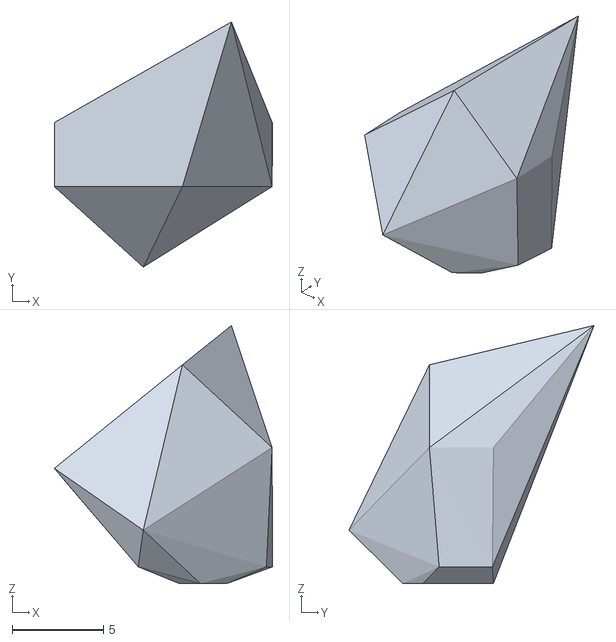
[picture p110: CAD file, 2026-10-23]
stl/distal/stops_MW1/w2_post_pos.stl
11.9 x 13.4 x 14.1
