Koede/robot-arm/stl/distal/stops_MW2/tpu_w3_neg.stl

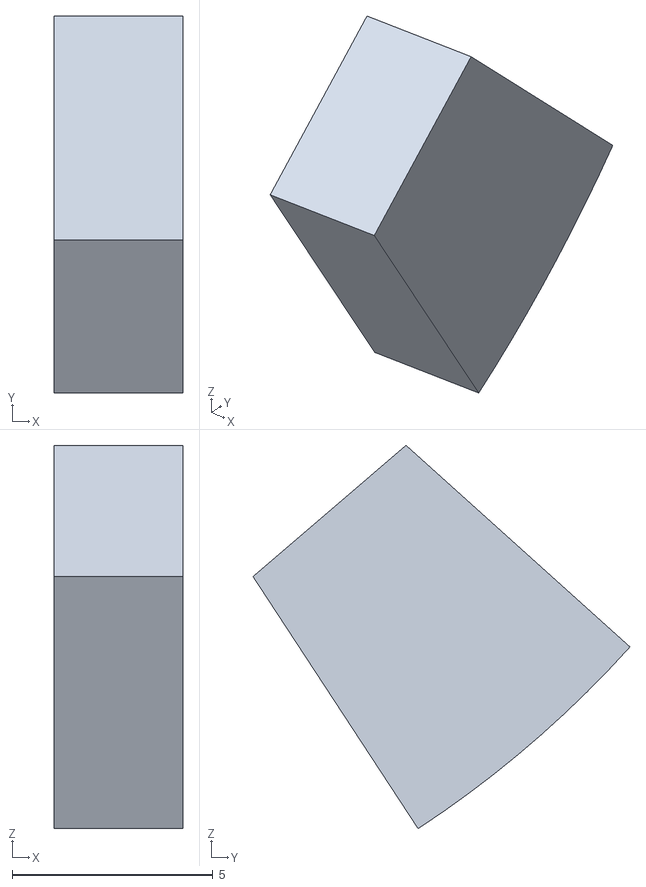
[picture p111: CAD file, 2026-10-23]
stl/distal/stops_MW2/tpu_w3_neg.stl
3.20 x 9.38 x 9.54
