Koede/robot-arm/stl/distal/w1_pinion_R.stl

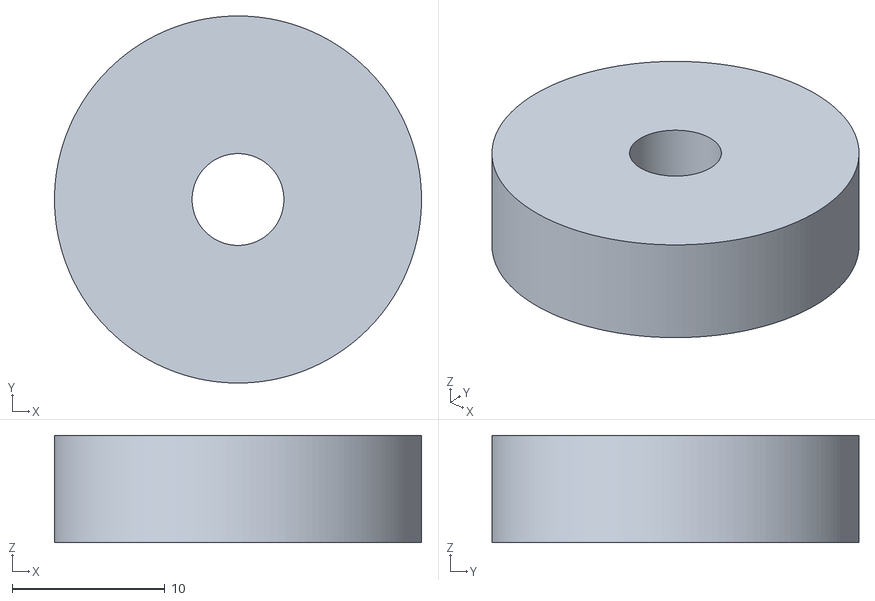
[picture p112: CAD file, 2026-10-23]
stl/distal/w1_pinion_R.stl
24.0 x 24.0 x 7.00
