Koede/robot-arm/stl/hand/poses/hand_open_posed.stl

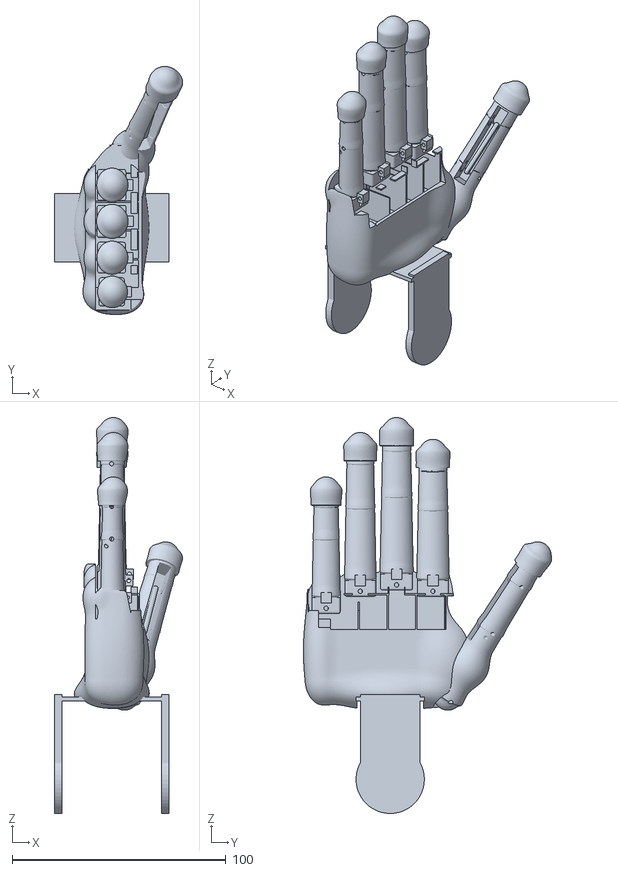
[picture p113: CAD file, 2026-10-31]
stl/hand/poses/hand_open_posed.stl
60.0 x 116.1 x 185.3
