Koede/robot-arm/stl/hand/thumb_meta.stl

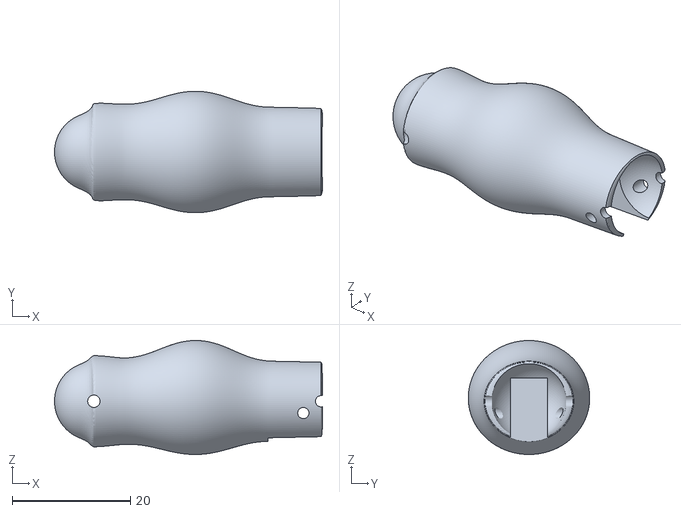
[picture p114: CAD file, 2026-10-31]
stl/hand/thumb_meta.stl
45.3 x 20.5 x 19.3
