Koede/robot-arm/stl/j1r2/tpu_S2_bumpers_L.stl

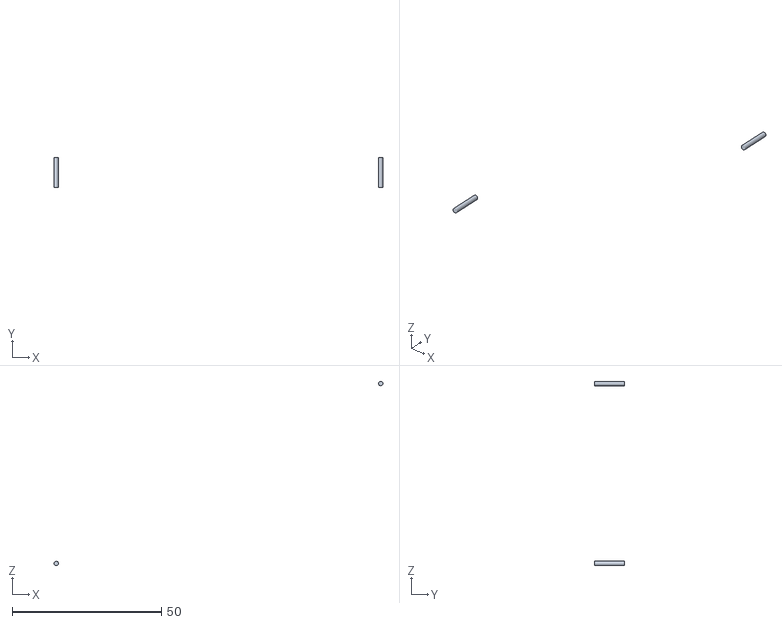
[picture p115: CAD file, 2026-11-02]
stl/j1r2/tpu_S2_bumpers_L.stl
110.2 x 10.0 x 61.8
