Koede/robot-arm/stl/j1r2_bal/bal_piston_R.stl

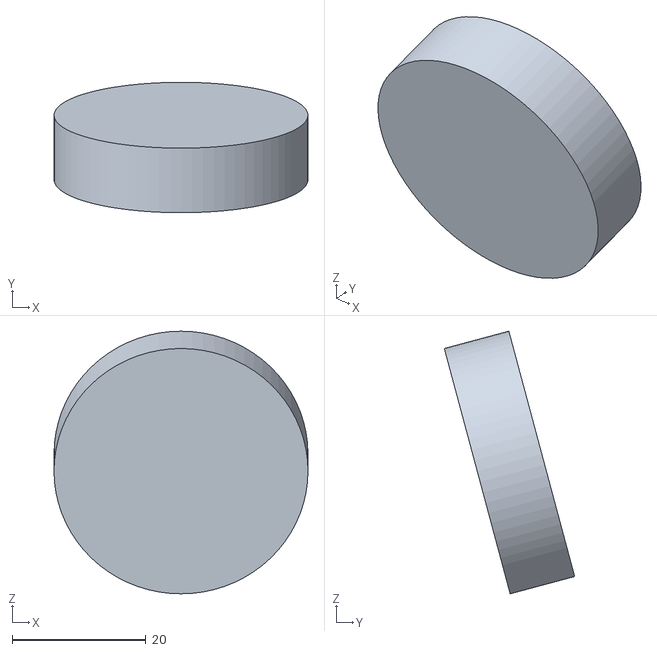
[picture p116: CAD file, 2026-11-02]
stl/j1r2_bal/bal_piston_R.stl
38.0 x 19.5 x 39.3
