Koede/robot-arm/stl/j1r2_kin/proxies/ME_elbow_bridge.stl

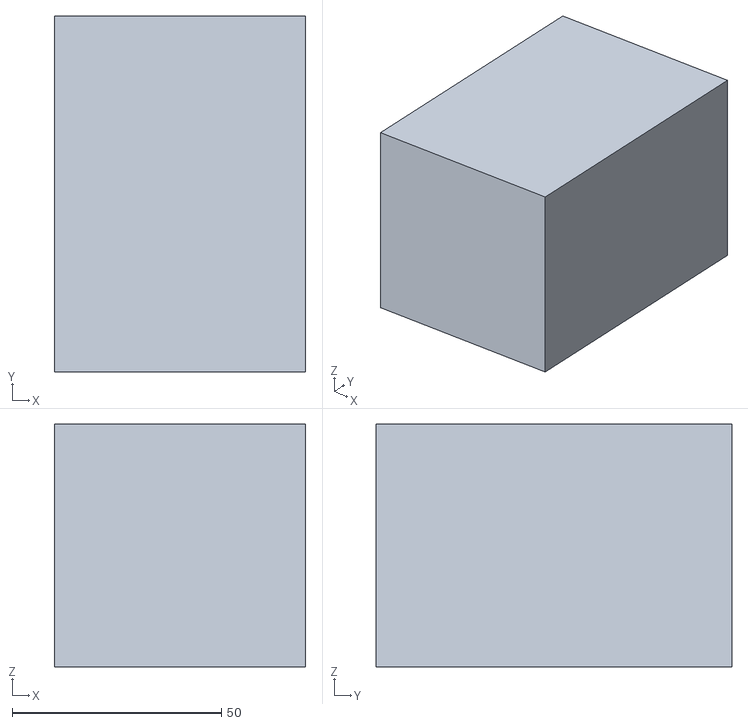
[picture p117: CAD file, 2026-11-02]
stl/j1r2_kin/proxies/ME_elbow_bridge.stl
60.0 x 85.0 x 58.0
