Koede/robot-arm/stl/j1r2_mounts/MJ1/MJ1_knee_R.stl

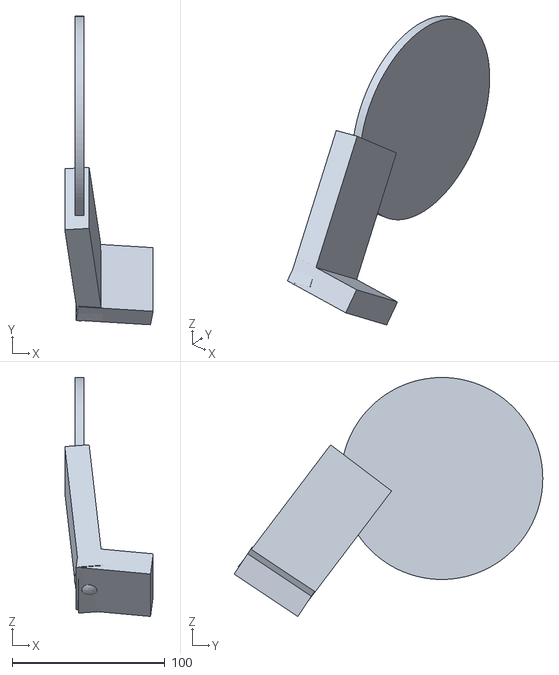
[picture p118: CAD file, 2026-11-02]
stl/j1r2_mounts/MJ1/MJ1_knee_R.stl
57.8 x 201.7 x 156.2
