Koede/robot-arm/stl/j1r2_mounts/MJ10/MJ10_posts_L.stl

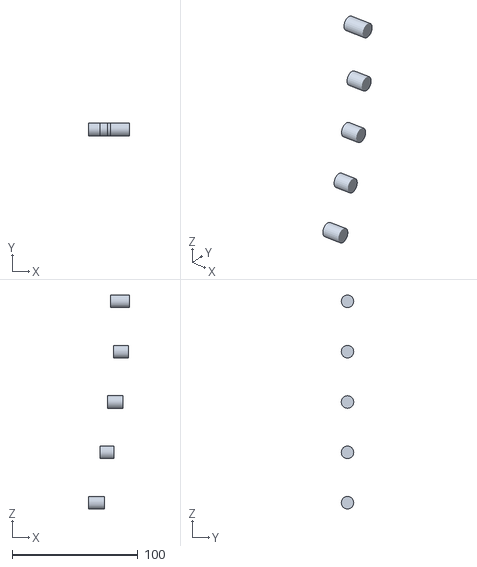
[picture p119: CAD file, 2026-11-02]
stl/j1r2_mounts/MJ10/MJ10_posts_L.stl
32.7 x 10.0 x 170.0
