Koede/robot-arm/stl/j1r2_mounts/MJ2/MJ2_clasp_bracket_R.stl

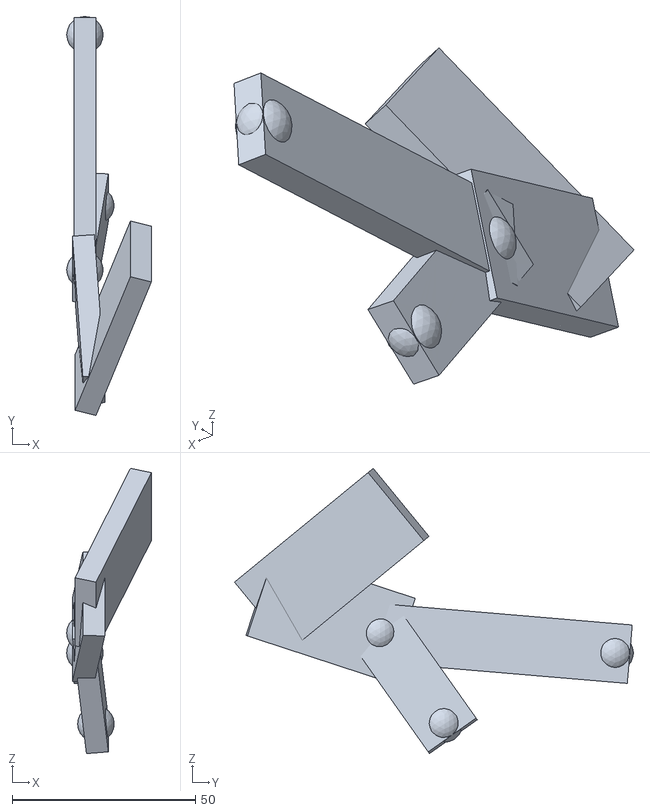
[picture p120: CAD file, 2026-11-02]
stl/j1r2_mounts/MJ2/MJ2_clasp_bracket_R.stl
23.1 x 108.9 x 77.9
