Koede/robot-arm/stl/j1r2_mounts/MJ3/MJ3_clasp_bracket_REF_R.stl

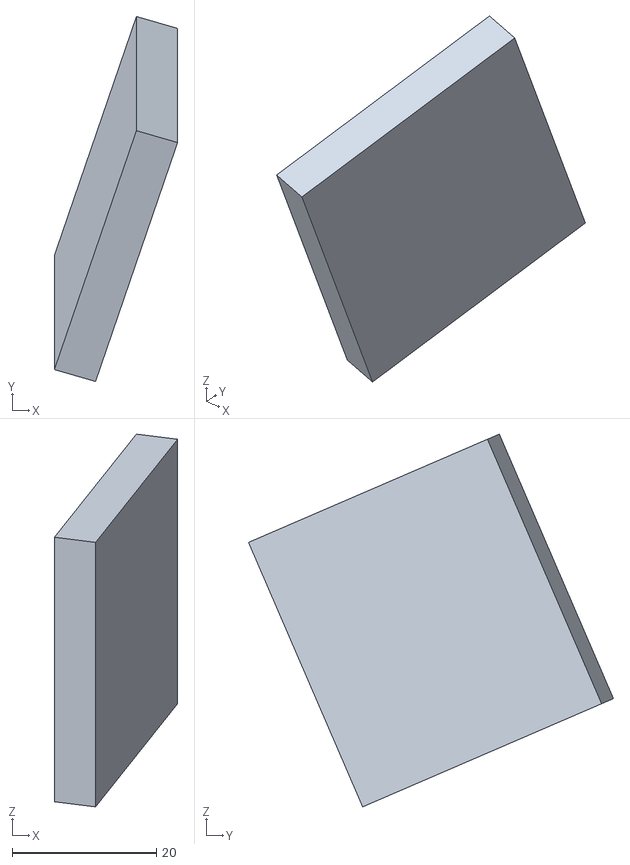
[picture p121: CAD file, 2026-11-02]
stl/j1r2_mounts/MJ3/MJ3_clasp_bracket_REF_R.stl
17.1 x 50.7 x 51.8
