Koede/robot-arm/stl/j1r2_mounts/MJ4/MJ4_nodes_R.stl

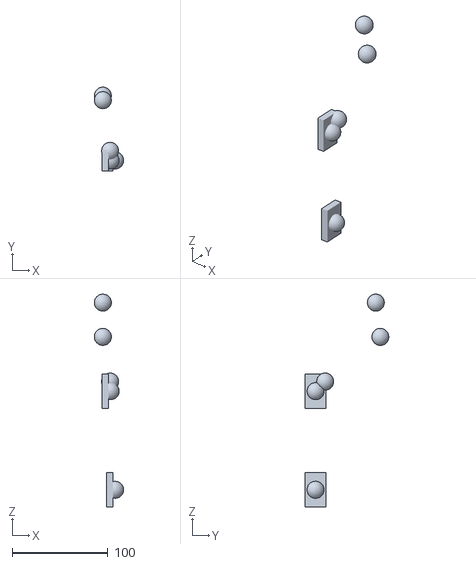
[picture p122: CAD file, 2026-11-02]
stl/j1r2_mounts/MJ4/MJ4_nodes_R.stl
30.8 x 87.6 x 222.4
