Koede/robot-arm/stl/j1r2_mounts/MJ6/MJ6_clasp_bracket_R.stl

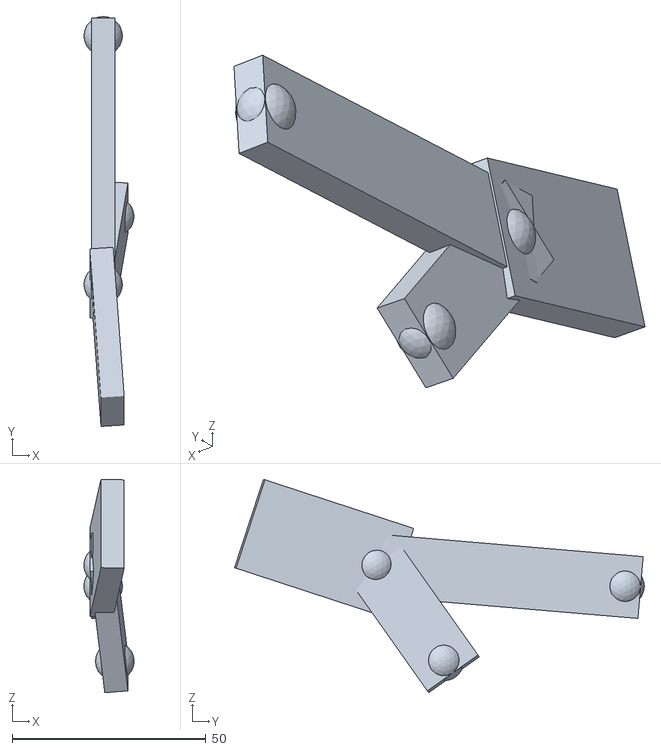
[picture p123: CAD file, 2026-11-02]
stl/j1r2_mounts/MJ6/MJ6_clasp_bracket_R.stl
13.0 x 105.8 x 55.1
