Koede/robot-arm/stl/shoulder/cowl/head_dome_R.stl

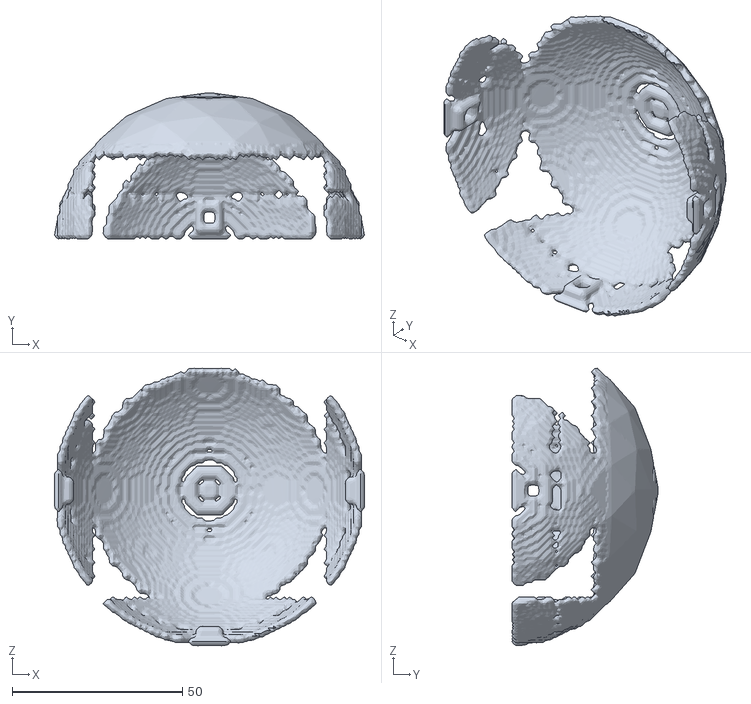
[picture p124: CAD file, 2026-10-23]
stl/shoulder/cowl/head_dome_R.stl
91.2 x 43.1 x 81.6
