Koede/robot-arm/stl/shoulder/pauldron/pauldron_R.stl

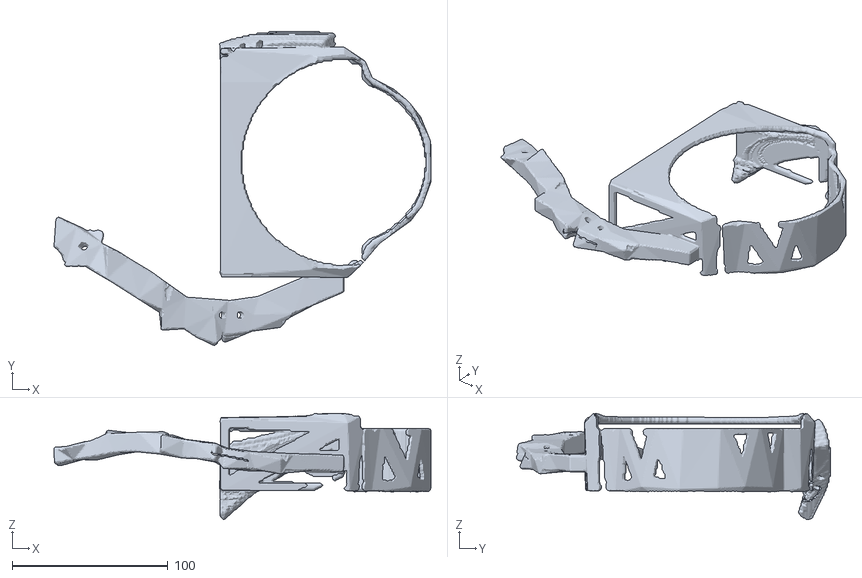
[picture p125: CAD file, 2026-10-23]
stl/shoulder/pauldron/pauldron_R.stl
241.8 x 201.7 x 68.2
