Koede/robot-arm/stl/shoulder/proxies/ak_s1_body.stl

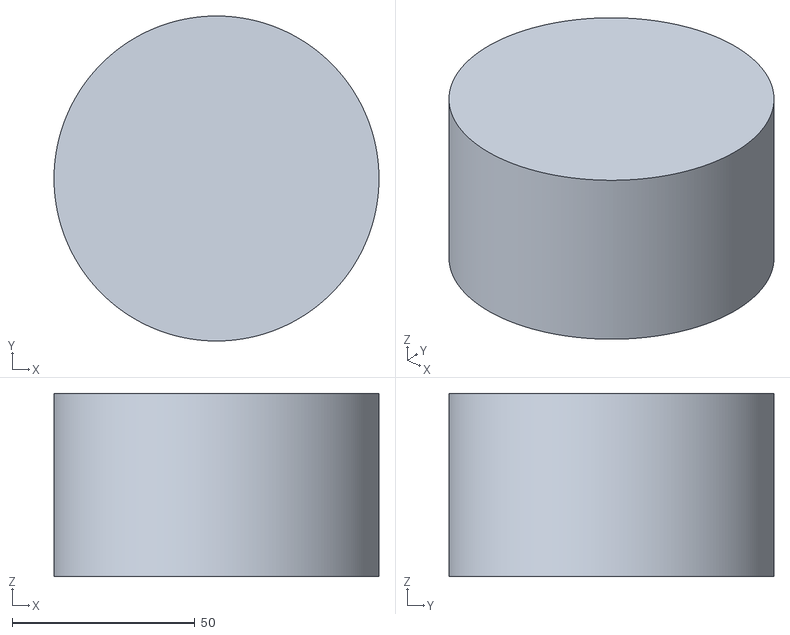
[picture p126: CAD file, 2026-10-23]
stl/shoulder/proxies/ak_s1_body.stl
89.0 x 89.0 x 50.2
