Koede/robot-arm/stl/shoulder/s1s2_yoke_R.stl

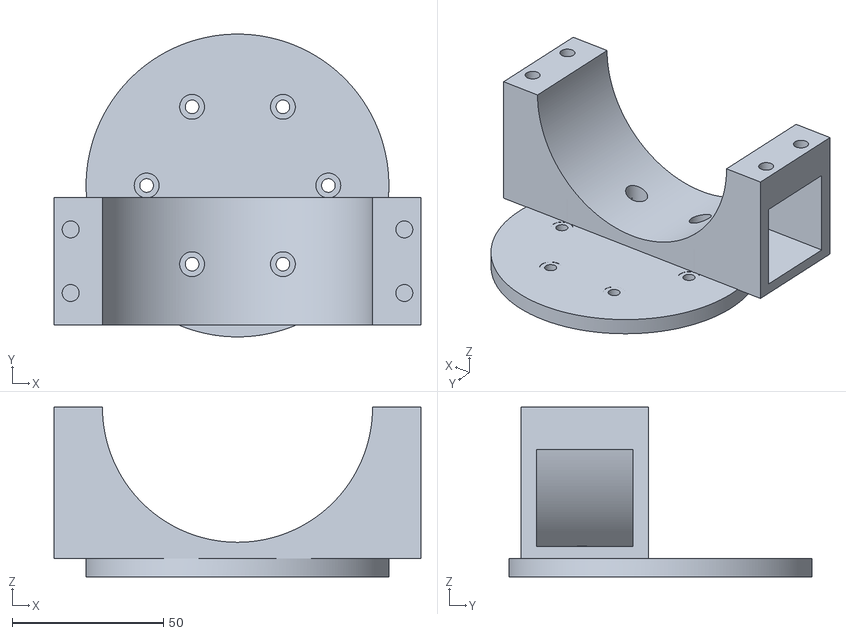
[picture p127: CAD file, 2026-10-23]
stl/shoulder/s1s2_yoke_R.stl
121.2 x 100.0 x 56.0
