Koede/robot-arm/stl/shoulder/scapular/wing_R_upper.stl

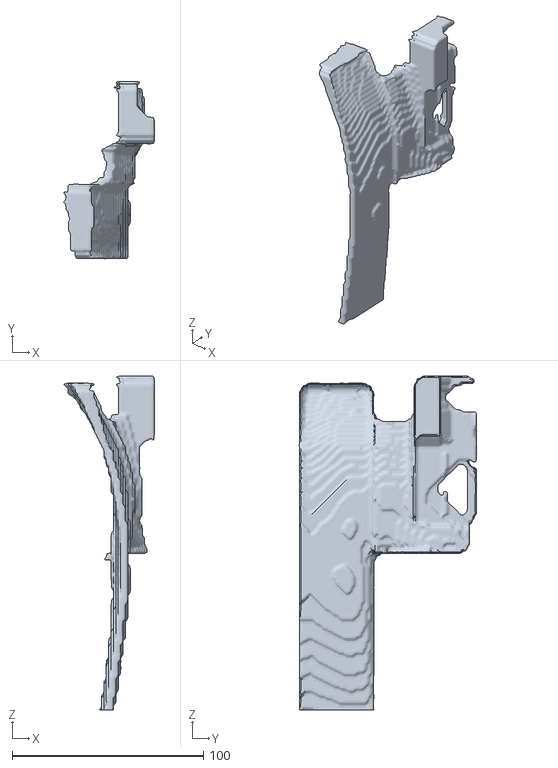
[picture p128: CAD file, 2026-10-23]
stl/shoulder/scapular/wing_R_upper.stl
47.4 x 92.7 x 174.5
