Koede/robot-arm/stl/shoulder/skirts/tpu_skirt_F1_L.stl

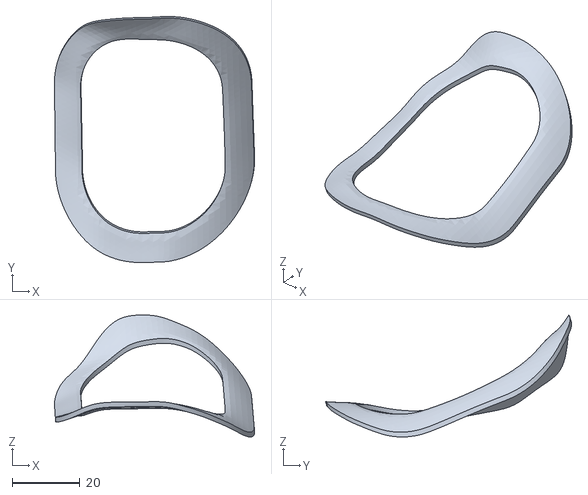
[picture p129: CAD file, 2026-10-23]
stl/shoulder/skirts/tpu_skirt_F1_L.stl
58.9 x 72.4 x 35.9
