Koede/robot-arm/stl/shoulder/stops/s1_lug_R.stl

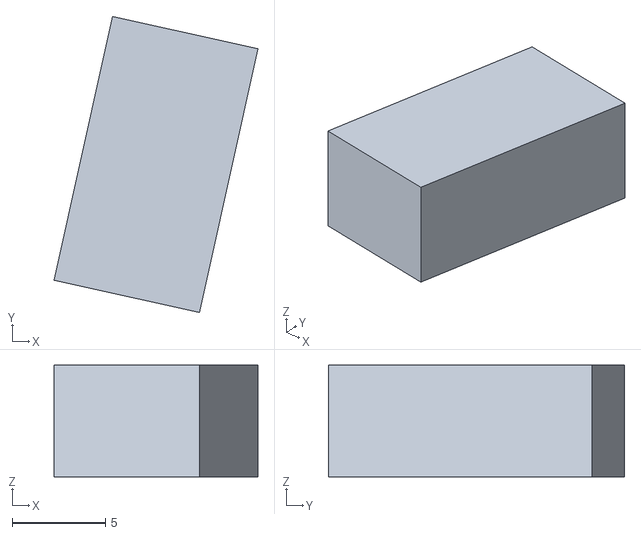
[picture p130: CAD file, 2026-10-23]
stl/shoulder/stops/s1_lug_R.stl
10.9 x 15.9 x 6.00
