Koede/robot-arm/stl/upperarm/ua_lat_R.stl

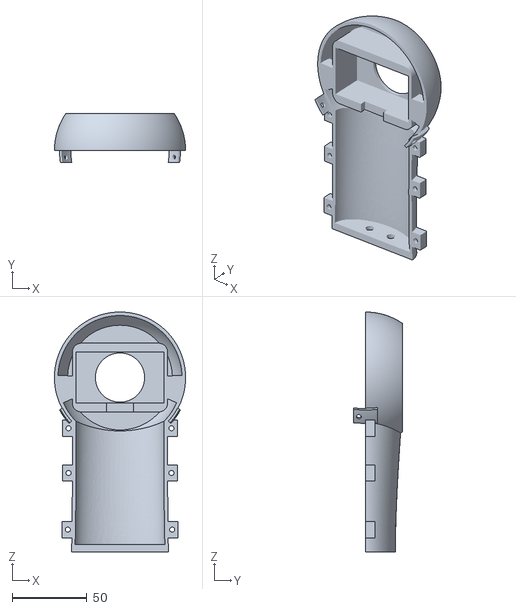
[picture p131: CAD file, 2026-10-23]
stl/upperarm/ua_lat_R.stl
88.0 x 32.7 x 161.0
