Koede/robot-arm/stl/balancer/tpu_s2_pos_bump_solid_R.stl

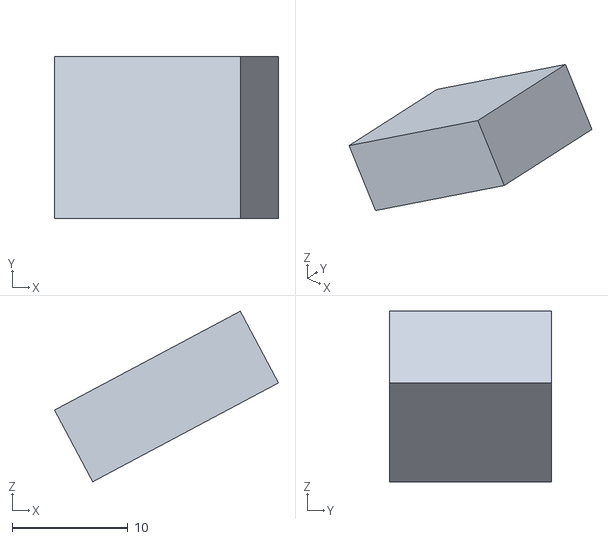
[picture p132: CAD file, 2026-10-23]
stl/balancer/tpu_s2_pos_bump_solid_R.stl
19.4 x 14.0 x 14.7
