Koede/robot-arm/stl/concepts_study/C1/C1_steel_doubler_2mm_R.stl

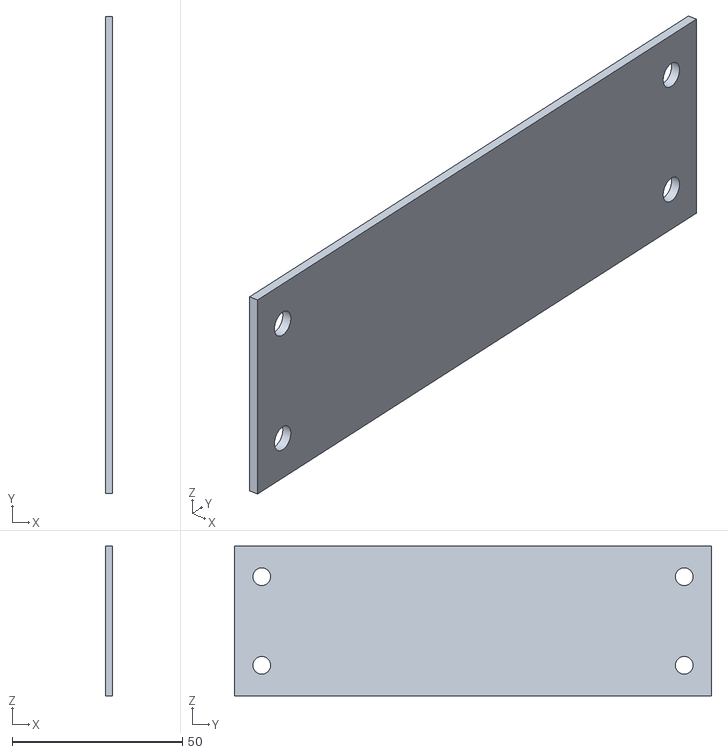
[picture p133: CAD file, 2026-11-02]
stl/concepts_study/C1/C1_steel_doubler_2mm_R.stl
2.00 x 140.0 x 44.0
