Koede/robot-arm/stl/concepts_study/C3/C3_column_pacf_R.stl

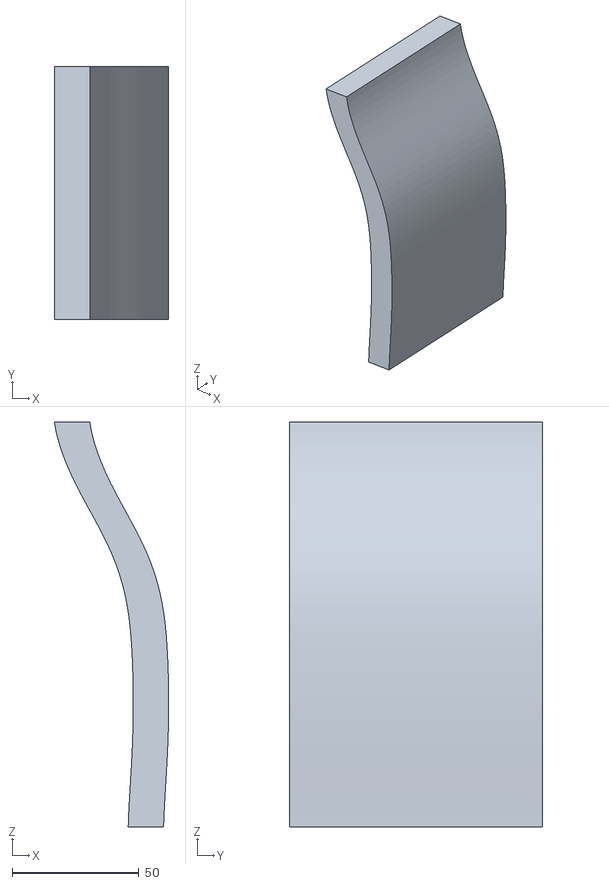
[picture p134: CAD file, 2026-11-02]
stl/concepts_study/C3/C3_column_pacf_R.stl
45.2 x 100.0 x 160.0
