Koede/robot-arm/stl/concepts_study/C4/C4_armour_keel_module_R.stl

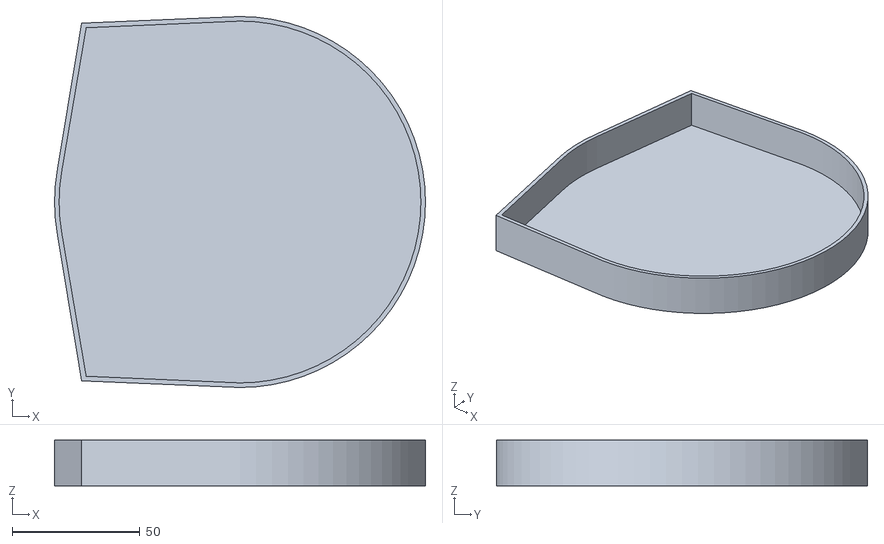
[picture p135: CAD file, 2026-11-02]
stl/concepts_study/C4/C4_armour_keel_module_R.stl
145.2 x 145.2 x 18.0
