Koede/robot-arm/stl/concepts_study/C5/C5_s1_base_block_short_R.stl

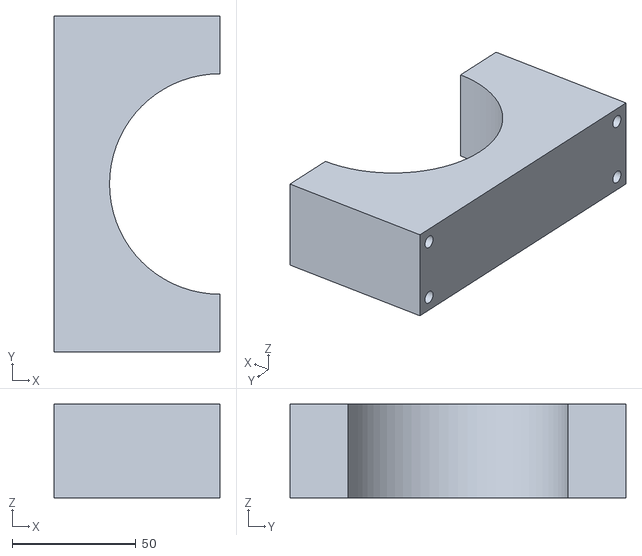
[picture p136: CAD file, 2026-11-02]
stl/concepts_study/C5/C5_s1_base_block_short_R.stl
67.0 x 136.0 x 38.0
