Koede/robot-arm/stl/concepts_study/J1/J1_S2_clamp_R.stl

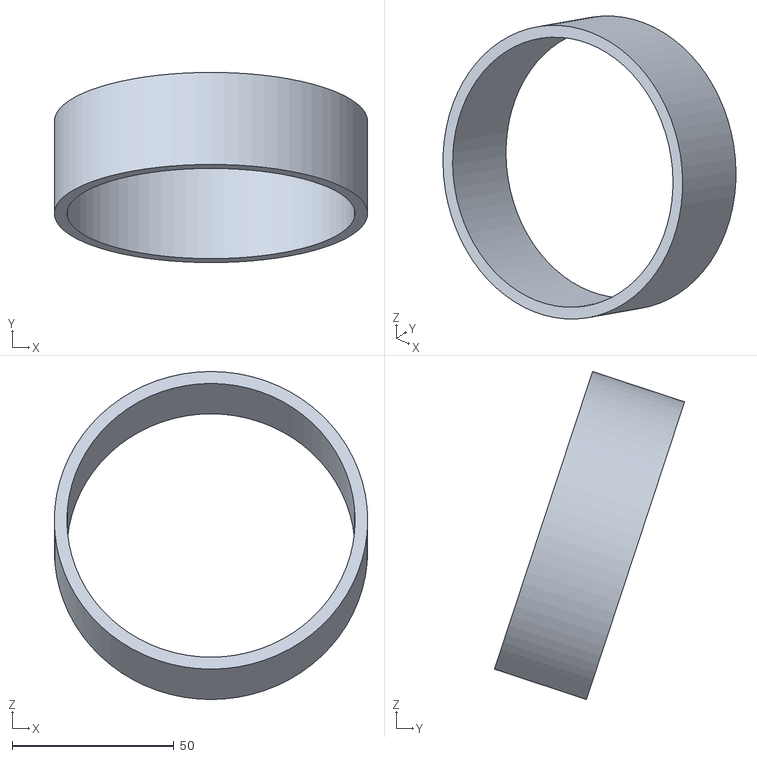
[picture p138: CAD file, 2026-11-02]
stl/concepts_study/J1/J1_S2_clamp_R.stl
97.0 x 58.9 x 101.5
