Koede/robot-arm/stl/concepts_study/J1R2/J1R2_dist_forearm_a_R.stl

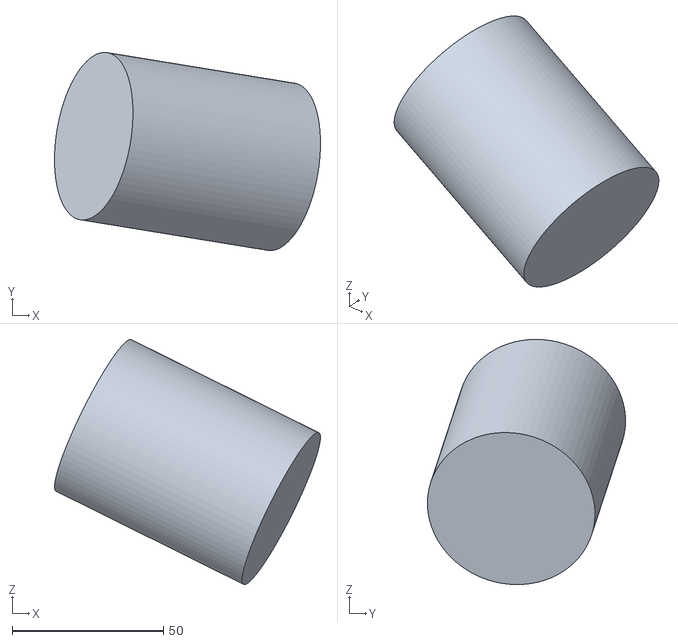
[picture p139: CAD file, 2026-11-02]
stl/concepts_study/J1R2/J1R2_dist_forearm_a_R.stl
88.0 x 65.5 x 81.1
