Koede/robot-arm/stl/concepts_study/J2/J2_S2_gearset_2to1_R.stl

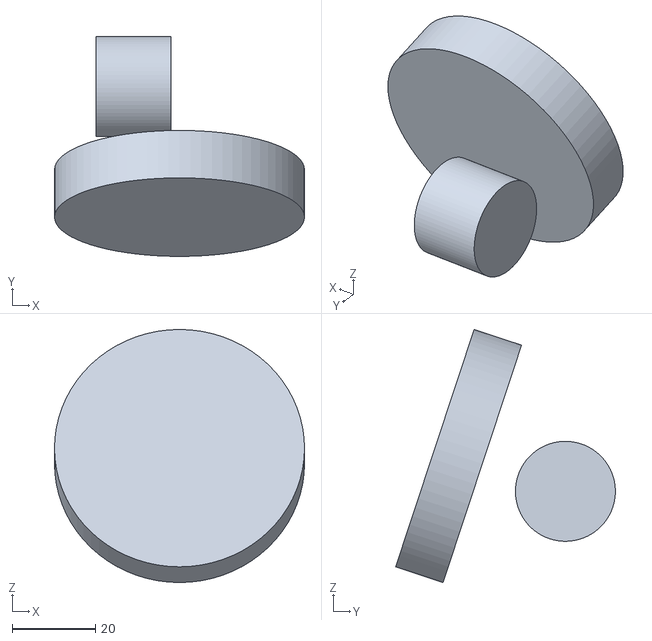
[picture p140: CAD file, 2026-11-02]
stl/concepts_study/J2/J2_S2_gearset_2to1_R.stl
60.0 x 52.7 x 60.7
