Koede/robot-arm/stl/concepts_study/J3/J3_belt_HTD5M_10mm_R.stl

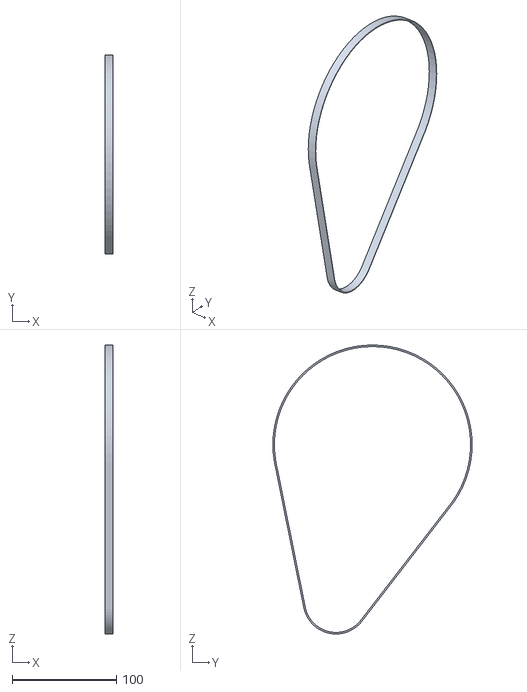
[picture p141: CAD file, 2026-11-02]
stl/concepts_study/J3/J3_belt_HTD5M_10mm_R.stl
8.00 x 191.0 x 277.0
