Koede/robot-arm/stl/concepts_study/J4/J4_s2_adapter_R.stl

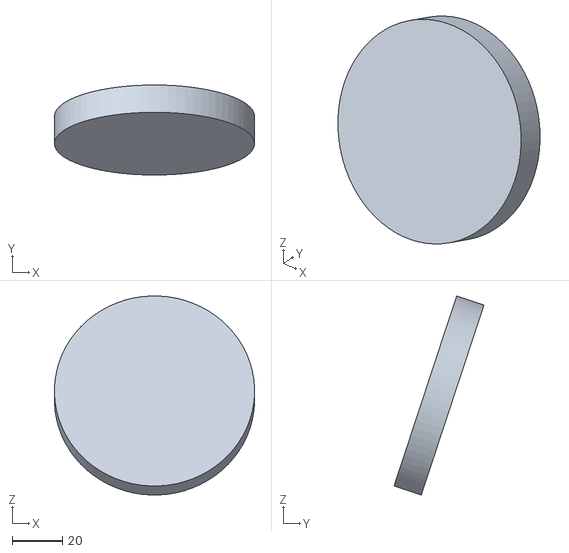
[picture p142: CAD file, 2026-11-02]
stl/concepts_study/J4/J4_s2_adapter_R.stl
79.9 x 36.0 x 79.5
