Koede/robot-arm/stl/concepts_study/J5/J5_s1_shaft_pulley_R.stl

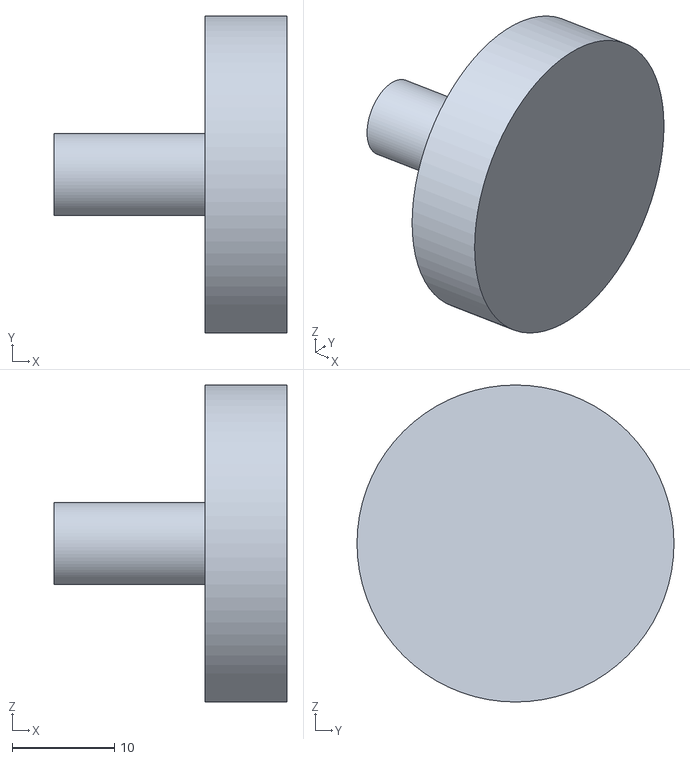
[picture p143: CAD file, 2026-11-02]
stl/concepts_study/J5/J5_s1_shaft_pulley_R.stl
22.8 x 31.0 x 31.0
