Koede/robot-arm/stl/concepts_study/REF/REF_armour_crown_R.stl

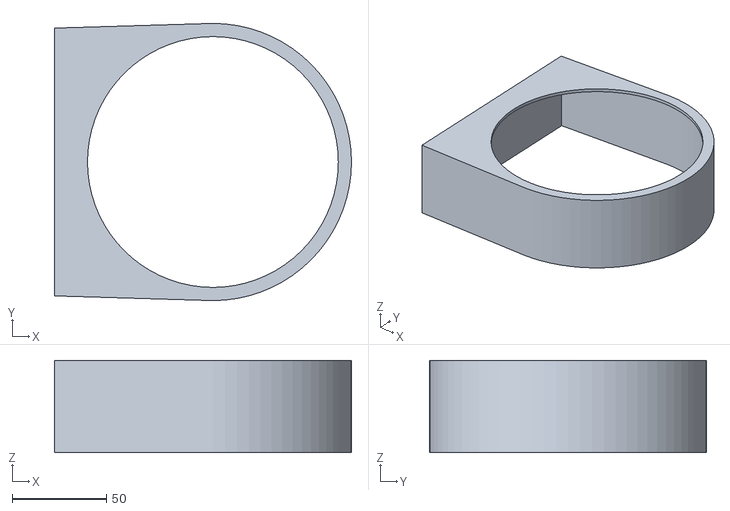
[picture p144: CAD file, 2026-11-02]
stl/concepts_study/REF/REF_armour_crown_R.stl
157.5 x 147.0 x 49.0
