Koede/robot-arm/stl/distal/claw/claw_ring.stl

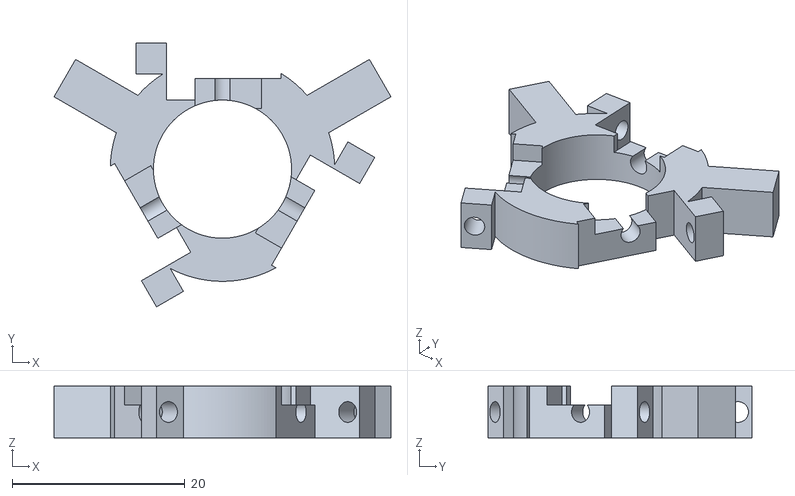
[picture p145: CAD file, 2026-10-23]
stl/distal/claw/claw_ring.stl
39.0 x 30.6 x 6.00
