Koede/robot-arm/stl/distal/claw/proxies/pin_J_F.stl

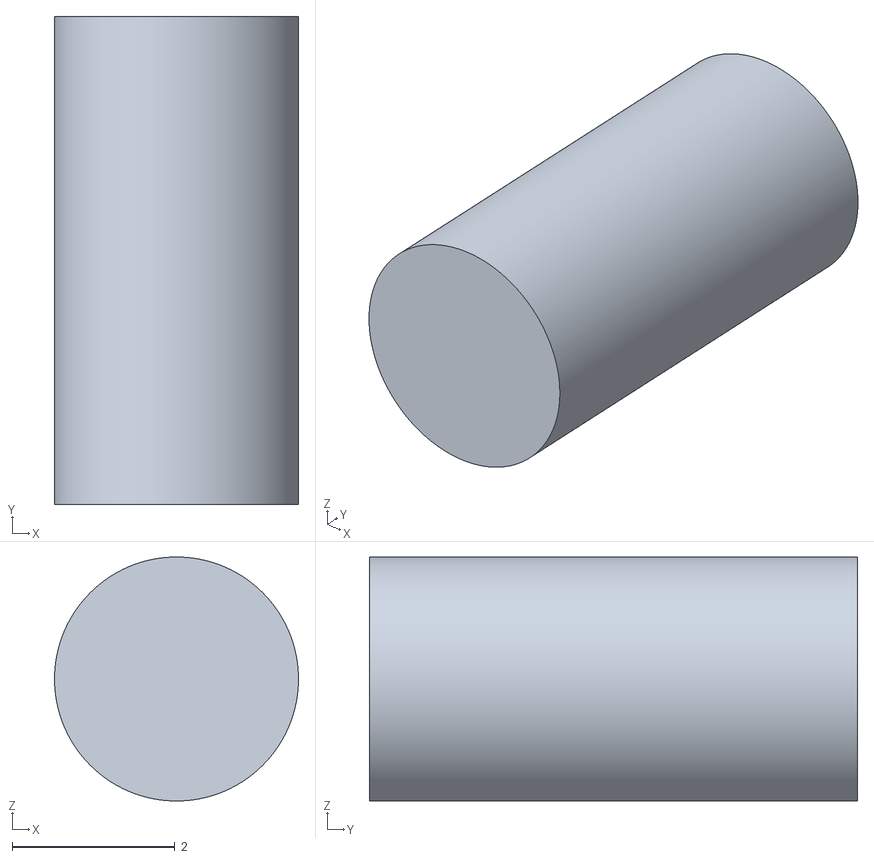
[picture p146: CAD file, 2026-10-23]
stl/distal/claw/proxies/pin_J_F.stl
3.00 x 6.00 x 3.00
