Koede/robot-arm/stl/distal/forearm_dist_R.stl

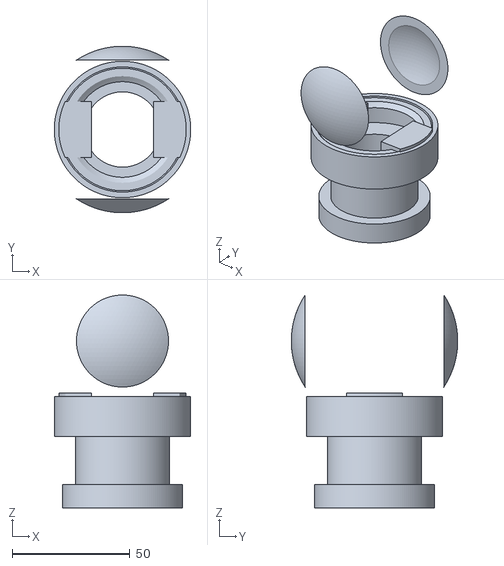
[picture p147: CAD file, 2026-10-23]
stl/distal/forearm_dist_R.stl
58.0 x 70.8 x 90.6
