Koede/robot-arm/stl/distal/stops_M2/s3_post_neg.stl

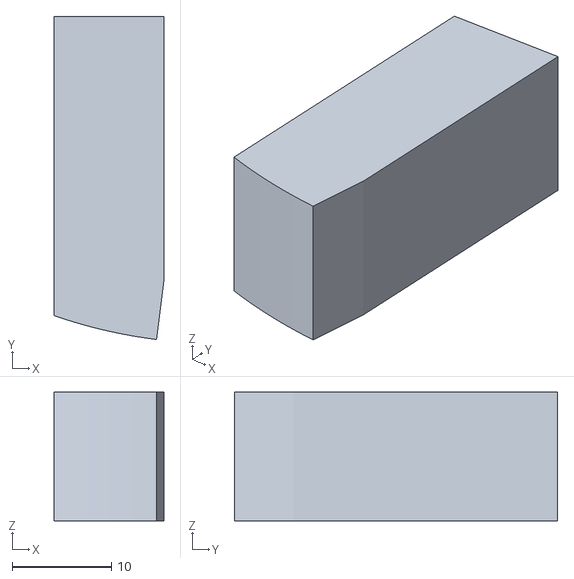
[picture p148: CAD file, 2026-10-23]
stl/distal/stops_M2/s3_post_neg.stl
11.1 x 32.6 x 13.0
