Koede/robot-arm/stl/distal/stops_M3/tpu_e_neg.stl

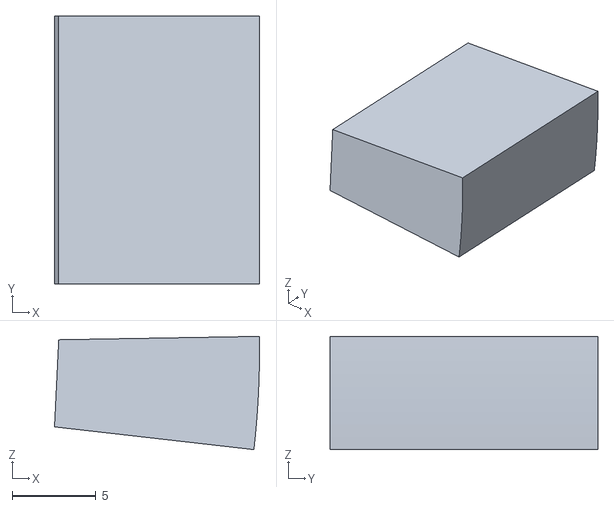
[picture p149: CAD file, 2026-10-23]
stl/distal/stops_M3/tpu_e_neg.stl
12.3 x 16.0 x 6.77
