Koede/robot-arm/stl/distal/stops_MW1/tpu_w2_neg.stl

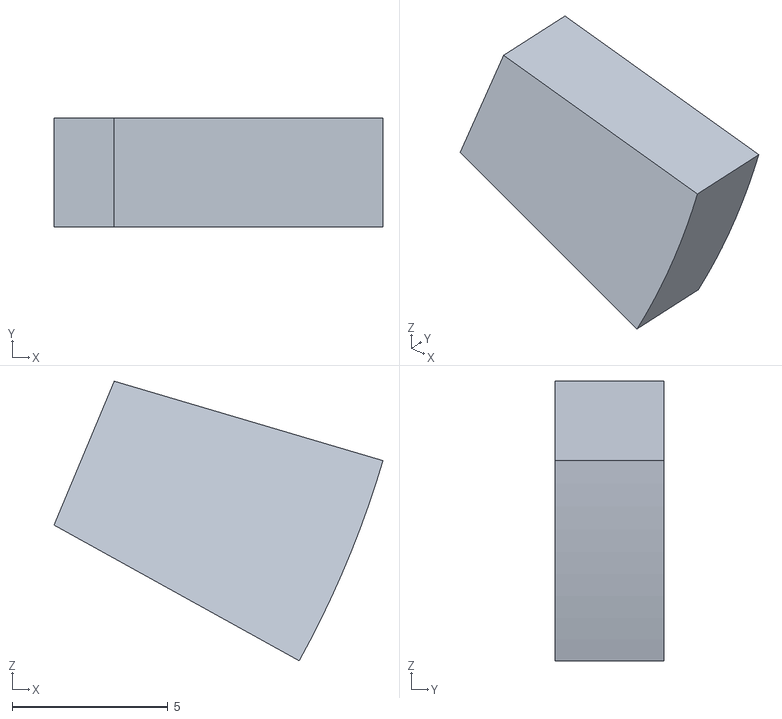
[picture p150: CAD file, 2026-10-23]
stl/distal/stops_MW1/tpu_w2_neg.stl
10.6 x 3.50 x 8.98
