Koede/robot-arm/stl/distal/stops_MW2/tpu_w3_pos.stl

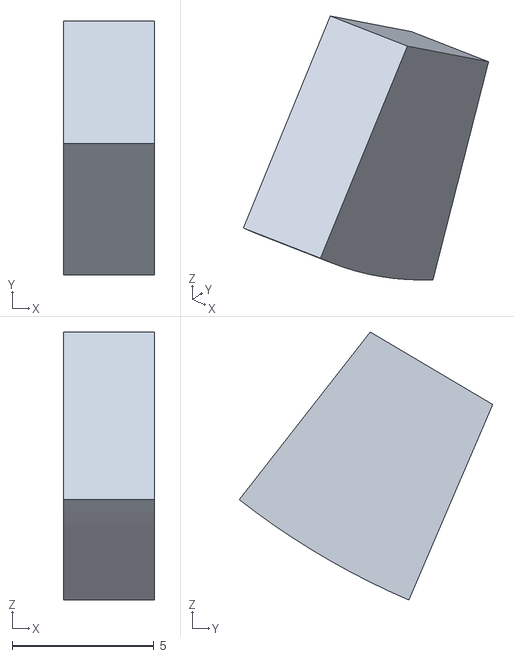
[picture p151: CAD file, 2026-10-23]
stl/distal/stops_MW2/tpu_w3_pos.stl
3.20 x 8.94 x 9.45
