Koede/robot-arm/stl/hand/middle_bar_pip.stl

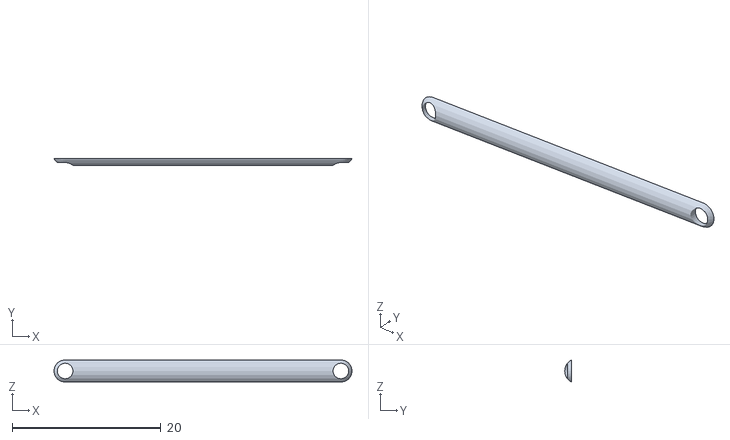
[picture p152: CAD file, 2026-10-31]
stl/hand/middle_bar_pip.stl
40.1 x 0.9 x 2.95
