Koede/robot-arm/stl/hand/poses/hand_chuck4_d13_posed.stl

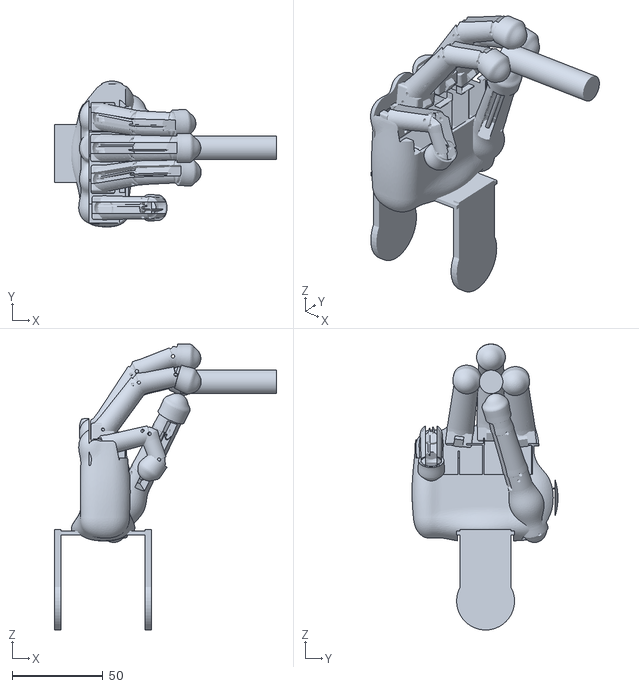
[picture p153: CAD file, 2026-10-31]
stl/hand/poses/hand_chuck4_d13_posed.stl
122.7 x 80.6 x 158.0
