Koede/robot-arm/stl/j1r2/S1_stop_collar_R.stl

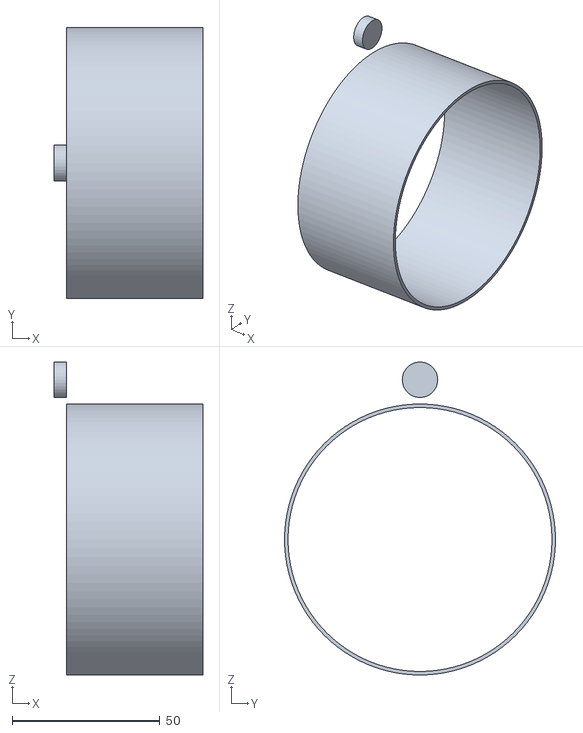
[picture p154: CAD file, 2026-11-02]
stl/j1r2/S1_stop_collar_R.stl
50.3 x 91.6 x 105.8
