Koede/robot-arm/stl/j1r2_bal/bal_spring_R.stl

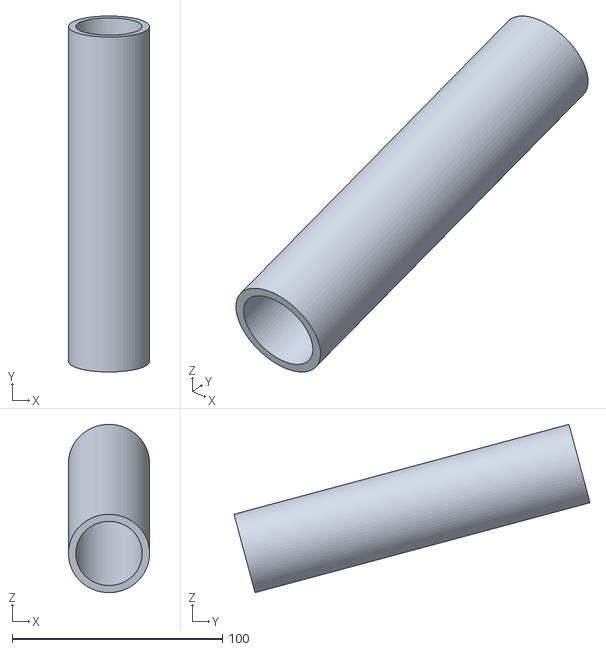
[picture p155: CAD file, 2026-11-02]
stl/j1r2_bal/bal_spring_R.stl
38.6 x 169.4 x 80.1
