Koede/robot-arm/stl/j1r2_kin/proxies/MW3_hand.stl

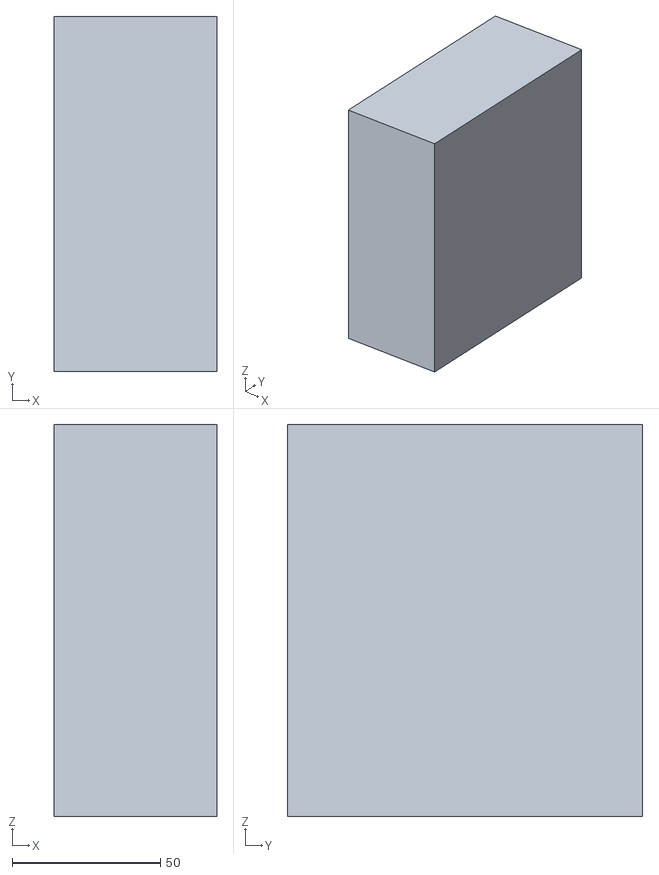
[picture p156: CAD file, 2026-11-02]
stl/j1r2_kin/proxies/MW3_hand.stl
55.0 x 120.0 x 132.4
