Koede/robot-arm/stl/j1r2_mounts/MJ1/MJ1_bal_liner_L.stl

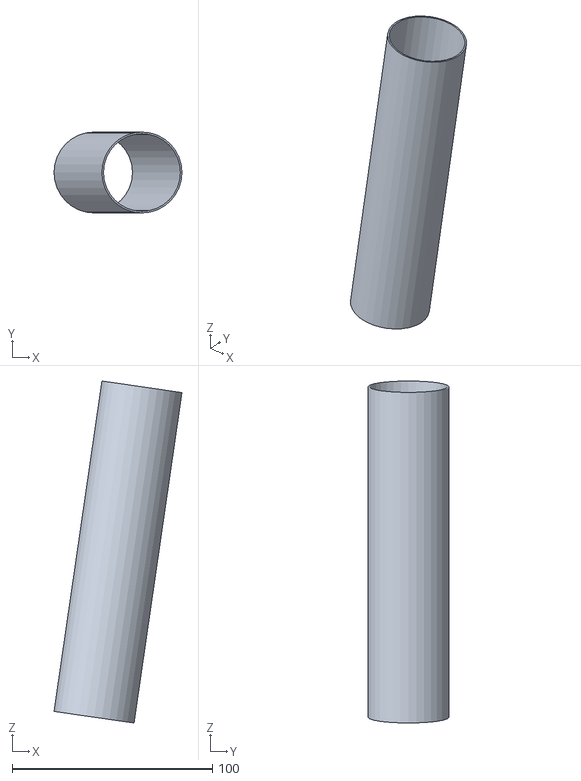
[picture p157: CAD file, 2026-11-02]
stl/j1r2_mounts/MJ1/MJ1_bal_liner_L.stl
63.9 x 40.4 x 170.8
