Koede/robot-arm/stl/j1r2_mounts/MJ10/MJ10_clasp_bracket_R.stl

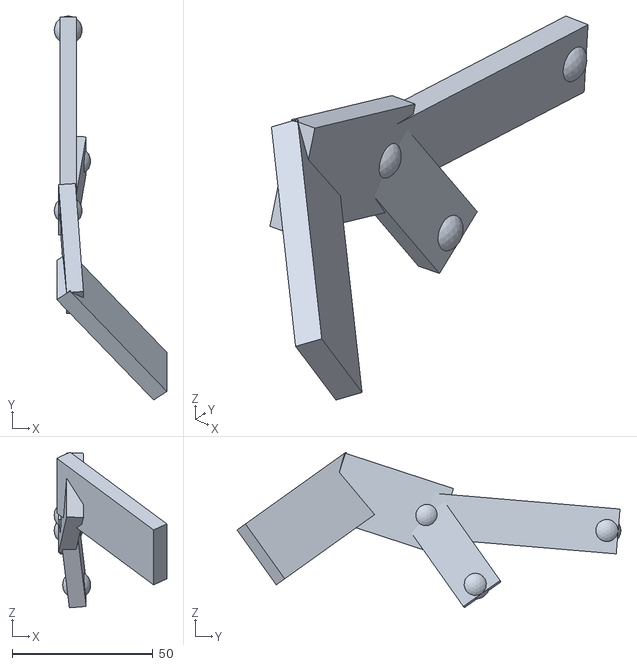
[picture p158: CAD file, 2026-11-02]
stl/j1r2_mounts/MJ10/MJ10_clasp_bracket_R.stl
40.1 x 136.5 x 55.3
