Koede/robot-arm/stl/j1r2_mounts/MJ11/MJ11_leadmodel_jack_block_R.stl

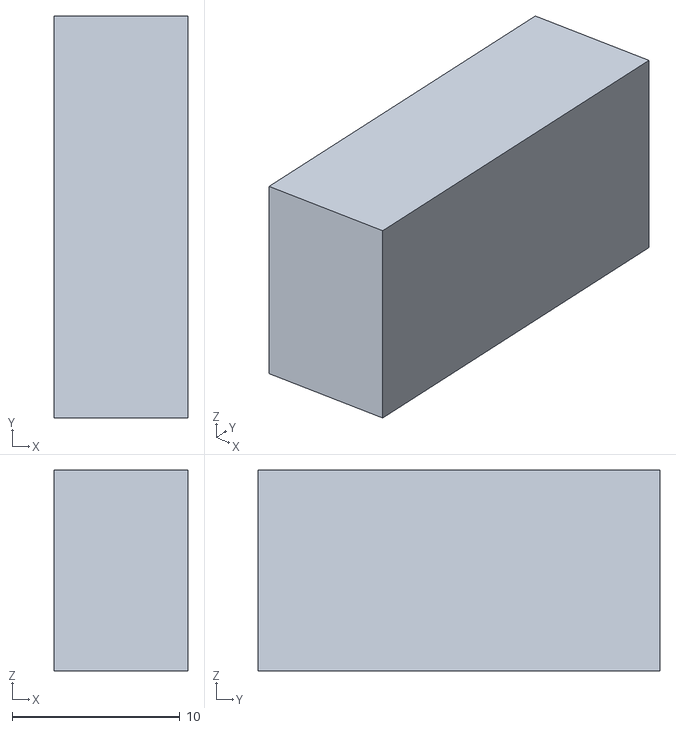
[picture p159: CAD file, 2026-11-03]
stl/j1r2_mounts/MJ11/MJ11_leadmodel_jack_block_R.stl
8.00 x 24.0 x 12.0
