Koede/robot-arm/stl/j1r2_mounts/MJ2/MJ2_pad_riser_L.stl

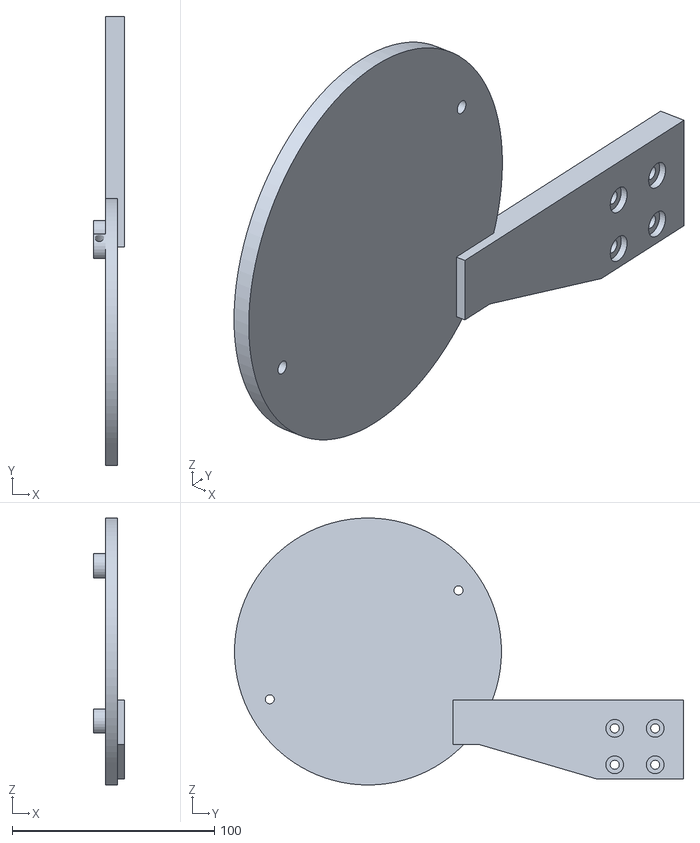
[picture p160: CAD file, 2026-11-02]
stl/j1r2_mounts/MJ2/MJ2_pad_riser_L.stl
15.5 x 222.0 x 132.0
