Koede/robot-arm/stl/j1r2_mounts/MJ8/MJ8_nodes_R.stl

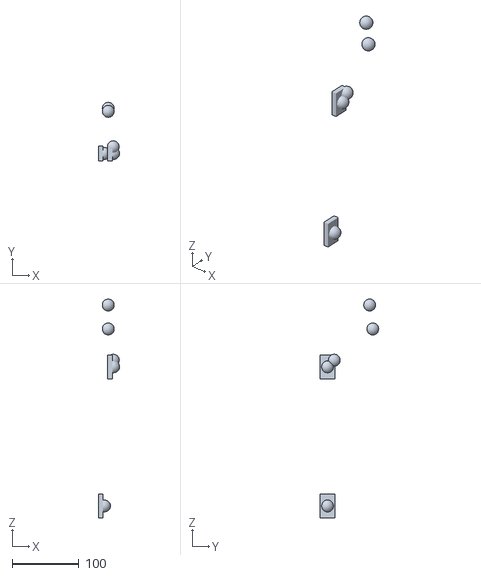
[picture p161: CAD file, 2026-11-02]
stl/j1r2_mounts/MJ8/MJ8_nodes_R.stl
31.9 x 87.6 x 327.4
