Koede/robot-arm/stl/shoulder/cowl/cowl_R.stl

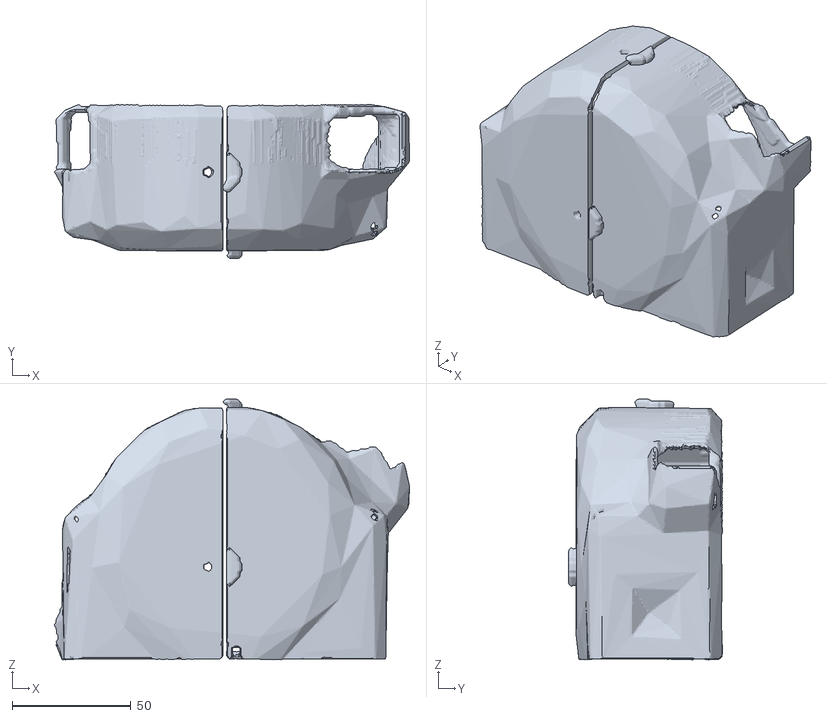
[picture p162: CAD file, 2026-10-23]
stl/shoulder/cowl/cowl_R.stl
149.7 x 65.0 x 110.1
