Koede/robot-arm/stl/shoulder/pauldron/pauldron_arm_med_R.stl

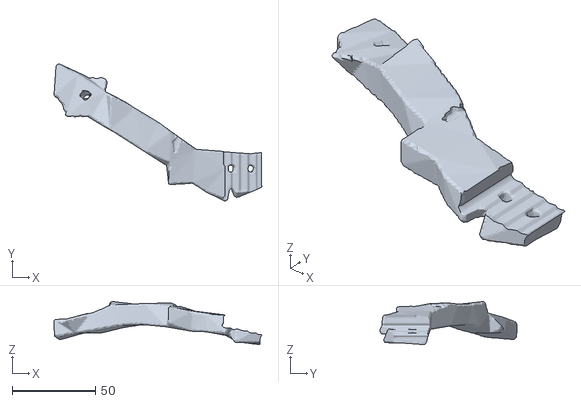
[picture p163: CAD file, 2026-10-23]
stl/shoulder/pauldron/pauldron_arm_med_R.stl
124.8 x 82.5 x 25.9
