Koede/robot-arm/stl/shoulder/proxies/wearer_makehuman.stl

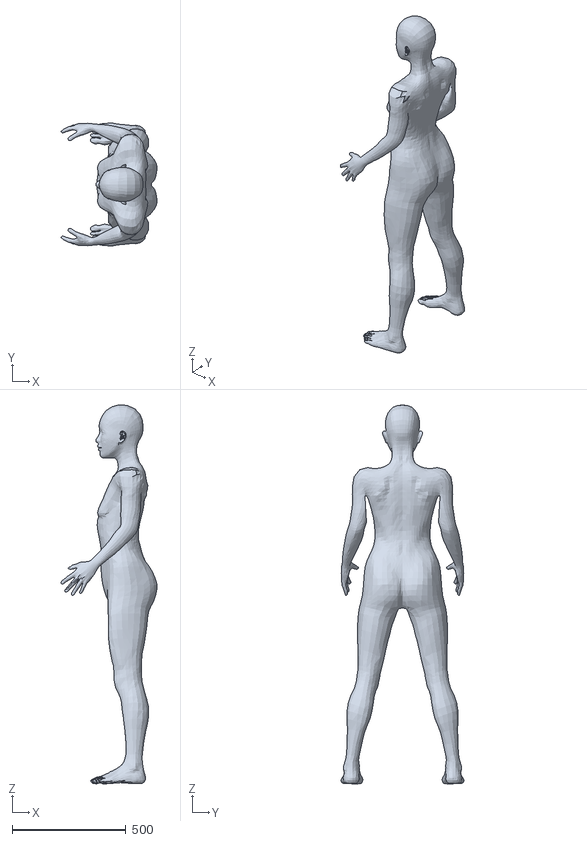
[picture p164: CAD file, 2026-10-23]
stl/shoulder/proxies/wearer_makehuman.stl
423.0 x 540.7 x 1665.9
