Koede/robot-arm/stl/shoulder/s1_clamp_R.stl

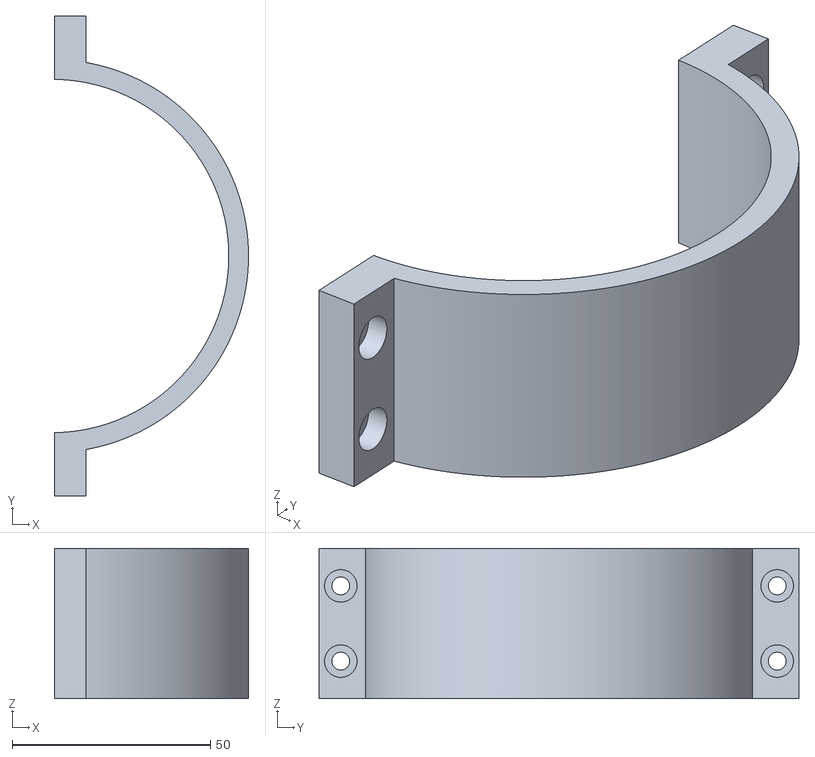
[picture p165: CAD file, 2026-10-23]
stl/shoulder/s1_clamp_R.stl
49.0 x 121.2 x 38.0
