Koede/robot-arm/stl/shoulder/scapular/wing_splice_R.stl

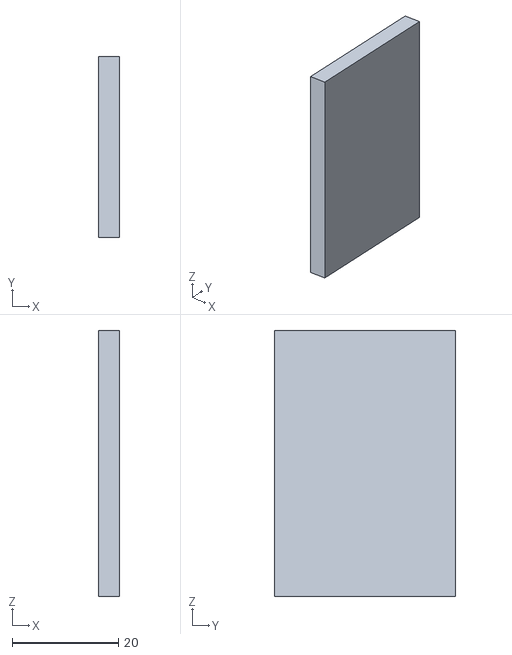
[picture p166: CAD file, 2026-10-23]
stl/shoulder/scapular/wing_splice_R.stl
4.00 x 34.0 x 50.0
