Koede/robot-arm/stl/shoulder/skirts/tpu_skirt_F4_R.stl

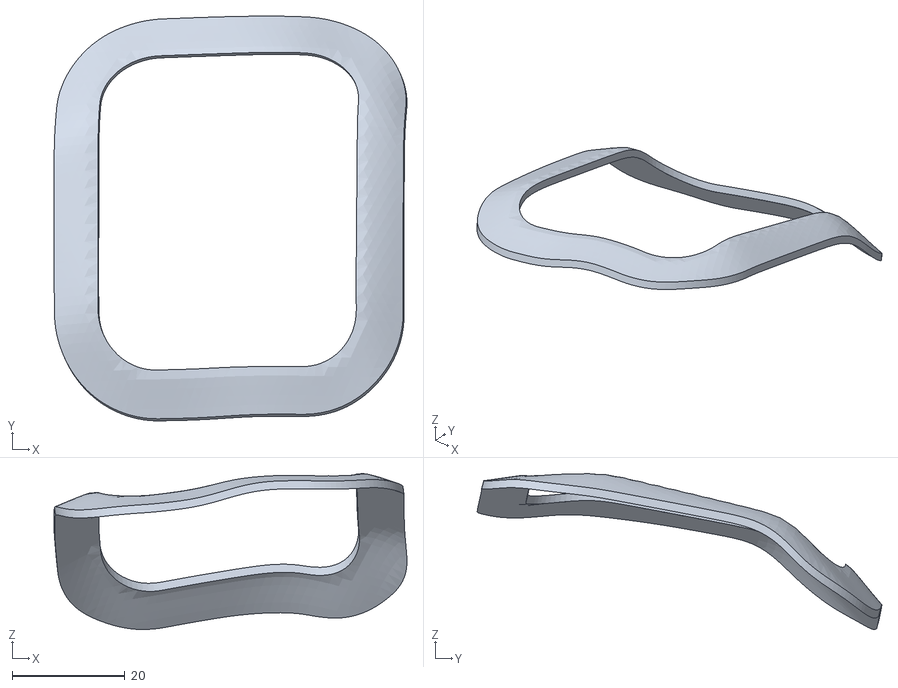
[picture p167: CAD file, 2026-10-23]
stl/shoulder/skirts/tpu_skirt_F4_R.stl
62.8 x 72.0 x 27.7
