Koede/robot-arm/stl/upperarm/fork_bridge_R.stl

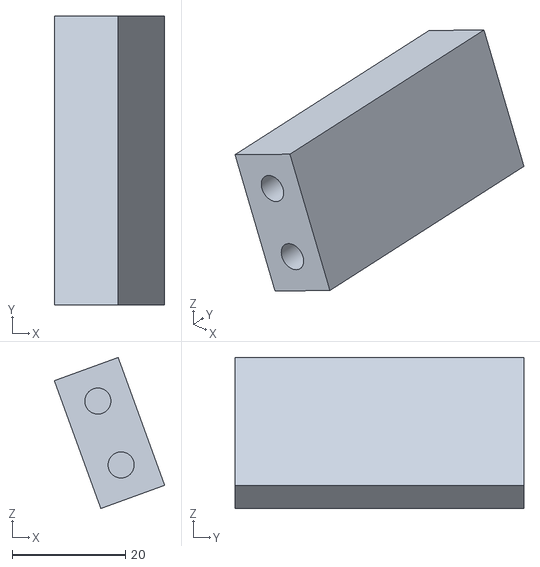
[picture p168: CAD file, 2026-10-23]
stl/upperarm/fork_bridge_R.stl
19.5 x 51.0 x 26.7
