Koede/robot-arm/(list of files, cad)

Other CAD files:
stl/upperarm/proxies/xm_elbow.stl
stl/concepts_study/J2/J2_S3_XM540_R.stl
stl/distal/stops_MW3/w3_lug_b.stl
stl/hand/proxies/servo_index.stl
stl/j1r2_mounts/MJ11/MJ11_fairing_R.stl
stl/j1r2_mounts/MJ5/MJ5_cam_lever_L.stl
stl/j1r2_mounts/MJ7/MJ7_rungs_L.stl
stl/j1r2_mounts/MJ8/MJ8_tubes_R.stl
stl/concepts_study/J6/J6_side_shaft_B_R.stl
stl/distal/proxies/sts_w2_R.stl
stl/distal/stops_ME/w1_post_pos.stl
stl/hand/proxies/servo_ring.stl
stl/j1r2_mounts/MJ4/MJ4_nodes_L.stl
stl/j1r2_mounts/MJ5/MJ5_clasp_bracket_L.stl
stl/j1r2_mounts/MJ6/MJ6_clasp_bracket_L.stl
stl/j1r2_mounts/MJ7/MJ7_posts_R.stl
stl/shoulder/stops/s1_post_a_R.stl
stl/balancer/bal_anchor_R.stl
stl/balancer/bal_collar_R.stl
stl/balancer/bal_collar_cap_R.stl
stl/balancer/bal_pin_proxy_R.stl
stl/balancer/bal_piston_R.stl
stl/balancer/bal_sheave_R.stl
stl/balancer/bal_swivel_R.stl
stl/balancer/s1s2_yoke_bal_R.stl
stl/balancer/s2_pad_neg_bal_R.stl
stl/balancer/s2_pad_pos_bal_R.stl
stl/balancer/spring_proxy_R.stl
stl/balancer/tpu_bal_buffer_R.stl
stl/balancer/tpu_s2_neg_bump_solid_R.stl
stl/balancer/tpu_s2_pos_bump_R.stl
stl/concepts_study/C1/C1_armour_keel_R.stl
stl/concepts_study/C2/C2_seat_pad_F1_R.stl
stl/concepts_study/C2/C2_seat_pad_F4_R.stl
stl/concepts_study/C3/C3_beam_al_seat_plate_R.stl
stl/concepts_study/C3/C3_beam_pacf_channel_R.stl
stl/concepts_study/C3/C3_column_al_bar0_R.stl
stl/concepts_study/C3/C3_column_al_bar1_R.stl
stl/concepts_study/C4/C4_connector_receptacle_PLACEHOLDER_R.stl
stl/concepts_study/C4/C4_dock_ring_receptacle_R.stl
stl/concepts_study/C4/C4_latch_indicator_R.stl
stl/concepts_study/C4/C4_latch_plunger_safety_PLACEHOLDER_R.stl
stl/concepts_study/C4/C4_module_adapter_spigot_R.stl
stl/concepts_study/C4/C4_plate_6061_R.stl
stl/concepts_study/C4/C4_s1_base_block_dockside_R.stl
stl/concepts_study/C4/C4_steel_pins_x4_PLACEHOLDER_R.stl
stl/concepts_study/C5/C5_adapter_strips_x2_R.stl
stl/concepts_study/C5/C5_armour_crown_R.stl
stl/concepts_study/C5/C5_armour_keel_R.stl
stl/concepts_study/C5/C5_armour_spaulder_R.stl
stl/concepts_study/C5/C5_gaiter_TPU_R.stl
stl/concepts_study/C5/C5_shim_packs_8mm_x2_R.stl
stl/concepts_study/C5/C5_wedge_m5_spare_R.stl
stl/concepts_study/C5/C5_wedge_p5_spare_R.stl
stl/concepts_study/C6/C6_plate_6061_R.stl
stl/concepts_study/J1/J1_S1_AK70_R.stl
stl/concepts_study/J1/J1_S1_stop_posts_R.stl
stl/concepts_study/J1/J1_S1_yoke_R.stl
stl/concepts_study/J1/J1_S2_adapter_R.stl
stl/concepts_study/J1/J1_S2_stop_lug_R.stl
stl/concepts_study/J1/J1_S2_stop_posts_R.stl
stl/concepts_study/J1/J1_S3_XM540_R.stl
stl/concepts_study/J1/J1_arm_elbow_ball_R.stl
stl/concepts_study/J1/J1_arm_tube_R.stl
stl/concepts_study/J1/J1_base_pad_R.stl
stl/concepts_study/J1/J1_fairing_S1_ring_R.stl
stl/concepts_study/J1/J1_fairing_S2_sleeve_R.stl
stl/concepts_study/J1R2/J1R2_S1_AK70_R.stl
stl/concepts_study/J1R2/J1R2_S1_stop_collar_R.stl
stl/concepts_study/J1R2/J1R2_S1_stop_posts_R.stl
stl/concepts_study/J1R2/J1R2_S1_yoke_R.stl
stl/concepts_study/J1R2/J1R2_S2_AK70_R.stl
stl/concepts_study/J1R2/J1R2_S2_adapter_R.stl
stl/concepts_study/J1R2/J1R2_S2_clamp_R.stl
stl/concepts_study/J1R2/J1R2_S2_sleeve_R.stl
stl/concepts_study/J1R2/J1R2_S2_stop_lug_R.stl
stl/concepts_study/J1R2/J1R2_S2_stop_posts_R.stl
stl/concepts_study/J1R2/J1R2_S3_XM540_R.stl
stl/concepts_study/J1R2/J1R2_S3_bracket_R.stl
stl/concepts_study/J1R2/J1R2_arm_elbow_ball_R.stl
stl/concepts_study/J1R2/J1R2_arm_tube_R.stl
stl/concepts_study/J1R2/J1R2_cable_F_R.stl
stl/concepts_study/J1R2/J1R2_cable_F_run_R.stl
stl/concepts_study/J1R2/J1R2_cable_M2_R.stl
stl/concepts_study/J1R2/J1R2_cable_coil_R.stl
stl/concepts_study/J1R2/J1R2_column_anchor_R.stl
stl/concepts_study/J1R2/J1R2_dist_elbow_bridge_R.stl
stl/concepts_study/J1R2/J1R2_dist_forearm_b_R.stl
stl/concepts_study/J1R2/J1R2_dist_hand_R.stl
stl/concepts_study/J1R2/J1R2_dist_w2_yoke_R.stl
stl/concepts_study/J1R2/J1R2_fairing_fixed_R.stl
stl/concepts_study/J1R2/J1R2_pad_riser_R.stl
stl/concepts_study/J1R2/J1R2_rail_R.stl
stl/concepts_study/J1R2/J1R2_standoffs_R.stl
stl/concepts_study/J1R2/J1R2_tpu_S1_bumpers_R.stl
stl/concepts_study/J1R2/J1R2_tpu_S2_bumpers_R.stl
stl/concepts_study/J2/J2_S1_AK70_R.stl
stl/concepts_study/J2/J2_S1_belt_pulley_R.stl
stl/concepts_study/J2/J2_S2_AK70_R.stl
stl/concepts_study/J2/J2_S2_bevel_housing_R.stl
stl/concepts_study/J2/J2_S3_bracket_R.stl
stl/concepts_study/J2/J2_carrier_link_R.stl
stl/concepts_study/J2/J2_elbow_ball_R.stl
stl/concepts_study/J2/J2_fairing_R.stl
stl/concepts_study/J2/J2_plate_R.stl
stl/concepts_study/J2/J2_upper_arm_R.stl
stl/concepts_study/J3/J3_S1_carrier_plate_clamp_R.stl
stl/concepts_study/J3/J3_S1_motor_boss_R.stl
stl/concepts_study/J3/J3_S1_pulley_r30_R.stl
stl/concepts_study/J3/J3_S2_adapter_bracket_S3_sleeve_R.stl
stl/concepts_study/J3/J3_ak70_S1_R.stl
stl/concepts_study/J3/J3_ak70_S2_R.stl
stl/concepts_study/J3/J3_balls_d4_x40_R.stl
stl/concepts_study/J3/J3_base_plate_lower_tab_R.stl
stl/concepts_study/J3/J3_base_plate_upper_R.stl
stl/concepts_study/J3/J3_cowl_rotating_R.stl
stl/concepts_study/J3/J3_ring_cover_rotating_R.stl
stl/concepts_study/J3/J3_ring_inner_race_pulley_R.stl
stl/concepts_study/J3/J3_ring_outer_race_fixed_R.stl
stl/concepts_study/J3/J3_skirt_fixed_R.stl
stl/concepts_study/J3/J3_stop_lug_carrier_R.stl
stl/concepts_study/J3/J3_stop_posts_fixed_R.stl
stl/concepts_study/J4/J4_S1_flange_clamp_R.stl
stl/concepts_study/J4/J4_S2_clamp_R.stl
stl/concepts_study/J4/J4_ak70_S1_R.stl
stl/concepts_study/J4/J4_ak70_S2_R.stl
stl/concepts_study/J4/J4_elbow_ball_R.stl
stl/concepts_study/J4/J4_fairing_S2_R.stl
stl/concepts_study/J4/J4_fairing_link_R.stl
stl/concepts_study/J4/J4_link_plate_R.stl
stl/concepts_study/J4/J4_upper_arm_R.stl
stl/concepts_study/J5/J5_ak70_S1_R.stl
stl/concepts_study/J5/J5_bearing_arc_fixed_R.stl
stl/concepts_study/J5/J5_belt_S1_R.stl
stl/concepts_study/J5/J5_fairing_lower_R.stl
stl/concepts_study/J5/J5_hoop_S2_R.stl
stl/concepts_study/J5/J5_plate_6061_R.stl
stl/concepts_study/J5/J5_ring_S1_R.stl
stl/concepts_study/J5/J5_standoff1_R.stl
stl/concepts_study/J5/J5_support_rib_R.stl
stl/concepts_study/J5/J5_upper_arm_R.stl
stl/concepts_study/J5/J5_xm540_S3_R.stl
stl/concepts_study/J6/J6_ak70_A_R.stl
stl/concepts_study/J6/J6_ak70_B_R.stl
stl/concepts_study/J6/J6_cage_plates_R.stl
stl/concepts_study/J6/J6_elbow_ball_R.stl
stl/concepts_study/J6/J6_fairing_R.stl
stl/concepts_study/J6/J6_gear_in_A_R.stl
stl/concepts_study/J6/J6_gear_in_B_R.stl
stl/concepts_study/J6/J6_hub_boom_R.stl
stl/concepts_study/J6/J6_motor_pinion_A_R.stl
stl/concepts_study/J6/J6_motor_pinion_B_R.stl
stl/concepts_study/J6/J6_motor_saddle_R.stl
stl/concepts_study/J6/J6_side_gear_A_R.stl
stl/concepts_study/J6/J6_side_gear_B_R.stl
stl/concepts_study/J6/J6_upper_arm_R.stl
stl/concepts_study/J6/J6_xm540_S3_R.stl
stl/concepts_study/REF/REF_plate_6061_R.stl
stl/distal/claw/claw_rotor.stl
stl/distal/claw/hand_tray.stl
stl/distal/claw/link_couple_F.stl
stl/distal/claw/link_drive_F.stl
stl/distal/claw/proxies/horn_disc.stl
stl/distal/claw/proxies/pin_P_F.stl
stl/distal/claw/proxies/pin_Q_F.stl
stl/distal/claw/proxies/pin_lug_F.stl
stl/distal/claw/proxies/pin_pivot_F.stl
stl/distal/claw/proxies/pin_ring0.stl
stl/distal/claw/proxies/pin_ring2.stl
stl/distal/claw/proxies/scr_cap0.stl
stl/distal/claw/proxies/scr_cap1.stl
stl/distal/claw/proxies/scr_cap2.stl
stl/distal/claw/proxies/scr_cap3.stl
stl/distal/claw/proxies/scr_ear0.stl
stl/distal/claw/proxies/scr_ear1.stl
stl/distal/claw/proxies/scr_tab0.stl
stl/distal/claw/proxies/scr_tab1.stl
stl/distal/claw/proxies/sts_g.stl
stl/distal/claw/servo_tab.stl
stl/distal/claw/stop_cap.stl
stl/distal/claw/tpu_pad_F.stl
stl/distal/forearm_root_b_R.stl
stl/distal/proxies/sts_w3_R.stl
stl/distal/stops_M2/tpu_s3_pos.stl
stl/distal/stops_M3/e_post_pos.stl
stl/distal/stops_M3/tpu_e_pos.stl
stl/distal/stops_ME/tpu_w1_neg.stl
stl/distal/stops_MW1/w1_lug.stl
stl/distal/stops_MW1/w2_post_neg.stl
stl/distal/stops_MW2/w3_post_neg.stl
stl/distal/w2_yoke_R.stl
stl/hand/index_bar_dip.stl
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
