Koede/robot-arm/stl/j1r2/ASSEMBLY_j1r2.md

J1 rev 2b assembly (right arm; left = mirror), tools: 2.5 / 3 / 4 mm hex.
1. Press M4 heat-set inserts (5.6 x 4.5) into the 4 rail bosses, M3 inserts (4.6 x 5.7) into the 2 pad front-rim bosses, M4 inserts (5.6 x 4) into the S1 post feet. Seat the 4 standoffs on the rail bosses.
2. Offer the pad_riser (pad + hollow beam) from the +x side: 4 x ISO 7380 M4 from the rear counterbores (D8.8 x 2.4) through the beam posts and standoffs into the rail inserts (lengths per interfaces / fasteners list). Fit the lap skirt (fairing_lap) over the standoff cavity from the body side before the last bolt.
3. Bolt the S1 stop posts to the pad from the pad FRONT (ISO 10642 M4 x 10) and bond the TPU 95A bumpers.
4. Lay the cable_F bundle in the plane x = -94 (trunk exit E0 on the rail side), feed it through the grommeted D13 gland in the cup wall BEFORE the cup is fitted, clamp it on the hollow column; thread the 8 conductors inside the column to the coil clamp.
5. Fix the AK70 (S1') to the pad rear face (6 x M4, PLACEHOLDER pattern). Fit the S1_stop_collar to the yoke disc, then the S1_yoke on the AK70 output (6 x M4 PLACEHOLDER), the ribbon coil under the disc rear face.
6. Slide the fixed fairing cup on from +x over the yoke (the swept cut passes the bar), fix with 2 radial M3 x 10; close the grommet.
7. Mount the S2 AK70 in the clamp on the bar, fit the sleeve, S2 posts + bumpers, adapter, S3 bracket (cable notch toward -y), XM540; wrap the M2 ribbon around the sleeve (100 deg) before closing the cradle; route it through the notch.
8. Dry-move S1' hard stop to hard stop and S2 hard stop to hard stop by hand with motors off; check the ring, the coil and the M2 wrap.
