Koede/robot-arm/cad/j1r2/j1r2_sweep.py

"""J1 rev 2 collision-sweep engine (project method, specs/SPEC_collision_method.md).  Robot frame, mm, deg.

    from j1r2_sweep import Scene, run_sweep, local_opt_hints, swept_volume, cut_by_sweep, make_wearer_parts

Scene  : fixed {name: Trimesh}, wearer parts (skin 2 mm, head 60 mm), moving GROUPS {name: dict(mesh, joints=[upstream chain, ordered])},
         joints [ordered names], pose_fn(group, q:dict deg) -> 4x4 world transform of the group mesh (mesh given in its REFERENCE frame),
         park {joint: deg}, soft {joint:(lo,hi)}, hard {joint:(lo,hi)}, exclude set of "group|object" keys.
Method : pair tables over ONLY the joints between the two bodies (upstream joints cancel; bodies vs fixed/wearer use all upstream joints),
         FCL BVH mesh distance (exact mesh-mesh) with a certified bounding-sphere lower bound to skip far poses, union contact mask on the full
         joint grid, flood fill from the park pose (reachable free region), frontier = contact cells touching it (deep ones dropped),
         sub-grid first-contact angles by linear zero crossing of d-MM on every free->contact edge, certified sphere tracing
         (dq=(d-MM)/sum r_j|dq_j|) as the fast path, validated against the per-pair grid reference.
Gates  : MM part-part 3, skin 2, head/neck 60 mm; d < 1 mm = FAIL (collision), 1..MM = BELOW_GATE."""
import os, sys, json, time, itertools, math
import numpy as np, trimesh, fcl
from scipy import ndimage as ndi
from concurrent.futures import ProcessPoolExecutor
sys.path.insert(0, os.path.dirname(os.path.abspath(__file__)))
import clib as L
OUT = os.path.join(L.ROOT, "stl", "j1r2_sweep"); os.makedirs(OUT, exist_ok=True)
MM_DEFAULT = dict(part=3.0, skin=2.0, head=60.0)
FAR = 150.0                                              # distances above this are only bounded (lower bound used), never queried
# ------------------------------------------------------------------------------------------------ scene
class Scene:
    def __init__(s, fixed, groups, joints, pose_fn, park, soft, hard=None, wearer=None, exclude=(), MM=None, name="scene"):
        s.fixed = dict(fixed); s.groups = groups; s.joints = list(joints); s.pose_fn = pose_fn; s.park = dict(park); s.soft = dict(soft)
        s.hard = dict(hard) if hard else {j: (a - 5, b + 5) for j, (a, b) in soft.items()}; s.wearer = wearer or {}; s.exclude = set(exclude)
        s.MM = dict(MM_DEFAULT); s.MM.update(MM or {}); s.name = name
    def objects(s):
        """fixed object table: name -> (mesh, kind)"""
        o = {k: (m, "part") for k, m in s.fixed.items()}
        for k, m in s.wearer.items(): o["wearer_" + k] = (m, "skin" if k == "skin" else "head")
        return o
def make_wearer_parts(center=(-110.0, -40.0, -90.0), radius=520.0, target_faces=14000):
    """crop clib.body() to the region the arm can reach and split off the head/neck keep-out (faces above z -70 near the spine plane y -150, x < -90)."""
    import fast_simplification as fs
    b = L.body(); C = np.asarray(center); keep = np.linalg.norm(b.triangles_center - C, axis=1) < radius
    sub = b.submesh([np.where(keep)[0]], append=True)
    v, f = (np.asarray(sub.vertices, np.float64), np.asarray(sub.faces, np.int32)) if len(sub.faces) <= target_faces else fs.simplify(np.asarray(sub.vertices, np.float64), np.asarray(sub.faces, np.int32), target_count=target_faces)
    skin = trimesh.Trimesh(v, f, process=False)
    tc = skin.triangles_center; hs = (tc[:, 2] > -70) & (np.abs(tc[:, 1] + 150) < 120) & (tc[:, 0] < -90)
    head = skin.submesh([np.where(hs)[0]], append=True)
    return dict(skin=skin, head=head)
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
