Koede/robot-arm/cad/j1r2/joint_j1.py

"""J1 "Back-normal S1 pancake + side-hung S2".  S1' = AK70 flat on the back, axis along +x (back normal), output yoke turns in the back plane.
S2 axis lies in the back plane (direction s = Rx(th1) y), its AK70 hangs LATERALLY of the S1 motor (clears the S1 disc), the arm (S3 along the arm) leaves its flange.
Kinematics: th1 about +x, arm rest direction a = Rx(th1) z = (0,-sin th1, cos th1); S2 swings the arm toward -x:  d = a cos(phi) - xhat sin(phi)."""
import sys, os; sys.path.insert(0, os.path.dirname(os.path.abspath(__file__)))
import numpy as np, clib as L
from clib import *
g = 9.81
# ---------------------------------------------------------------- kinematics / coverage
def dirJ1(th1, phi):
    t, p = np.radians(th1), np.radians(phi); return np.array([-np.sin(p), -np.sin(t) * np.cos(p), np.cos(t) * np.cos(p)])
TH = (-95.0, 35.0); PH = (-30.0, 88.0)                                    # soft ranges of S1', S2
dirs = np.array([dirJ1(a, b) for a in np.arange(TH[0], TH[1] + .1, 1.0) for b in np.arange(PH[0], PH[1] + .1, 1.0)])
cov = L.coverage(dirs, 3.0)
B = L.baseline_dir_set(); from scipy.spatial import cKDTree
dd, _ = cKDTree(dirs).query(B); miss = B[dd > 2 * np.sin(np.radians(3) / 2)]
# park-equivalent pose
dp = L.baseline_dir(45, 25); phi_p = float(np.degrees(np.arcsin(-dp[0]))); th_p = float(np.degrees(np.arctan2(-dp[1], dp[2])))
assert np.allclose(dirJ1(th_p, phi_p), dp, atol=1e-6)
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
