Koede/robot-arm/(commit log)

2026-10-23 Replace the pauldron's flat lateral shelf with a curved deltoid shell.
    The socket cap used to be cut flat and the lateral arm ran out to y = 98 as a rectangular ribbon. That shelf is now a swept arc: the crown sits 12 mm off the deltoid and the rims curl inboard, while the bore, plate feet, and acromion pad still mount.
    [pauldron.py]
2026-10-23 Add the Third Shoulder arm, harness, and local build outputs.
    Unpacks the CAD scripts, body mesh, and right-arm parts, then keeps the wearer, harness, and SDF cache rebuilt on this machine. The pauldron script is intentionally not in this commit so the curved deltoid shell can merge cleanly.
    [ak_s1_body.stl, ak_s2_body.stl, bal_anchor_R.stl, bal_collar_R.stl, bal_collar_cap_R.stl, bal_pin_proxy_R.stl, bal_piston_R.stl, bal_sheave_R.stl]
2026-10-23 Regenerate the pauldron meshes from the curved deltoid shell.
    The swept shell crowns 12 mm off the deltoid and the outer rim lands at y = 85.5. Core, lateral splice, and medial arm are watertight and fit a 256 mm build volume.
    [pauldron_R.stl, pauldron_arm_lat_R.stl, pauldron_arm_med_R.stl, pauldron_core_R.stl]
2026-10-23 Add flex electrode lead spec and 2026-10-23 design addendum
    Rigid wing rail over the electrodes removed by Forest's decision; electrodes
    stay in place and connect by flexible leads to chassis jacks. Spec records
    the decision, slack per site, the harness load-path consequence (not yet
    computed) and the gates still to run. No CAD changed.
    Claude-Session: https://claude.ai/code/session_017g7QincJ8EsLvxNXGmdhXg
2026-10-31 Adopt HAND rev B as the project hand (squash merge of claude/hand-chuck-2026-10-30)
    Human-layout micro-servo hand: organic ball-jointed fingers with hidden four-bars,
    TPU fingertip caps, sculpted palm, 8 micro servos; 4-jaw (Ø13) and 3-jaw (Ø6)
    chuck modes; open, point, thumbs-up and victory poses with no real-mesh
    interference; three.js renderer (cad/render_three.py). Replaces the C3 claw as
    the end effector (claw kept as the superseded alternate). Decision by Forest,
    2026-10-30. Wrist-v3 coupling (claude/hand-coupling-2026-10-30) still to be
    re-integrated with rev B.
    Claude-Session: https://claude.ai/code/session_012jhbAFiT81fUrdU1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
    [hand_chuck3_d6_posed.stl, hand_chuck4_d13_posed.stl, hand_open_posed.stl, hand_point_posed.stl, hand_thumbsup_posed.stl, hand_victory_posed.stl, index_bar_dip.stl, index_bar_pip.stl]
2026-11-02 J1 rev 2 flat shoulder study: mount alternatives C1-C6, joint concepts J1-J6, J1 rev 2 integration, whole-arm sweep, specs, env bootstrap
    Study and integration only; the adopted rev b design is untouched. See specs/SPEC_j1r2_integration.md.
    Claude-Session: https://claude.ai/code/session_012jhbACyUR8qvnRtan7PdsT
    [C1_armour_crown_R.stl, C1_armour_keel_R.stl, C1_armour_spaulder_R.stl, C1_s1_base_block_R.stl, C1_saddle_PACF_R.stl, C1_steel_doubler_2mm_R.stl, C2_armour_crown_R.stl, C2_armour_keel_R.stl]
2026-11-02 J1 mount alternatives: 6 concepts + REF on one harness frame model (SHOULDER/WING, concept)
    Forest: 'Explore alternative designs for the shoulder mount' (J1 pancake mount).
    REF findings: 18 mm hand-tip sag at reach, neck-extension contact 27.5 deg, clasp feet orphaned,
    real wing tongue clashes with the J1 riser, balancer still homeless. Recommended: MJ4 carbon
    K-truss + MJ1 in-tube balancer. Nothing adopted.
    Claude-Session: https://claude.ai/code/session_012jhbAFGFXqm9ePr86kshLQ
    [MJ1_bal_cord_fixed_L.stl, MJ1_bal_cord_fixed_R.stl, MJ1_bal_liner_L.stl, MJ1_bal_liner_R.stl, MJ1_bal_sheaves_L.stl, MJ1_bal_sheaves_R.stl, MJ1_clasp_bar_L.stl, MJ1_clasp_bar_R.stl]
2026-11-02 j1r2 mounts: drop placeholder radial balancer tube from renders; mark concepts 'balancer: no home'
    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
2026-11-02 j1r2 mounts round 2: spine-led concepts MJ7/MJ8/MJ10, no balancer
    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
    [MJ10_clasp_bracket_L.stl, MJ10_clasp_bracket_R.stl, MJ10_nodes_L.stl, MJ10_nodes_R.stl, MJ10_pad_L.stl, MJ10_pad_R.stl, MJ10_posts_L.stl, MJ10_posts_R.stl]
2026-11-03 MJ11 blade-seated pancake: flat pad on conformal foam dish bolted to the rail
    Pad position selectable via J1_PAD; position scans, real-parts sweep, STLs, renders, spec, DESIGN_STATE entry.
    Claude-Session: https://claude.ai/code/session_012jhbAG1mvXgD4bzPYHF5H9
    [MJ11_clasp_bracket_L.stl, MJ11_clasp_bracket_R.stl, MJ11_liner_L.stl, MJ11_liner_R.stl, MJ11_pad_L.stl, MJ11_pad_R.stl, MJ11_rail_spacers_L.stl, MJ11_rail_spacers_R.stl]
2026-11-03 MJ11 leads, liner shear, WING interface contract (study; no default geometry change)
    Claude-Session: https://claude.ai/code/session_012jhbADQT6YjFz9uePZuuiv
    [MJ11_leadmodel_infraspin_R.stl, MJ11_leadmodel_jack_block_R.stl, MJ11_leadmodel_teres_maj_R.stl]
2026-11-03 MJ11 whole-arm first-contact sweep, shoulder keep-outs, candidate elbow tier tables and keep-out map
    Claude-Session: https://claude.ai/code/session_012jhbACtGe92gT4zn3vEaJ1
2026-11-03 MJ11 clasp bracket re-fit: psi 119, anchor r 66; 4.8 mm to S1' group, 5.1 mm to rail, passive box unchanged (0.466)
    Claude-Session: https://claude.ai/code/session_012jhbAFSonTjZyAWUoZLSxb
    [MJ11_clasp_bracket_L.stl, MJ11_clasp_bracket_R.stl]
2026-11-03 MJ11 loads and balancer/torque-gate options (analysis, decision table)
    Claude-Session: https://claude.ai/code/session_012jhbAELbwaJFdt53Z7W1nR
2026-11-03 MJ11 loads: stall-layout script and data, spec typo, ignore render_tools npm files
    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
    [bal_cord_arm.stl, bal_cord_up.stl, bal_pin_B.stl, bal_sheave_A.stl, bal_tube.stl, body.stl, stage_S1_AK70.stl, stage_S1_stop_collar.stl]
2026-11-03 MJ11: re-fit fixed fairing (1.8 mm PA-CF C-shell over S1' AK70), clearance check, sweep, spec + design state
    Claude-Session: https://claude.ai/code/session_012jhbADPCgy7gtj2Qai5cEb
    [MJ11_fairing_L.stl, MJ11_fairing_R.stl, MJ11_pad_L.stl, MJ11_pad_R.stl]
2026-11-03 Ignore regenerable mount render caches
    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
2026-11-03 MJ11 loads port + torque-gate/balancer options (spec, scripts, data, figure)
    Claude-Session: https://claude.ai/code/session_012jhbADVcty4PEBewqboBAx
2026-11-03 Regenerate MJ11 eval, sweep and whole-arm tables on the merged parts
    [MJ11_fairing_L.stl, MJ11_fairing_R.stl]
2026-11-03 Overnight summary: flag fixed-part head clearance 47.8 mm
